mj42584/staircase_solidcraft_claude/CONCEPTION.md

# Conception — Escalier gab

Ce fichier décrit l'**état actuel** du projet et **le pourquoi des choix**. Les règles de travail avec l'agent sont dans [REGLES_SOLIDCRAFT_GITHUB_CLAUDE.md](REGLES_SOLIDCRAFT_GITHUB_CLAUDE.md).

## 1. Objectif

Escalier droit **à demi-tour**, deux volées séparées par un **palier intermédiaire sans différence de niveau**. Tout doit être **pilotable par des paramètres** : hauteur, giron, répartition des contremarches entre volées, profondeur du palier, largeur du jour.

## 2. Données d'entrée

Valeurs actuelles : voir les paramètres (§3). Ce tableau garde l'origine des données.

| Donnée | Origine |
|---|---|
| Hauteur totale (sol fini bas → sol fini haut) | **mesurée sur site** : dalle = sol fini bas, arrivée = dessus de la planche du cadre (`cadre_dessus` + `planche_ep`, §4) ; 3800 au départ → `hauteur_totale` |
| Angle de volée annoncé au départ | 32,4° — voir D1 |
| Répartition | choix de l'utilisateur dans l'app → `nb_volee1` — voir D2 ; volée 2 décalée d'un giron, voir D6 |
| Jour (vide entre volées) | 60 mm au départ, désormais calculé → `jour` — voir D9 |
| Marche | plaque (`marche_epaisseur`), deux équerres en cornière (`equerre_*`) symétriques |
| Limons | UPE 220, cotes **vérifiées au catalogue** EN 10365 (2026-10-26) → `limon_*` ; congés non modélisés (§4) — voir D8 |
| Palier | autoporté sur 4 pieds, sans appui sur le mur du site — voir D11 |
| Plancher du palier | même matériau et même épaisseur que les marches (`palier_ep` = `marche_epaisseur`) |
| Mains courantes | chêne carré (`mc_cote`, 45 × 45, choix de l'utilisateur, 2026-10-31), à `mc_h` au-dessus des nez, des deux côtés des deux volées, et autour du palier à `mc_palier_h`, continue avec les mains courantes ext des volées, sur potelets en fer plat fixés aux limons : choix de l'utilisateur (2026-10-30) ; profil et nombre des potelets **supposés** — voir D18 |
| Matériaux | marches, plancher et mains courantes en **chêne** (« Oak », 0,75 g/cm³) ; tout le reste en **acier S235** (nuance confirmée par l'utilisateur, 2026-11-08 ; « Steel », 7,85 g/cm³) — voir D13 |

## 3. Paramètres du modèle (`cad/escalier.solidcraft`)

**Pilotes**

| Paramètre | Valeur | Pilote |
|---|---|---|
| `hauteur_totale` | 3848 mm | hauteur de marche, arrivée |
| `nb_contremarches` | 22 | hauteur de marche, nb_volee2 |
| `nb_volee1` | 15 (16 jusqu'au 2026-10-31) | contremarches volée basse → hauteur du palier, nombre de marches V1 |
| `giron` | 274 mm | squelette, profondeur des marches, pas des réseaux |
| `emmarchement` | 1000 mm | largeur des volées et des marches, plans d'axe |
| `jeu_limons` | 200 mm | vide entre les deux limons intérieurs → `jour` (passé de 20 à 100, puis à 200 le 2026-11-07, par l'utilisateur) |
| `palier_profondeur` | 1000 mm | squelette (élévation et plan) |
| `marche_epaisseur` | 60 mm (passé de 30 à 60 par l'utilisateur) | marches, position des équerres, plancher du palier |
| `equerre_aile` | 50 mm | cornières (ailes égales) ; 30 avant D33 |
| `equerre_ep` | 5 mm | cornières ; 3 avant D33 |
| `equerre_longueur` | 200 mm | cornières, centrées sur le giron |
| `vis_d`, `vis_avant_d`, `vis_jeu` | 5, 3,5, 0,5 mm | vis à bois des cornières dans les marches (D35) : Ø nominal, avant-trou dans la marche (**supposé**), jeu du trou dans la cornière (Ø 5,5) |
| `vis_lef`, `vis_pas` | 50, 75 mm | vis à bois : longueur dans la marche (avant-trou) ; 3 vis par cornière à `giron / 2` et `± vis_pas`, au milieu de l'aile (**supposé**) |
| `debord` | 0 mm | débord du nez de marche vers l'avant |
| `limon_h` | 220 mm | hauteur UPE |
| `limon_b` | 85 mm | largeur des ailes UPE, pilote `jour` |
| `limon_tw` | 6,5 mm | épaisseur d'âme |
| `limon_tf` | 12 mm | épaisseur d'aile |
| `limon_r` | 0 mm | congé de laminage de l'UPE (catalogue : 13 mm, EN 10365), profilé des 4 limons (Frame Member) ; mis à 0 pour la vitesse de recalcul (D19) |
| `limon_dessus` | `-30 mm * giron / pas_volee` (−25,3 mm ; 0 jusqu'au 2026-10-29) | haut du limon au-dessus de la ligne de nez, perpendiculairement (0 = au ras des nez) ; négatif : limon descendu de 30 mm en vertical, pour centrer le bout du limon V1 sur la poutre avant (D17) |
| `palier_ep` | `marche_epaisseur` (60 mm) | plancher du palier |
| `platine_ep` | 15 mm | platines d'about : bas des limons V1 et V2 (côté palier) et haut des limons V2 (arrivée) ; les limons sont raccourcis d'autant |
| `boulon_d` | 12 mm | boulons des platines (M12) |
| `trou_jeu` | 2 mm | jeu des trous : largeur des oblongs = `boulon_d + trou_jeu` (14 mm) |
| `oblong_course` | 10 mm | course verticale des oblongs (entre centres d'arcs ; longueur totale 24 mm) |
| `boulons_entraxe` | 100 mm | entraxe vertical des 2 trous de chaque platine |
| `poteau_cote` | 100 mm | pieds : tube carré |
| `poteau_ep` | 5 mm | pieds : épaisseur du tube |
| `mc_h` | 900 mm | hauteur de l'axe des mains courantes au-dessus de la ligne des nez, en vertical |
| `mc_cote` | 45 mm | côté des mains courantes carrées pleines (chêne), choix de l'utilisateur (2026-10-31 ; avant : `mc_d`, rond Ø45) |
| `potelet_l` | 40 mm | potelets en tube carré : côté (choix de l'utilisateur, 2026-10-30 : 30 ; 40 depuis D34) |
| `potelet_ep` | 3 mm | potelets en tube carré : épaisseur de paroi (2 avant D34) |
| `nb_potelets_v1` | 5 | potelets par main courante V1 : 4 validés par l'utilisateur (2026-11-02), 5 depuis D32 ; pilote le nombre et le pas des trous |
| `nb_potelets_v2` | 3 | potelets par main courante V2 : 2 validés par l'utilisateur (2026-11-02), 3 depuis D32 ; pilote le nombre et le pas des trous |
| `mc_palier_h` | 1000 mm | hauteur de la main courante au-dessus du plancher du palier ; limite : `mc_palier_h - mc_h` < `hauteur_marche` (sinon le raccord V2 recule derrière le premier nez de V2) |
| `nb_potelets_fond` | 4 | potelets du fond du palier, angles compris, 3 validés par l'utilisateur (2026-11-02), 4 depuis D34 ; pilote le pas des trous du fond ; les potelets d'angle sont placés par `potelet_fond_marge` |
| `potelet_palier_retrait` | 215 mm | axe des potelets latéraux du palier (V1 et V2, face à face) depuis le bord avant du palier, et des potelets arrière depuis le bord arrière (D26) : `potelet_palier_v1_x` = `rive_x + potelet_palier_retrait` (choix de l'utilisateur, 2026-11-01 : 200 mm demandés, 215 pour que la platine haute du potelet V1 passe sous la partie horizontale, minimum ≈ 213 mm ; avant : milieu du palier) |
| `potelet_fond_marge` | 25 mm | potelets d'angle du fond : du trou extérieur de la platine haute au bout de la main courante du fond, **supposé** ; axe à `potelet_fond_y` = `jour / 2 + emmarchement + limon_b / 2 - mc_cote / 2 - platine_haut_entraxe / 2 - potelet_fond_marge` (1090 mm) du milieu du jour (D24) |
| `pied_limon_ep` | `platine_ep` (15 mm) | pied des limons V1 : épaisseur des platines verticale et au sol, **supposé** (D28) |
| `pied_limon_l` | 200 mm | pied des limons V1 : longueur de la platine au sol depuis le premier nez (largeur `limon_b`), **supposé** |
| `pied_limon_entraxe` | 80 mm | pied des limons V1 : entraxe des 2 trous Ø `boulon_d + trou_jeu` (chevilles M12 **supposées**) de la platine au sol, dans le U, centrés sur `pied_limon_l` |
| `platine_bas_l`, `platine_bas_b`, `platine_bas_ep` | 130, 50, 10 mm (8 avant D39) | platine basse des potelets, soudée (choix de l'utilisateur) |
| `platine_bas_trou` | 9 mm | trous de la platine basse (M8), percés aussi dans l'aile des limons, ou dans le plancher et l'aile du cadre au palier |
| `platine_bas_entraxe` | 100 mm | entraxe des 2 trous de la platine basse, de part et d'autre du potelet : ≈ 22 mm libres entre le potelet et le bord du trou (tête M8 + rondelle Ø16 + douille), 15 mm du trou au bout de la platine |
| `platine_haut_l`, `platine_haut_b`, `platine_haut_ep` | 100, 40, 5 mm | platine haute des potelets (largeur 30 avant D34, égale au tube) , soudée, vissée sous la main courante (choix de l'utilisateur) |
| `platine_haut_trou` | 5 mm | trous pour vis à bois Ø4,5 |
| `platine_haut_entraxe` | 80 mm | entraxe des 2 trous de la platine haute : ≈ 12 mm libres entre le potelet et le bord du trou (tête de vis à bois Ø9) |
| `poteau_r` | 10 mm | pieds : rayon extérieur du tube, **supposé** (défaut SolidCraft), à confirmer |
| `platine_pied_ep` | `platine_ep` (15 mm) | platines des pieds, en tête (boulonnée sous l'aile basse du cadre) et au sol (chevillée dans la dalle) (choix de l'utilisateur, 2026-10-31) |
| `platine_pied_marge` | 40 mm | platines des pieds : du tube au bord, **supposé** ; en tête, boulon au milieu de la marge sur l'axe de l'aile ; au sol, chevilles au milieu de la marge |
| `gousset_ep`, `gousset_l`, `gousset_h` | 10, 120, 120 mm | goussets des diagonales (D30), soudés sur la face du tube du pied tournée vers l'autre pied, dans le plan de la face, **supposé** ; trou Ø `boulon_d + trou_jeu` à mi-hauteur |
| `gousset_trou_l` | 70 mm | gousset : de la face du tube à l'axe du trou, **supposé** |
| `gousset_jeu_tete` | 50 mm | gousset haut : jeu sous la platine de tête (écrou M12 de la platine et clé), **supposé** ; le gousset bas est posé sur la platine au sol |
| `diag_cote`, `diag_ep`, `diag_r` | 40, 3, `2 * diag_ep` mm | diagonales : tube carré 40 × 40 × 3 (côté : choix de l'utilisateur, D36 ; 50 avant ; épaisseur **supposée**, D30) |
| `languette_ep`, `languette_trou_bout`, `diag_retrait`, `languette_insertion` | 10, 30, 120, 80 mm | diagonales : languette (fer plat `languette_ep` × `diag_cote`) soudée dans une fente du tube, boulonnée contre le gousset (1 M12) ; du trou au bout de la languette, du trou au bout du tube (dégage le gousset), longueur dans le tube, **supposé** |

**Calculés**

| Paramètre | Expression | Valeur |
|---|---|---|
| `hauteur_marche` | `hauteur_totale / nb_contremarches` | 174,91 mm |
| `nb_volee2` | `nb_contremarches - nb_volee1` | 7 |
| `angle_volee` | `atan(hauteur_marche / giron)` | 32,55° |
| `blondel` | `2 * hauteur_marche + giron` | 624 mm (confort 600–640) |
| `pas_volee` | `sqrt(giron ^ 2 + hauteur_marche ^ 2)` | 325,07 mm |
| `jour` | `2 * limon_b + jeu_limons` | 370 mm |
| `rive_x` | `(nb_volee1 - 1) * giron` | 3836 mm (X de la rive du palier) |
| `cadre_y` | `jour / 2 + emmarchement + limon_b` | 1220 mm (demi-largeur hors tout du cadre) |
| `limon_hv` | `limon_h * pas_volee / giron` | 261,0 mm (hauteur d'un limon en coupe verticale) |
| `pied_h` | `nb_volee1 * hauteur_marche - palier_ep - limon_h - platine_pied_ep` | 2328,6 mm (sol → dessous de la platine de tête ; le tube va de `platine_pied_ep` à `pied_h`) |
| `platine_pied_l` | `poteau_cote + 2 * platine_pied_marge` | 180 mm (côté des platines des pieds : en tête au ras de l'angle du cadre, au sol centrée sur le tube) |
| `diag_dy`, `diag_dz` | `2 * (cadre_y - poteau_cote - gousset_trou_l)`, `pied_h - platine_pied_ep - gousset_jeu_tete - gousset_h` | 2100, 2143,6 mm (entraxe des trous d'une diagonale, en travers et en hauteur) |
| `diag_longueur`, `diag_angle` | `sqrt(diag_dy ^ 2 + diag_dz ^ 2)`, `atan(diag_dz / diag_dy)` | 3000,9 mm, 45,6° |
| `diag_o_x`, `diag_o_y`, `diag_o_z`, `diag_o_d`, `diag_plan_n` | trou bas depuis l'angle du cadre (X, Y, profondeur), puis le long de la diagonale et distance de son plan à l'angle | 55, 170, 2268,6, 1501,6, 1709,0 mm |

**Cotes des esquisses** : préfixes `sqe_` / `sqp_` pour les squelettes d'élévation et de plan (convention de nommage : règles §7).

## 4. Architecture du modèle

**Repère** : origine au pied de la première contremarche, **au milieu du jour**. Volée 1 monte vers **+X** côté **Y négatif** ; volée 2 redescend en X (monte vers −X) côté **Y positif**. Z vers le haut.

**Timeline**

1. `Squelette élévation` (plan XZ, Z vers le haut, 0 DDL) — première contremarche, ligne des nez volée 1, palier horizontal à `nb_volee1 × h`, prolongé côté volée 2 d'un giron (ligne `l6`, au niveau du palier, vers −X), première contremarche volée 2 à `rive − giron`, ligne des nez volée 2 jusqu'à `hauteur_totale`.
2. `Squelette plan` (XY, 0 DDL) — emprise volée 1, palier pleine largeur (`2 × emmarchement + jour`), emprise volée 2.
3. `Axe volée 1` / `Axe volée 2` — plans de construction décalés de XZ de ∓(`jour/2 + emmarchement/2`).
4. `Foulée volée 1` / `Foulée volée 2` — ligne de nez projetée depuis le squelette d'élévation sur chaque plan d'axe.
5. `Profil marche V1` → `Marche V1` — rectangle accroché au premier nez projeté, extrudé symétrique sur `emmarchement`.
6. `Profil équerre V1` → `Équerre V1` (côté mur, « ext ») → `Symétrie équerre V1` (côté jour, « int ») par rapport à `Axe volée 1`.
7. `Réseau marches V1` — réseau sur chemin le long de `Foulée volée 1` : `nb_volee1 - 1` occurrences, pas `pas_volee`.
8. Idem volée 2 : `Profil marche V2`, `Marche V2`, `Équerre V2`, `Symétrie équerre V2`, `Réseau marches V2` (`nb_volee2` occurrences, marche orientée vers −X). `Profil marche V2` est accroché au nez du palier (`l2.end` du squelette) : la première marche V2 est **au niveau du palier**, entre `rive − giron` et la rive ; `Équerre V2` à `nb_volee1 * hauteur_marche - marche_epaisseur`. En plan, l'emprise V2 vaut `nb_volee2 * giron`.
9. `Rive ext V1` — plan décalé de `Axe volée 1` de `-emmarchement / 2` (bout des marches côté mur).
10. `Axe limon V1` (plan `Rive ext V1` : ligne des nez projetée en construction, ligne du bas du limon parallèle cotée `limon_h - limon_dessus`, prolongée de `limon_h` à chaque bout) → `Barre limon V1` (Frame Member, profilé `channel` piloté par `limon_h`, `limon_b`, `limon_tw`, `limon_tf`, `limon_r`, ancrage `bottom_right`, miroir : âme contre le bout des marches, ailes vers l'extérieur) → `Coupes limon V1` (U coté : coupe verticale à X = `pied_limon_ep`, horizontale à Z = `pied_limon_ep`, verticale à `rive_x - platine_ep`) → `Coupe limon V1` (enlèvement de `limon_b` ciblé sur le limon).
11. `Symétrie limon V1` — symétrie du **corps** `Limon ext V1` par `Axe volée 1` → `Limon int V1`.
12. Idem volée 2 : `Rive ext V2` (décalage `+emmarchement / 2` de `Axe volée 2`), `Axe limon V2`, `Barre limon V2` (ancrage `bottom_left`), `Coupes limon V2` (deux rectangles cotés : coupes verticales à l'arrivée et à `rive_x - platine_ep`), `Coupe limon V2`, `Symétrie limon V2` → `Limon ext V2`, `Limon int V2`.

13. `Dessus cadre palier` — plan XY décalé de `nb_volee1 * hauteur_marche - palier_ep` (dessus du cadre = dessous du plancher).
14. `Plancher palier` — rectangle coté X `rive_x` → `+ palier_profondeur`, Y ±`cadre_y`, extrudé de `palier_ep` vers le haut : il couvre tout le cadre, limons extérieurs compris.
15. **Pieds** : deux composants depuis D30, chacun de 4 pièces en sous-composants (D21) et **posé 2 fois**, tournés de 90° d'un angle à l'autre : `Ensemble pied gousset bas` (`:1` avant V1, `:4` arrière V2) et `Ensemble pied gousset haut` (copie indépendante, `component.paste_new` : `:1` arrière V1, `:2` avant V2 ; fonctions, cotes et corps suffixés `haut`). Les deux exemplaires d'un même type se déduisent l'un de l'autre par une rotation de 180° : même pièce. Repère local : origine à l'angle extérieur du **dessus de la platine de tête**, X et Y vers l'intérieur du cadre, Z vers le haut ; le pied pend vers le bas, si bien qu'un changement de `pied_h` allonge le tube vers le sol sans décoller la platine du cadre. Fonctions : plans `Dessous platine tête pied` (XY à −`platine_pied_ep`), `Sol pied` (XY à −(`pied_h` + `platine_pied_ep`)), `Axe pied` (XZ à `poteau_cote / 2`) ; esquisse `Platine tête pied` (carré `platine_pied_l` depuis l'origine, 2 trous Ø `boulon_d + trou_jeu` à (`limon_b / 2`, `poteau_cote + platine_pied_marge`) et symétrique) → extrusion `Platine tête` ; esquisse `Platine sol pied` (carré `platine_pied_l` centré sur le tube, 4 trous à `poteau_cote / 2 ± (poteau_cote / 2 + platine_pied_marge / 2)`) → extrusion `Platine sol` ; esquisse `Axe tube pied` (ligne verticale de `platine_pied_ep` à `pied_h` sous l'origine) → Frame Member `Tube pied` (`rect_tube`, corps `Pied`). Gousset (D30) : sous-composant `Gousset pied bas` (esquisse `Profil gousset pied bas` sur YZ à `poteau_cote / 2`, plaque de `poteau_cote` à `poteau_cote + gousset_l` posée sur la platine au sol) ou `Gousset pied haut` (XZ à `poteau_cote / 2`, plaque à `gousset_jeu_tete` sous la platine de tête), extrudés symétriques de `gousset_ep`. Cotes `pied_*` et `gousset_bas_*` / `gousset_haut_*`, 0 DDL. **Placement** : 4 liaisons rigides « en l'état » (`joint.as_built`) entre le cadre et chaque exemplaire, accrochées par leur nom au coin du dessous de l'âme de la poutre avant (`F48`) ou arrière (`F53`) : les pieds suivent `nb_volee1`, `palier_profondeur`, etc. (vérifié).
15 bis. **Diagonales** (D30) : `Ensemble diagonale` (racine, **posé 2 fois** : `:1` face avant, du gousset bas de `Ensemble pied gousset bas:1` au gousset haut de `Ensemble pied gousset haut:2` ; `:2` face arrière, tourné de 180°). Repère : celui du pied avant V1 (angle extérieur du dessous du cadre, axes du monde) ; liaisons rigides `Diagonale avant / cadre` et `Diagonale arrière / cadre` au coin de la poutre avant ou arrière, comme les pieds. Plans `Pente diagonale` (XY tourné de `diag_angle` autour de X) et `Plan diagonale` (décalé de −`diag_plan_n` : il contient l'axe de la diagonale, X normal à la languette) ; `Languette basse diagonale` / `Languette haute diagonale` (rectangles `languette_ep` × longueur sur `Plan diagonale`, extrudés symétriques de `diag_cote`, trou Ø `boulon_d + trou_jeu` coté depuis l'origine sur YZ à `diag_o_x`) ; `Tube diagonale` (axe à `languette_ep / 2` de la face du gousset, Frame Member `rect_tube`, corps `Diagonale`, de `diag_retrait` à `diag_longueur - diag_retrait`) et `Fentes tube diagonale` (2 fentes `languette_ep` × `languette_insertion` dans les parois). La languette s'appuie sur la face intérieure du gousset : l'axe du tube est décalé de (`gousset_ep` + `languette_ep`) / 2 = 10 mm du plan des pieds (excentricité non calculée).
16. Cadre en **onglet à 45°** : pour chaque poutre, une esquisse `Âme poutre …` (trapèze d'épaisseur `limon_tw`, extrudé de `limon_h` vers le bas, nouveau corps) et une esquisse `Ailes poutre …` (trapèze de largeur `limon_b`, extrudé deux fois de `limon_tf` : aile haute, et aile basse avec `start_offset`, jointes au corps). Les 4 UPE ont l'**âme à l'extérieur et les ailes vers l'intérieur**, pleine longueur jusqu'aux angles extérieurs, coupées à 45° : `Poutre avant palier`, `Poutre arrière palier`, `Poutre latérale V1`, `Poutre latérale V2`. Une esquisse et un corps par poutre, pour que les onglets jointifs ne fusionnent pas les corps.

17. **Mains courantes** (D18) : `Plan main courante V1` (décalé de `Axe volée 1` de −(`emmarchement / 2 + limon_b / 2`) : milieu du limon, demande de l'utilisateur) → `Axes main courante V1` (ligne des nez projetée et ligne du bas du limon en construction ; axe de la main courante parallèle à `mc_h` en vertical, du premier nez à `rive_x - platine_ep` ; premier potelet vertical à `giron / 2`, bas à `potelet_l / 2` en pente au-dessus de l'aile haute du limon, haut à `potelet_l / 2` en pente sous la main courante, pour qu'aucun coin ne pénètre) → `Barre main courante V1` (Frame Member `bar` carré `mc_cote`, `Main courante ext V1`) → `Symétrie main courante V1` (corps, par `Axe volée 1` → `Main courante int V1`). La ligne du premier potelet ne porte plus de pièce : elle place les platines de `Platines potelet V1`, d'où partent les perçages (étape 19). Idem V2 (`Plan main courante V2`, `Axes main courante V2`, main courante de l'arrivée `+ platine_ep` à `rive_x - giron` (premier nez de V2), premier potelet à `rive_x - 3 * giron / 2`). Les potelets eux-mêmes sont des sous-composants (étape 19).
18. **Main courante du palier** (D18), à `mc_palier_h` au-dessus du plancher : dans `Axes main courante V1`, prolongement de la main courante V1 dans son alignement jusqu'à `mc_palier_h`, puis horizontale jusqu'au fond ; dans `Axes main courante V2`, prolongement de V2 depuis le premier nez jusqu'à `mc_palier_h`, puis horizontale. En fin d'arbre (avant le dossier des trous) : `Plan section main courante palier V1` (plan perpendiculaire au début de la main courante V1, `l2` à t = 0) → `Section main courante palier V1` (carré `mc_cote` centré, 0 DDL) → `Main courante palier V1` (balayage le long de `l2`, `l5`, `l6`, **joint** à `Main courante ext V1` : une seule pièce de la volée au fond, coudes en onglet) ; idem V2. Le balayage repart du début de la barre (chevauchement), sinon l'union bout à bout laisse 2 coques (règles §8). Potelets du palier : sous-composants (étape 19). `Plan main courante fond` (YZ décalé au milieu de la poutre arrière, à `limon_b / 2` du bord du cadre) → `Axes main courante fond` → `Barre main courante fond` (entre les deux mains courantes latérales, bout à bout). Les mains courantes latérales du palier vont jusqu'à l'extérieur de celle du fond.
18 bis. **Mains courantes en pièces séparées** (D22, 2026-11-01) : les axes restent dans `Axes main courante V1/V2` (rampe `l2`, raccord `l5`, horizontale `l6`), mais chaque pièce est un **profil vu de côté extrudé symétriquement sur `mc_cote`**. Esquisse `Profil mains courantes V1` (racine, plan `Plan main courante V1`) : rampe et horizontale projetées en construction ; bande de `mc_cote` autour de la rampe (début d'équerre au début de la rampe) et autour de l'horizontale (fin verticale), séparées par la **ligne d'onglet** qui joint les intersections des bords (cotes `profil_mc_v1_*`, 0 DDL, 2 profils) → `Main courante rampe V1` (pièce `Main courante ext V1` : rampe + raccord, composant `Main courante ext V1`, ESC-701) et `Main courante palier V1` (horizontale, composant `Main courante palier V1`, ESC-706). Idem V2 (`Profil mains courantes V2`, ESC-703 et ESC-707). Mains courantes int : `Plan main courante int V1/V2` (décalé de l'axe de volée de ±(`emmarchement / 2 + limon_b / 2`)) et `Profil main courante int V1/V2` (bande autour de la rampe projetée, bouts d'équerre) → extrusion ; elles ne sont plus des symétries de la main courante ext. **Int V2 rallongée vers le bas** (demande de l'utilisateur, même jour) : la rampe est prolongée dans sa pente (ligne de construction colinéaire) jusqu'à `profil_mc_int_v2_fin_x` = `rive_x - platine_ep`, le même X que le haut de int V1 ; les deux bouts sont face à face de part et d'autre du jour, int V2 ≈ 19 mm plus haut (axe 3533 contre 3514 mm en 15/7). Les anciens Frame Member, balayages, plans et sections (`Barre main courante V1/V2`, `Symétrie main courante V1/V2`, `Main courante palier V1/V2` en balayage) sont supprimés.
19. **Potelets** (D18, D20) : 2 sous-composants, chacun un ensemble soudé de **3 pièces** (un sous-composant chacune, D21) : `Potelet volée`, `Platine basse potelet volée`, `Platine haute potelet volée` (idem `… palier` ; noms uniques dans tout le modèle, exigés par SolidCraft), avec ses esquisses dans son propre repère, origine au centre du dessous de la platine basse. `Ensemble potelet volée` **posé 16 fois** (`:1` à `:4` et `:13` ext V1, `:5` à `:8` et `:14` int V1, `:9`–`:10` et `:15` ext V2, `:11`–`:12` et `:16` int V2, tournés de 180° en V2 ; D32) : plan `Dessous platine basse potelet volée` (XY du composant : la platine basse est à plat dans son repère), `Axe potelet volée` (incliné de `angle_volee` dans le composant, vertical une fois posé, D27, `potelet_volee_h` = `mc_h - (mc_cote / 2 + limon_dessus) * pas_volee / giron`) → `Tube potelet volée` (Frame Member `rect_tube`) → `Coupe bas` / `Coupe haut potelet volée` (axe prolongé de `potelet_l` aux deux bouts, puis tube coupé en biais **au ras** du dessus de la platine basse et du dessous de la platine haute, plans `Bout bas` / `Bout haut potelet volée`) → `Platine basse potelet volée` (sur `Dessous platine basse potelet volée`) et `Platine haute potelet volée` (sur `Dessous platine haute potelet volée`), trous dans leurs esquisses, en corps séparés. `Ensemble potelet palier` **posé 8 fois** (`:1` palier V1, `:2` palier V2, `:3` à `:5` et `:8` fond, tournés de 90°, `:6` / `:7` arrière V1 / V2, D26; D34) : même construction à plat, hauteur `potelet_palier_h` = `mc_palier_h - mc_cote / 2`, tube au ras des platines. Chaque exemplaire est **lié par une liaison rigide au trou de son limon** (trou bas de la platine, `Potelet ext V1 n°1 / limon`, etc.) **ou du cadre** (`Potelet palier V1 / cadre`, `Potelet fond n°1 / cadre`, etc.) : il suit le perçage quand les paramètres changent. Les perçages restent à la racine et paramétriques : `Platines potelet V1` / `V2` (esquisses des platines sur `Axes main courante V1` / `V2`, sans fonction) → `Plan perçage limons V1` / `V2`, `Perçage limons V1` / `V2` (trous projetés, répétition d'esquisse `nb_potelets_v1` / `v2` ; les trous int de `Perçage limons V2` ne servent plus) et `Perçage limon int V2` (D25) → `Trous limon ext/int V1/V2` (commande Trou, profondeur `limon_tf + 1 mm`, dans les ensembles limon) ; `Plan perçage palier`, `Perçage palier` (10 trous + répétition du fond, pas `2 * potelet_fond_y / (nb_potelets_fond - 1)`) → `Trous palier` (plancher) et `Trous palier cadre`. Le **nombre d'exemplaires est fixe** (choix de l'utilisateur, 2026-11-01) : changer `nb_potelets_*` change les perçages, pas les potelets.

**Limons** : en Frame Member (étapes 10 et 12) : section réelle de l'UPE avec congés (33,9 cm², 26,6 kg/m) ; le profilé va d'un bout à l'autre de sa ligne, coupé d'équerre, d'où les esquisses de coupe. Platines : rectangles cotés (coin en X et en Z depuis l'origine, `platine_ep` × `limon_hv`). Cotes en distances positives, y compris sur les rives V2 (axe vertical vers −Z). Pied de V1 (D28) : limon coupé à `pied_limon_ep` du sol et du premier nez ; platine verticale contre la coupe verticale et platine au sol (2 trous dans le U), soudées au limon. En haut de V2 (arrivée), même détail que V1 côté palier : limon coupé verticalement à `(nb_volee1 - nb_volee2 - 1) * giron + platine_ep`, platine `Profil platine V2` → `Platine limon V2` en corps séparé (`Platine ext V2`), contre le plan vertical du dernier nez. `Symétrie limon V2` symétrise `Limon ext V2` et `Platine ext V2` → `Limon int V2` et `Platine int V2`. La structure d'arrivée est modélisée à part (`cad/environnement.solidcraft`, voir plus bas) ; l'assemblage platine / arrivée ne l'est pas. Côté palier : les **limons V1** sont coupés verticalement à `rive − platine_ep`, et une **platine d'about** (`Profil platine V1` → `Platine limon V1`, `platine_ep` × `limon_b` × hauteur du bout de limon) est un **corps séparé** (`Platine ext V1`), distinct du limon, à la demande de l'utilisateur. Cette fonction est insérée **avant** `Symétrie limon V1`, qui symétrise les deux corps (`Limon ext V1` et `Platine ext V1`) → `Limon int V1` et `Platine int V1`. La platine arrive contre l'âme de la poutre avant ; l'assemblage platine / poutre n'est pas modélisé. Les **limons V2**, côté palier, ont le même détail que V1 : coupés verticalement à `rive − platine_ep`, avec une platine d'about en corps séparé (`Profil platine palier V2` → `Platine palier limon V2` → `Platine palier ext V2`, sketch sur `Rive ext V2`, extrusion `limon_b`), insérée avant `Symétrie limon V2`, qui produit `Platine palier int V2`. Comme la volée 2 est décalée d'un giron (D6), la ligne de nez passe au niveau du palier à la rive ; la platine (V2 côté palier) s'arrête ≈ 20 mm sous le dessus du plancher (avec `limon_dessus` actuel). Bouts de limons sur la poutre avant (16/6, 60 mm) : V1 centré (2498 → 2759, poutre 2518,5 → 2738,5), V2 19 mm plus haut (2517 → 2778), écart dû aux platines sur des pentes opposées (2 × `platine_ep * hauteur_marche / giron`). Formules des hauts de platines (cotes `platine_*_haut_z`) : rive = `nb_volee1 * hauteur_marche + platine_ep * hauteur_marche / giron` ± décalages, haut = `hauteur_totale - platine_ep * hauteur_marche / giron` ± décalages. **Perçage des 6 platines** (strictement identiques, `ESC-250`, 15 × `limon_b` × `limon_h * pas_volee / giron` ; oblongs à la même distance du haut de platine ; côté V2, les 4 trous de la poutre avant sont donc 19,15 mm plus haut que côté V1) : 2 trous oblongs verticaux à ± `boulons_entraxe / 2` d'un centre : milieu de la platine à l'arrivée, **milieu de la poutre avant** côté palier (`nb_volee1 * hauteur_marche - palier_ep - limon_h / 2`). `Perçage platine V1` (plan YZ) → `Trous platine V1` (découpe de `Platine ext V1`, insérée avant `Symétrie limon V1`) ; `Perçage platines V2` (plan YZ, 4 oblongs) → `Trous platines V2` (découpe ciblée sur `Platine ext V2` et `Platine palier ext V2`, de `(nb_volee1 - nb_volee2 - 1) * giron` sur `nb_volee2 * giron`, insérée avant `Symétrie limon V2`). Les oblongs sont des rainures cotées en expressions (centres par rapport à l'origine, rayon, course, entraxe) (piège des oblongs, règles §8). Côté palier, V1 et V2 ont les mêmes trous, symétriques sur la poutre (16/6, 60 mm : 2578,5 / 2678,5). **Perçage de la poutre avant** : `Perçage poutre avant` (plan YZ, 8 cercles cotés en expressions) → `Trous poutre avant` (découpe de `Poutre avant palier` sur `limon_tw` depuis la rive) : trous **ronds** Ø `boulon_d + trou_jeu` (14 mm) dans l'âme, en face du **milieu** des oblongs des 4 platines côté palier ; le réglage se fait par les oblongs. Marges avec 100 / M12 (16/6, 60 mm) : côté V2, bas de l'oblong bas à ≈ 35 mm de la face intérieure de l'aile basse du limon ; trous ronds de la poutre à ≈ 36 mm de ses ailes (congés non modélisés). Les congés de laminage de l'UPE (r = 13 mm) sont modélisés sur les limons (Frame Member) mais ignorés sur le cadre du palier (section 33,1 cm² au lieu de 33,9, masse sous-estimée de 2,2 %).

**Un composant par pièce** (D20, D21) : chaque pièce réelle est un composant qui porte **ses esquisses et ses fonctions** ; les pièces soudées sont regroupées dans 8 ensembles de type « normal » (pas « inseparable », qui cacherait ses pièces dans la nomenclature) :
- `Ensemble cadre palier` → `Poutre avant palier` (avec `Perçage poutre avant` / `Trous poutre avant`), `Poutre arrière palier`, `Poutre latérale V1`, `Poutre latérale V2` ; chaque poutre a ses `Trous platines pieds poutre …` et `Trous palier poutre …` (esquisses `Perçage platines pieds` et `Perçage palier` partagées, plan `Dessous platines pieds` dans l'ensemble).
- `Ensemble limon ext V1/V2` → `Limon ext V1/V2` (Frame Member, coupes, `Trous limon ext V1/V2`), `Platine verticale pied ext V1` et `Platine sol pied ext V1` (D28 ; leurs symétries `… int V1` dans `Ensemble limon int V1`), `Platine ext V1`, `Platine ext V2`, `Platine palier ext V2` (chacune avec ses trous ; esquisse `Perçage platines V2` dans l'ensemble) ; `Ensemble limon int V1/V2` → `Limon int …` (`Symétrie limon V1/V2`, trous) et une symétrie par platine (`Symétrie platine V1`, `Symétrie platine V2`, `Symétrie platine palier V2`).
- `Ensemble pied gousset bas` (posé 2 fois) → `Platine tête pied`, `Platine sol pied`, `Tube pied`, `Gousset pied bas` ; `Ensemble pied gousset haut` (2 fois) → mêmes pièces suffixées `haut` ; `Ensemble diagonale` (2 fois) → `Tube diagonale`, `Languette basse diagonale`, `Languette haute diagonale` ; `Ensemble potelet volée` (12 fois) et `Ensemble potelet palier` (7 fois) → `Tube potelet …`, `Platine basse potelet …`, `Platine haute potelet …`. Les plans de construction restent dans l'ensemble.
- À la racine, un composant par pièce : `Plancher palier` (et `Trous palier`), `Main courante ext/int V1/V2`, `Main courante palier V1/V2`, `Main courante fond`, et un composant par réseau : `Marches V1/V2`, `Équerres ext V1/V2`, `Équerres int V1/V2` (trois réseaux par volée, D21). Squelette, plans d'axe, esquisses partagées et paramètres restent à la racine.
Composants imbriqués des ensembles posés une fois et composants de la racine **fixés** (grounded) ; ceux des ensembles posés plusieurs fois **libres** (fixés, ils ne suivent plus leur exemplaire). Esquisses et éléments de construction masqués. **Références** (`part_number`, choix de l'utilisateur 2026-11-01) : `ESC-` + 3 chiffres, une centaine par famille, l'ensemble en 0 ; pièces identiques sous la même référence (volumes et cotes vérifiés) : cadre `ESC-100` (poutres 101 avant, 102 arrière, 103 latérale V1 et V2, fusionnées le 2026-11-08 : même pièce) ; ensembles limon ext V1 200, int V1 210, ext V2 220, int V2 230 (limons 201, 211, 221, 231 ; les 6 platines d'about `ESC-250`, strictement identiques (ext et int V1, ext et int V2 à l'arrivée et au palier ; oblongs placés par rapport au haut de la platine, en référence à V1) ; platines de pied V1, ext et int : `ESC-260` sol, `ESC-261` verticale) ; pied à gousset bas 300 et à gousset haut 310 (tube 301, platine tête 302, platine sol 303, gousset 304, communs) ; potelet de volée 400 (tube 401), potelet de palier 410 (tube 411), platines basses 402 et hautes 403 communes aux deux ; marches 500, équerres 510, plancher 600, mains courantes 701 à 707 (ext V1, int V1, ext V2, int V2, fond, palier V1, palier V2) ; diagonale 800 (tube 801, languettes 802). Nomenclature (Inspecter › Vérifier › Nomenclature ; `assembly.bom {levels: top, group_children: true}`) : 16 lignes, les pièces sous chaque ensemble ; `levels: flat` : une ligne par référence. Marches et équerres comptent par composant (réseau), pas par corps.

**Trous des vis à bois** (D35) : par volée, `Perçage vis marche V1/V2` (6 cercles Ø `vis_avant_d`, 0 DDL, sur le dessous des marches) → `Avant-trous vis marche V1/V2` (coupe de `vis_lef` dans `Marche V1/V2`, avant le réseau) et `Perçage vis équerre V1/V2` (Ø `vis_d + vis_jeu`) → `Trous vis équerre ext/int V1/V2` (coupe de `equerre_ep` dans chaque cornière, avant les réseaux d'équerres) ; les copies de réseau portent les trous. **Les vis ne sont pas modélisées** (choix de l'utilisateur, 2026-11-03).

**Point d'intégration de la marche** : nez de marche, face supérieure, milieu de la largeur — c'est le point par lequel passent les lignes de nez du squelette.

Nombre de marches : chaque volée a une marche de moins que de contremarches (la dernière contremarche arrive sur le palier ou l'arrivée). Exception : la volée 2 a une marche de plus, au niveau du palier (D6). Avec 15/7 : 14 + 7 = 21 marches (palier à 2623,6 mm, rive à X = 3836, première contremarche V2 à X = 3562, arrivée à X = 1918).

**Environnement et assemblage**

**Site** (photos du 2026-10-27, mesures au téléphone à quelques cm près) : grange, dalle béton = sol fini. **Arrivée** sur un cadre en acier brut (plateforme ≈ 2,57 × 5,51 m, planche dessus), tout en **IPE 200** pour l'instant, sur poteaux avec platines au sol. **V2 arrive perpendiculairement à la poutre de 2,57 m**, en venant de l'extérieur du cadre. Autres mesures : 2,95 m sur le mur depuis une poutre grise, 1,45 m entre deux poteaux au sol, 1,1 m entre une attache de solive et l'angle du cadre. Environnement modélisé à part : **cadre rouillé, sol, mur en pierre** ; la charpente grise est ignorée (choix de l'utilisateur). Vue de dessus (croquis de l'utilisateur) : mur le long du grand côté, 6 poteaux (3 par petit côté ; 4 dans le modèle, voir ci-dessous), 2 solives parallèles au mur ; **V2 côté mur**, palier hors du cadre, **V1 côté extérieur, qui passe sous le cadre** entre le poteau du milieu et le poteau avant côté arrivée (1,45 m libres, mesure faite avec les 6 poteaux).

**`cad/environnement.solidcraft`** (2026-10-27, SolidCraft 0.24.1) : repère **X = 0 sur la face côté escalier de la poutre d'arrivée** (cadre vers −X), **Y = 0 sur la face côté mur du cadre** (cadre vers −Y, mur vers +Y), Z = 0 dessus de dalle. Paramètres : `cadre_longueur` 3788 (croquis, à confirmer, §7), `cadre_largeur` 2670, `cadre_dessus` 3788, `planche_ep` 60, `ipe_h/b/tw/tf` 200/100/5,6/8,5, `poteau_milieu` 1400 (axe depuis la face côté mur), `poutre_mur_longueur` 5510 (poutre le long du mur prolongée **au-delà** du cadre côté escalier, sens à confirmer, §7), `mur_ecart` 50, `mur_ep` 500, `mur_h` 3800, `dalle_ep` 200 ; 4 poteaux (poteaux avant supprimés par l'utilisateur). Poutres et poteaux en **Frame Member** (onglet Mécano-soudure, profilé `i_beam` piloté par `ipe_*`). **Esquisses cotées** (demande de l'utilisateur : des cotes pilotées par paramètres, pas des points en expressions) : lignes horizontales / verticales, cotes depuis l'origine en expressions (`d16`… `d53`), 0 DDL partout. Corps : `Poutre mur`, `Poutre avant`, `Poutre arrivée`, `Poutre fond`, `Solive 1`, `Solive 2` (à 1/3 et 2/3), 4 poteaux `Poteau mur/milieu arrivée/fond` (âme suivant Y), `Planche`, `Dalle`, `Mur` (plaques). Contrôles à la création : encombrements OK, 1450 libres entre poteaux, dessus planche à 3848 ; test `cadre_largeur` 2570 → 2700 → 2570 OK. Ni porte, ni matériaux. Ajouté par l'utilisateur (2026-11-07, 0.30.1) : plan `Limite pour acces` (face du mur en X 5610, décalée de `acces_limite` −3000, soit X 2610) et une ouverture dans le mur (`Esquisse ouverture acces` → `Ouverture acces`, découpe traversante) : `acces_l` 1000 de large, `acces_h` 1700 de haut, à `acces_retrait` 200 au-delà du plan (X 2810 → 3810), bas à Z ≈ 458 **non coté** (esquisse à 1 DDL) ; `acces_coupe` −200 (profondeur de la découpe, qui traverse pourtant les 500 du mur).

Hauteur libre au-dessus de V1 sous la poutre d'arrivée : `cadre_dessus − ipe_h − (nb_volee1 − nb_volee2) × hauteur_marche` = **2,19 m** en 15/7 (calculé, cotes du cadre mesurées au téléphone), au-dessus des 2 m conseillés (point fermé le 2026-11-02).

**`cad/projet_escalier.solidcraft`** (2026-10-27) : assemblage, **composants liés** `Environnement` (à l'origine, fixé / grounded) et `Escalier`, décalé de **[−1918, −1446,6, 0]** : X = −(`nb_volee1` − `nb_volee2` − 1) × `giron` (15/7 ; −2466 en 16/6, −3014 en 17/5), platine du haut de V2 plaquée contre `Poutre arrivée` ; Y choisi par l'utilisateur (jeu V2 / face du cadre, §7) ; Z = 0, pieds sur la dalle. L'escalier est **fixé (grounded)** lui aussi, contre les déplacements accidentels : le libérer avant de le repositionner, puis le refixer.

## 5. Journal des décisions

- **D1 — Angle calculé, non piloté.** 32,4° est incohérent avec giron 274 et hauteur 172,73 (arctan → 32,23°). On pilote hauteur totale + nombre de contremarches + giron ; l'angle en découle.
- **D2 — Répartition pilotable.** Départ 17/5 (palier à 2936 mm). L'utilisateur est ensuite passé à **16/6** dans l'app, puis à **14/8** un temps, puis de nouveau à **16/6**, revenu à **17/5** (2026-10-26), à **16/6** (2026-10-27) et enfin à **15/7** (2026-10-31) ; 15/7 est la valeur actuelle. Le modèle suit ces changements sans erreur.
- **D3 — Ensemble marche intégré au squelette, pas en fichier lié.** SolidCraft permet un composant lié (`component.insert_design`), mais les paramètres ne traversent pas les fichiers et le réseau sur chemin n'accepte pas les composants. Intégré, la marche est pilotée directement par `giron` et `emmarchement`.
- **D4 — Réseau sur chemin plutôt que rectangulaire.** Le chemin est une courbe du squelette : la direction suit l'angle de volée. Le nombre d'occurrences accepte une expression (vérifié).
- **D5 — Débord sans cote nulle.** SolidCraft refuse une cote de 0. L'arrière de la marche est coté depuis le nez (`giron`) et la longueur totale vaut `giron + debord`.
- **D6 — Volée 2 décalée d'un giron.** Au départ, volée 2 à l'aplomb du nez du palier (disposition classique). Changé à la demande de l'utilisateur (2026-10-26) : la première marche de V2 est au niveau du palier et la première contremarche V2 recule d'un giron (`rive − giron`). Cela règle la jonction limon V2 / palier (D12). L'escalier s'allonge d'un giron.
- **D7 — Pas d'exports versionnés** (2026-10-31, choix de l'utilisateur ; avant : STL et aperçu régénérés à chaque modification de géométrie). Seuls les `.solidcraft` sont dans le dépôt ; un export (STL, STEP, image) se fait à la demande et n'est pas commité (`.gitignore`). Pas de Git LFS : les fichiers sont petits. Exception (2026-11-08, choix de l'utilisateur) : les DXF de découpe laser, versionnés dans `plans/dxf/` ; à régénérer si une tôle change.
- **D8 — Limons UPE 220, ailes vers l'extérieur.** Comparé : fer plat 300×10 (≈ L/300), UPE 160 (≈ L/120 sur 4,1 m, trop souple, et l'équerre L 200 ne rentre pas entre les ailes), UPE 200 (≈ L/255), UPE 220 (≈ L/345). Avec `limon_dessus = 0`, la zone boulonnable de l'âme (≈ 170 mm) couvre l'équerre (≈ 45 → 177 mm sous la ligne de nez). Ordres de grandeur seulement, pas un calcul de structure.
- **D9 — Jour calculé depuis les limons.** Les ailes des deux limons intérieurs se font face dans le jour : `jour = 2 * limon_b + jeu_limons`. Le jeu est libre (`jeu_limons`).
- **D10 — Symétrie de corps, pas de fonctions.** Une symétrie des fonctions « âme + ailes » joignait les ailes copiées au limon d'origine (l'extrusion des ailes est une jonction ciblée) : on symétrise le corps entier.
- **D11 — Palier : cadre UPE + plancher dessus + 4 pieds.** Pas de mur autour. Cadre de 4 UPE (même profil que les limons, piloté par `limon_*`), âmes à l'extérieur, ailes vers l'intérieur, angles coupés à 45° et soudés (demande de l'utilisateur : poutres latérales retournées de 180° par rapport à la première version), plancher posé dessus (détail : §4, étapes 13 à 16). La poutre avant reçoit les 4 limons ; le bout du limon V1 est centré sur sa hauteur, celui de V2 19 mm plus haut (§4, D17). Pieds aux 4 coins (`poteau_*`). Liaison pied / cadre (2026-10-31, choix de l'utilisateur) : platine de tête (corps séparé dans le modèle, comme les platines des limons, soudée au pied en réalité), boulonnée par 2 M12 sous l'aile basse des deux UPE de l'angle, démontable (plutôt que pied soudé sous le cadre). Au sol, même principe : platine en corps séparé, centrée sous le pied, 4 chevilles.

- **D12 — Jonction limon V2 / palier par décalage de la volée.** But de l'utilisateur : supprimer la face verticale du limon V2 qui dépassait au-dessus du palier. Une première version (limon prolongé et posé sur le plancher) a été écartée : on a plutôt ajouté une contremarche à la volée 1 (15/7 → 16/6) et mis la première marche V2 au niveau du palier (D6). Toutes les contremarches restent égales. Le limon V2 arrive à la rive au ras du palier et couvre toute la hauteur de la poutre avant.

- **D13 — Matériaux.** Chêne pour les 21 marches (17/5) et le plancher du palier, acier pour limons, platines, équerres, cadre et pieds. Masse totale **1 146,0 kg** (acier 750,2, chêne 395,8) en 15/7 avec des marches de 60 mm, mains courantes et 19 potelets (`measure`, 154 corps, 2026-11-02 ; ≈ 893 kg en 17/5 avec des marches de 30 mm). Pour la masse, `measure` donne chaque corps de chaque exemplaire avec son matériau ; `assembly.mass_properties` ne détaille que le premier exemplaire d'un ensemble posé plusieurs fois. L'affectation se fait par nom de corps (`material.assign`) ; elle tient au recalcul et quand un corps de réseau disparaît puis revient (test 17 → 16 → 17) ; piège des corps nouveaux : règles §7.

- **D14 — Prédimensionnement par script Python** (`calc/predim.py`, bibliothèque standard seule). Il reprend à la main les paramètres du §3 et vérifie, en ordres de grandeur : marches (flexion et flèche, D30), limons V1 / V2, poutre avant (4 réactions de limons + demi-palier), flambement des pieds (libres en tête, L_cr = 2 H), cisaillement des boulons M12. Hypothèses : q = 2,5 kN/m², Q = 2 kN (AN française, cat. A), chêne D30, acier **S235 supposé**, boulons 8.8 supposés, flèche L/300. Résultats (en 3800 / 17/5 / 30 mm, voir §7) : **marches de 30 mm insuffisantes** (contrainte 100 %, flèche 6,3 mm pour 3,3 admis, **38 mm minimum**) ; limons, poutre avant, pieds et boulons à ≤ 12 %. Le limon V1 donne une flèche de 2,0 mm sur 5,18 m (≈ L/2580), bien moins que les ≈ L/345 de D8 : les hypothèses de charge de D8 ne sont pas connues, on garde le script comme référence. Pas un calcul de structure.

- **D15 — Modèle en barres PyNite** (`calc/portique.py`, PyNiteFEA 3.2, paramètres et hypothèses importés de `predim.py`). Barres : 4 pieds, cadre du palier (poutre avant coupée aux 4 limons), 4 limons, liaisons rigides courtes pour l'excentricité des platines sur l'âme de la poutre avant (≈ 29 mm, centre de cisaillement de l'UPE à 32 mm de l'âme). Appuis (choix de l'utilisateur) : **pieds et pieds de limons V1 encastrés** (platines chevillées dans une dalle béton, à terme), haut des limons V2 articulé (boulonné à la structure supérieure), limons articulés sur la poutre avant. **Pas de garde-corps** pour l'instant : seules forces horizontales = défauts de verticalité EN 1993-1-1 (φ ≈ 1/253). Les marches ne relient pas les limons (côté sécurité). UPE 220 : A et I fort du catalogue, Iz (244 cm⁴) et J (11,6 cm⁴) calculés sans congés. Résultats ELU (en 3800 / 17/5 / 30 mm) : déplacement horizontal du palier 0,12 mm, poutre avant 7 % en flexion et 9 % en torsion (Saint-Venant), pieds 1 %, limons V1 11 %. Efforts aux appuis : poteau N 7,3 kN, M 0,15 kN·m ; **pied de limon V1 N 10,4 kN, V 5,6 kN, M 6,2 kN·m** ; **arrivée V2 N 5,3 kN, V 5,7 kN**. Équilibre vérifié (43,5 kN de charges = réactions). Le palier est tenu horizontalement par les limons (effet de bracon entre la dalle et l'arrivée), pas par les pieds.

- **D16 — Visualisation PyVista directe** (`calc/visu.py`). Le module `Pynite.Rendering` impose IPython et trame (pile Jupyter) : écarté, on dessine directement avec PyVista à partir des résultats de `portique.py`. Deux vues en projection parallèle, côté V1 : moment fléchissant |M| ELU_X en couleur, déformée ELS_X × 300 sur la géométrie initiale ; appuis en points noirs. Sans écran : `xvfb-run -a python3 calc/visu.py --png DOSSIER`. Les liaisons rigides (excentricité des platines) ne sont pas dessinées.

- **D19 — Limons sans congés de laminage** (2026-10-30, choix de l'utilisateur). `limon_r` 13 → 0 : les congés de l'UPE faisaient reprendre les booléens des perçages (§6.3) ; recalcul complet 50 → 33 s. Modèle −2,1 % d'acier par limon (127,0 → 124,3 kg pour le limon ext V1) ; l'UPE acheté garde ses congés et le calcul prend les valeurs du catalogue. 0 erreur, 0 interférence.

- **D18 — Mains courantes sur potelets** (2026-10-30, choix de l'utilisateur : deux côtés, chêne Ø45, puis carré 45 × 45 le 2026-10-31, 900 mm, potelets sur limons). Potelets en tube carré 30 × 30 × 2 (d'abord fer plat 40 × 10, remplacé à la demande de l'utilisateur ; rayon d'angle par défaut de SolidCraft), la main courante à leur aplomb, **au milieu des limons et des poutres du cadre** (demande de l'utilisateur, 2026-10-30 ; d'abord contre l'âme) : les potelets des volées sont posés et fixés sur l'aile haute du limon, plus contre l'âme. Symétrie des corps avant les réseaux, et un réseau par corps : les noms des potelets restent justes quand leur nombre change (le piège des réseaux à plusieurs corps, règles §8, est évité). Fixation (choix de l'utilisateur, 2026-10-30) : platine basse soudée au potelet, boulonnée M8 sur l'aile haute du limon (ou à travers le plancher dans l'aile du cadre au palier) ; platine haute soudée, vissée sous la main courante (vis à bois) ; platines parallèles à la pente sur les volées, potelets coupés en biais (plus de jour). Simplifications : visserie non modélisée, potelets du palier posés sur le plancher (platine et boulonnage dans l'aile haute du cadre non modélisés). Palier (même jour, choix de l'utilisateur) : main courante à 1000 mm, continue avec les mains courantes ext des volées (sur ≈ 157 mm au bord du palier, elle passe de 900 à 1000 mm) ; mains courantes ext d'une seule pièce de la volée au fond du palier, coudes en onglet (balayage d'un carré joint à la barre de la volée ; d'abord Pipe rond en pièce séparée) ; les mains courantes V2 s'arrêtent au premier nez de V2. Remplissage du garde-corps à venir. Revue du 2026-11-02 : hauteurs conformes à la NF P01-012 (dessus de la main courante à 922,5 mm au-dessus des nez, 1 022,5 mm au-dessus du palier) ; main courante int V1 à 16,6 mm du `Poteau milieu arrivée` dans le projet, acceptée par l'utilisateur. Masse des mains courantes et potelets : ≈ 69 kg en rond Ø45, ≈ 75 kg en carré (mains courantes 26,6 kg de chêne).

- **D20 — Pièces soudées en sous-composants, avec leurs fonctions** (2026-11-01, demande de l'utilisateur). Une première version (2026-10-31) ne déplaçait que les corps (`component.move_bodies`, fonctions `BodyTransfer`) ; refaite pour que chaque ensemble porte son historique (`component.move_features`). SolidCraft refuse de déplacer une fonction qui touche des corps de plusieurs composants : d'où les perçages scindés (§4). Une fonction d'un ensemble peut s'appuyer sur une esquisse de la racine, et une symétrie sur un corps d'un autre ensemble (vérifié). Les 4 pieds sont **un seul composant posé 4 fois** (idée de l'utilisateur), placé par des liaisons rigides au cadre plutôt que par un décalage chiffré, qui ne suivrait pas les paramètres (règles §8). Contrôles : 112 corps aux volumes, matériaux et centres de gravité identiques à avant (seuls les noms des pièces des pieds changent) ; 0 erreur, 0 interférence ; allers-retours `nb_volee1`, `palier_profondeur`, `jeu_limons`, `poteau_cote`, `platine_pied_ep`. Limites : le projet d'assemblage ne voit qu'un bloc `Escalier` à plat ; la nomenclature ne liste que les composants, pas les corps restés à la racine. Platines d'about des limons soudées au limon, puis boulonnées au reste (confirmé par l'utilisateur, 2026-11-02). Potelets (2026-11-01, demande de l'utilisateur : « la même logique pour les potelets ») : 2 composants posés 12 et 5 fois, liés aux trous des limons et du cadre ; les 17 nouveaux potelets recouvraient exactement les anciens (interférence = volume entier, 255 328 et 271 881 mm³) avant suppression de l'ancien arbre (Frame Member, coupes, platines, symétries, réseaux) ; 0 erreur, 0 interférence ; allers-retours `nb_volee1`, `giron`, `palier_profondeur`, `mc_h`, `potelet_l` sans erreur ni interférence, potelets recalés sur les trous. Puis (même jour, demande de l'utilisateur) chaque potelet en 3 corps dans le même composant, comme le pied : le tube ne pénètre plus les platines (sinon interférence), il est coupé au ras ; cela comble un jour qui existait côté haut de la pente sous la platine haute (le tube s'arrêtait à l'axe), volume +192 mm³ par potelet de volée ; 0 erreur, 0 interférence (146 corps). Limite : nombre d'exemplaires fixe (12 + 7 potelets, 4 pieds), accepté par l'utilisateur le 2026-11-02 ; au palier, la liaison tient au trou de l'aile du cadre, pas au dessus du plancher (un changement de `palier_ep` laisserait les potelets du palier à l'ancienne hauteur).

- **D21 — Un composant par pièce** (2026-11-01, demande de l'utilisateur : « un composant pour chaque corps avec les fonctions qui lui sont liées dedans »), pour une nomenclature qui liste les pièces. Exception choisie par l'utilisateur : marches et équerres restent en réseaux (le nombre suit `nb_volee1`), un composant par réseau ; chaque réseau de marches est scindé en trois (marche, équerre ext, équerre int), ce qui règle le piège des noms (§6.3). Fonctions qui touchaient plusieurs pièces scindées (perçages du cadre, `Trous platines V2`, symétries des limons). Les liaisons accrochées au cadre et aux limons ont été reprises sur les composants imbriqués ; pieds et potelets ont été dépliés (copies supprimées, fonctions rangées dans le premier exemplaire, copies reposées aux mêmes matrices et reliées). Contrôles : 146 corps aux volumes, encombrements et matériaux identiques ; 0 erreur ; 0 interférence ; essai `nb_volee1` 16 + `giron` 280 + `palier_profondeur` 1200 identique pièce par pièce au même essai sur `main` (CLI), sauf les noms des marches et équerres, désormais justes. Les ensembles passent de « inseparable » à « normal ». Nomenclature : marches et équerres comptées par réseau (2 et 4 lignes, pas 21 marches et 42 équerres), gardé pour que leur nombre suive `nb_volee1` (choix de l'utilisateur, 2026-11-02).

- **D22 — Mains courantes ext : rampe et palier en deux pièces** (2026-11-01, demande de l'utilisateur : rampe + raccord d'une pièce, horizontale du palier d'une autre ; « retracer chaque pièce proprement »). Chaque pièce est construite directement à sa longueur par un profil vu de côté extrudé sur `mc_cote`, l'onglet au raccord étant une arête commune des deux profils (pas de découpe puis retrait). Int V2 rallongée jusqu'au X du haut de int V1 (+259 mm en plan, 3 913 540 → 4 535 766 mm³). Contrôles : volumes ext + palier = ancienne main courante (V1 11 259 301 mm³, V2 6 497 179 mm³) ; int V1 identique, int V2 identique avant rallonge ; 148 corps, volume total inchangé ; 0 erreur ; 0 interférence ; essai `nb_volee1` 16, `giron` 280, `mc_h` 1000, `mc_palier_h` 1100, `mc_cote` 50 identique à `main` pièce par pièce (ext + palier = ancienne main courante, même encombrement).

- **D23 — Potelets latéraux du palier près du bord avant** (2026-11-01, demande de l'utilisateur, capture à l'appui) : les deux potelets du palier (`Potelet palier V1/V2`) passent du milieu du palier à `potelet_palier_retrait` du bord avant, pour soutenir le début des mains courantes du palier (D22). À 200 mm, la platine haute du potelet V1 chevauchait le bout en pente de la rampe ext V1 avant l'onglet (1 356 mm³) ; l'utilisateur a choisi 215 mm pour les deux. Perçages du plancher et du cadre et potelets suivent (liaisons aux trous) ; 0 interférence ; essai `nb_volee1` 16, `palier_profondeur` 1200, `giron` 280 : potelets toujours au retrait du bord, 0 erreur. Distance fixe gardée (choix de l'utilisateur, 2026-11-02) : avec `mc_h` 850 (ou `mc_palier_h - mc_h` plus grand), l'onglet de la rampe ext V1 recule et touche le potelet V1 (tube 2 554 mm³, platine haute 10 797 mm³) ; à 1000, rien ; contrôler les interférences si ces paramètres changent.

- **D24 — Potelets d'angle du fond rentrés sous la main courante du fond** (2026-11-02, choix de l'utilisateur). Le potelet d'angle était centré sur le bout de la main courante du fond (65 mm du bord du cadre) : le trou extérieur de sa platine haute tombait sous la main courante latérale du palier, à 5 mm de sa face extérieure (2,5 mm de chêne autour d'une vis Ø4,5). Il est rentré de 65 mm (`potelet_fond_marge`, 25 mm **supposé**) : ses deux vis sont dans la main courante du fond, la platine basse reste sur l'aile de la poutre arrière (le trou extérieur passe de la poutre latérale à la poutre arrière, liaison `Potelet fond n°1 / cadre` reprise sur la poutre arrière). Le pas de la répétition du fond suit désormais `potelet_fond_y` (il était resté à l'ancienne expression). 0 erreur, 0 interférence ; essai `emmarchement` 1100, `jeu_limons` 150, `mc_cote` 50, `palier_profondeur` 1200 : vis toujours à 25 mm du bout, 0 interférence.

- **D25 — Premier potelet de int V2 en face du dernier de int V1** (2026-11-02, choix de l'utilisateur). Avec int V2 rallongée (D22), le bout dépassait de 408 mm après le premier potelet de int V2 (`Ensemble potelet volée:11`, X = `rive_x - 3 * giron / 2`). Ses trous sont maintenant dans une esquisse à part, `Perçage limon int V2` (plan `Plan perçage limons V2`, points de `Platines potelet V2` projetés) : paire basse décalée le long de la pente de `(giron - platine_ep) * pas_volee / giron`, soit X = `rive_x - platine_ep - giron / 2` comme le dernier potelet de int V1 (`:8`), répétition propre jusqu'au potelet du haut, qui ne bouge pas (`:12`, en face de `:10`). Porte-à-faux ramené à 149 mm, comme int V1. `Trous limon int V2` pointe sur la nouvelle esquisse ; les liaisons ont suivi (noms des trous inchangés). Les potelets int V2 ne sont plus en face des ext V2 en bas. La répétition de `Perçage limons V2` ne pouvant pas perdre ses trous int (SolidCraft refuse de changer les entités d'une répétition, et supprimer une entité la défait), ces trous y restent, inutilisés. 0 erreur, 0 interférence ; essai `nb_volee1` 16, `giron` 280, `nb_potelets_v2` 3 : 0 erreur, 0 interférence.

- **D26 — Un potelet de plus à l'arrière de chaque main courante latérale du palier** (2026-11-02, demande de l'utilisateur). Depuis D24, le potelet d'angle du fond est sous la main courante du fond : chaque main courante latérale du palier ne tenait plus que sur son potelet avant. Deux exemplaires de plus de `Ensemble potelet palier` (`:6` côté V1, `:7` côté V2), symétriques des potelets avant : axe à `rive_x + palier_profondeur - potelet_palier_retrait` (X 4621), sur l'axe des poutres latérales ; 4 trous ajoutés à `Perçage palier` (cotes `percage_palier_arriere_*`), percés dans le plancher et les poutres latérales par les découpes existantes (tous les profils) ; liaisons rigides `Potelet palier arrière V1/V2 / cadre` au trou côté avant de la platine. Écartement 570 mm avec le potelet avant, ≈ 195 mm de main courante au-delà vers le fond ; platine basse à 82 mm de celle du potelet d'angle. 0 erreur, 0 interférence ; essai `nb_volee1` 16, `palier_profondeur` 1200 : potelets toujours à 215 mm du bord arrière, 0 interférence.

- **D27 — Potelets de volée verticaux quel que soit le giron** (2026-11-02, demande de l'utilisateur). Les liaisons des 12 potelets de volée accrochaient le potelet par un repère figé dans son composant, incliné de l'angle de volée du moment de la pose (32,55°), alors que la platine basse s'inclinait de `angle_volee` dans le composant : quand `giron` changeait, tout le potelet tournait de l'écart (≈ 1° à `giron` 280). Le composant est retourné : platine basse à plat dans son repère (plan `Dessous platine basse potelet volée`, ex-`Pente potelet volée`, à 0°), tube incliné de `angle_volee` (esquisse `Axe potelet volée` : angle `potelet_volee_axe_angle` avec l'axe Z projeté, distance `potelet_volee_axe_haut` de l'origine au haut de l'axe) ; plans, coupes et platine haute inchangés (même position relative au tube). Les 12 liaisons `Potelet … / limon` ont leur repère côté potelet au centre du trou de la platine basse, normale à la platine, indépendant de l'angle. Contrôles : 154 corps identiques à avant (volume et encombrement) ; 0 erreur, 0 interférence ; `giron` 280 et 260 : les 12 tubes font 30 mm de large en plan (verticaux), 0 interférence.

- **D28 — Pied des limons V1 : platine verticale et platine au sol** (2026-11-02, choix de l'utilisateur). Chaque limon V1 est raccourci de `pied_limon_ep` au sol et au premier nez (`Coupes limon V1`, cotes `coupes_limon_v1_pied_x/z`). Deux platines soudées au limon, dans `Ensemble limon ext V1` (composants `Platine verticale pied ext V1`, `Platine sol pied ext V1`, esquisses sur `Rive ext V1` retourné, extrusion `limon_b`) et par symétrie dans `Ensemble limon int V1` : verticale de X 0 à `pied_limon_ep`, de `pied_limon_ep` jusqu'au dessus du limon (`hauteur_marche + limon_dessus * pas_volee / giron + pied_limon_ep * hauteur_marche / giron`) ; au sol, `pied_limon_l` × `limon_b` × `pied_limon_ep`, 2 trous Ø `boulon_d + trou_jeu` à `pied_limon_l / 2 ± pied_limon_entraxe / 2`, au milieu du U (entre l'âme et le bord des ailes), accessibles par le côté ouvert du U (≈ 130 mm sous l'aile haute). Le bout de l'aile basse du limon s'arrête vers X ≈ 205 mm (calculé, non mesuré), juste au-delà des 200 mm de la platine. Contrôles : platines 177 843 et 250 383 mm³ (trous compris), limons V1 −75 034 mm³ chacun, rien d'autre ne bouge (158 corps) ; 0 erreur, 0 interférence ; essai `giron` 280, `nb_volee1` 16, `emmarchement` 1100, `pied_limon_ep` 20, `pied_limon_l` 220 : platines et coupes suivent, 0 interférence, retour identique. Dalle non percée (projet en suspens).

- **D29 — Stabilité du palier recalculée** (2026-11-02, demande de l'utilisateur : contreventement du palier). `predim.py` et `portique.py` en 3848 / 15/7 / 60 mm ; dans `portique.py`, pieds des limons V1 **articulés** (D28), poussée sur les mains courantes `q_gc` = 0,6 kN/m **supposée** (cat. A, AN française, à confirmer), sur toutes les lignes à la fois, dans le sens des défauts de verticalité et à l'axe des barres, et tête des pieds calculée **rigide puis articulée** (platine à 2 M12, entre les deux). En long (X) : 0,04 mm, les limons font bracon. **En travers (Y)**, seuls les 4 pieds en console tiennent le palier : tête rigide 3,2 mm (40 % de H/300), pied de poteau M = 2,9 kN·m (≈ 10 kN par cheville M12) ; tête articulée **11,5 mm (141 %)**, M = 5,2 kN·m (≈ 18 kN par cheville, ordre de grandeur, bras de levier 140 mm). Limons vérifiés en flexion forte + faible (poussée) : V1 31 % ; pieds 42 % ; le reste ≤ 11 % ; marches de 60 mm à 25 %. Corrigés au passage : signe de l'effort normal des pieds (PyNite compte la compression positive, il était soustrait), barres « rigide » ramenées de 1e12 à 1e10 (au-delà, PyNite rejette le système, mal conditionné par ce palier souple en Y). Rapport complet : `calc/rapport_calcul.pdf` (source `calc/rapport/rapport_calcul.html`, figures `calc/rapport/figures.py`, PDF par LibreOffice), qui remplace le rapport du 2026-10-27. Ordres de grandeur, pas un calcul de structure.

- **D30 — Contreventement du palier en travers : une diagonale en tube par face d'about** (2026-11-03, choix de l'utilisateur, plutôt qu'une croix de tirants : un tube travaille dans les deux sens). Dans `portique.py`, une diagonale en face avant (sol en −Y → tête en +Y) et une en face arrière, en sens inverse, articulées en tête d'un pied et au pied de l'autre ; tube 50 × 50 × 3 **supposé** ; poussée et défauts calculés dans les deux sens, et avec G favorable (1,0) pour le soulèvement. Résultats (tête des pieds rigide / articulée) : palier en travers **0,28 / 0,29 mm** (11,5 mm sans diagonales) ; diagonales 8,7 kN, **31 %** au flambement (L = 3,46 m, à l'axe du cadre), 7 % en traction ; pieds 6 / 4 % (L_cr = H). Pied de poteau : N 13,1 kN, V 6,2 kN, M 0,3 kN·m, **soulèvement 4,3 kN** ; le reste inchangé (limons V1 31 %). Le jeu des trous des goussets (2 mm) n'est pas compté. Ordres de grandeur, pas un calcul de structure. **3D** (même jour, option « goussets sur les pieds » choisie par l'utilisateur, plutôt que des platines propres sous le cadre et au sol) : 2 types de pieds (gousset bas / haut, §4 étape 15) et un `Ensemble diagonale` posé 2 fois (étape 15 bis), 1 M12 par bout (articulation, comme le calcul). Une première version liée au trou du gousset ne suivait pas les paramètres (liaison sur un sous-composant libre d'un ensemble posé plusieurs fois : piège ajouté aux règles §8) ; refaite avec l'origine à l'angle du cadre et liée à la poutre. Les nœuds réels ne sont pas ceux du calcul : trous à 170 mm des angles du cadre en travers, à 75 mm du sol et 125 mm sous le cadre (diagonale 3,00 m à 45,6°, contre 3,46 m d'axe en axe dans `portique.py`). Contrôles : volumes des pièces conformes au calcul (gousset 142 461 mm³, languette 113 461, tube 1 477 537 ; diagonale 13,4 kg) ; 168 corps ; 0 interférence ; essai `nb_volee1` 16, `palier_profondeur` 1200, `jeu_limons` 150, `emmarchement` 1100, `poteau_cote` 120 ensemble : 0 erreur, 0 interférence, trous des languettes dans l'axe de ceux des goussets (encombrements au dixième de mm), retour identique. **Calcul recalé** sur ces nœuds (même jour, demande de l'utilisateur) : goussets en barres rigides soudées aux pieds, de l'axe du pied (angle du cadre dans le modèle) au trou, soit 170 mm au lieu de 120 (côté sécurité pour la flexion des pieds) ; tête rigide / articulée : diagonales 8,4 / 8,9 kN, **25 %** au flambement (L = 3,00 m), 7 % en traction ; pieds 9 / 14 % ; palier en travers 0,27 / 0,32 mm ; soulèvement 4,4 kN ; chevilles des poteaux **2,5 kN** de traction par cheville (1,8 avant) ; le reste à ±1 %.

- **D31 — Revue externe du calcul, garde-corps non conforme** (2026-11-03, revue DeepSeek transmise par l'utilisateur ; suite donnée au §8 du rapport). `predim.py` : poids des mains courantes et potelets (65,6 kg, `assembly.mass_properties`) en G, potelets en console sous `q_gc` à hauteur de main courante (pas relevé dans le modèle : 1 403 mm en pente sur V1, 1 090 au fond) et vis M8 de leur platine basse (2 vis dans l'axe du limon, bras de levier `platine_bas_b / 2`). `portique.py` : efforts par cheville, assertion d'équilibre de chaque combinaison, torsion de Saint-Venant des limons seuls sous le couple de la poussée (hors modèle, borne haute). Résultats : **potelets 30 × 2 à 255 % (volées) et 213 % (fond), vis M8 à 111 %, torsion des limons V1 seuls à 331 %** (marches non comptées) ; chevilles ≤ 1,8 kN de traction et 3,6 kN de cisaillement (résistance non fournie) ; le reste inchangé à ±2 %. Non retenus : longueur de main courante (2 limons V1 + 2 V2 = 15,9 m de barres, confirmé par l'équilibre), L_cr à l'axe du cadre (côté sécurité), plancher 2/3 de α_h (norme). Ordres de grandeur, pas un calcul de structure.
- **D32 — Un potelet de plus par main courante de volée** (2026-11-03, demande de l'utilisateur, après la revue du calcul : potelets 30 × 2 à 255 %, vis M8 à 111 %, D31). V1 passe de 4 à 5 potelets, V2 de 2 à 3, **premier et dernier en place**, les autres répartis : pas de V1 1182 → 887 mm en plan (1402,7 → 1052 le long de la pente), pas de V2 ext 1355 → 677,5 mm et int 1914,8 → 957,4 mm le long de la pente. Les répétitions d'esquisse `Perçage limons V1` et `Perçage limons V2` (`pat1`) prennent maintenant `nb_potelets_v1` / `nb_potelets_v2` en nombre et en pas (`((nb_volee1 - 1) * giron - giron - platine_ep) / (nb_potelets_v1 - 1) / cos(angle_volee)` pour V1, `((nb_volee2 - 2) * giron - platine_ep) / (nb_potelets_v2 - 1) / cos(angle_volee)` pour V2 ext) ; `Perçage limon int V2` le faisait déjà. Les 4 fonctions `Trous limon ext/int V1/V2` listent les points des trous ajoutés (`p17`–`p20` pour V1, `p11`–`p14` ext V2, `p7`/`p8` int V2) : **un point oublié = pas de trou**, la fonction garde sa liste. Les liaisons des potelets existants suivent leur trou ; 4 exemplaires de plus (`:13` à `:16`), posés par `occurrence.copy` + translation d'un pas puis liés au trou du dernier groupe (`joint.as_built`, `circle`), 0 DDL. 180 corps (+12 : 4 potelets × 3 pièces ; 168 → 180), limons −1,5 cm³ chacun (2 trous), 0 erreur, 0 interférence (180 corps contrôlés) ; essais `nb_volee1` 16 + `giron` 280, `palier_profondeur` 1200 + `emmarchement` 1100 : 0 erreur. `predim.py` : `nb_potelets_v1` = 5 (V2 non contrôlé, §7). Calcul **non relancé** avec ces pas (potelets V1, vis M8).
- **D33 — Cornières des marches en 50 × 50 × 5** (2026-11-03, demande de l'utilisateur, d'après l'essai des marches comme traverses : l'aile de 30 mm donnait un bras de levier de ≈ 15 mm aux vis à bois, ≈ 25 mm avec 50). Seuls `equerre_aile` et `equerre_ep` changent (30 × 3 → 50 × 5, longueur `equerre_longueur` inchangée). Volume d'une cornière 34 200 → 95 000 mm³ (section 475 mm², arêtes vives), 42 cornières, ≈ +20 kg d'acier ; 180 corps, 0 erreur, 0 interférence ; essai `nb_volee1` 16, `giron` 280, `marche_epaisseur` 40 : 0 erreur. **Non vérifié** : soudure de l'aile sur l'âme, trous de fixation des marches (pas modélisés), tenue de l'aile en flexion sous les vis (≈ 300 MPa estimés, voir l'essai), poids des cornières dans `predim.py` (`equerres_g`, déjà à 50 × 50 × 5 en essai).
- **D34 — Potelets en tube 40 × 40 × 3, un potelet de plus au fond** (2026-11-03, demande de l'utilisateur ; d'abord calculé dans `predim.py` : potelets V1 191 % → 73 %, fond 213 % → 55 %, vis M8 84 %). `potelet_l` 30 → 40, `potelet_ep` 2 → 3 (**épaisseur supposée** : la demande s'arrêtait à « 40 par 40 par », 3 mm confirmé par l'utilisateur), `platine_haut_b` 30 → 40 (la platine haute ne doit pas être plus étroite que le tube) ; le reste suit les paramètres. `nb_potelets_fond` 3 → 4 : le pas des trous du fond `2 * potelet_fond_y / (nb_potelets_fond - 1)` passe de 1090 à 726,7 mm (le motif `Perçage palier` prend `nb_potelets_fond` et ce pas ; les découpes du plancher et de la poutre arrière prennent tous les profils, rien à ajouter) ; 8ᵉ exemplaire de `Ensemble potelet palier` (`:8`) à y = 1090, lié au trou de la poutre arrière (`Potelet fond n°4 / cadre`, 0 DDL) ; les n°2 et n°3 ont suivi leurs trous (y = −363,3 et 363,3). 183 corps (+3), 0 erreur, 0 interférence ; essai `nb_volee1` 16, `palier_profondeur` 1200, `emmarchement` 1100, `mc_cote` 50 : 0 erreur. **Non vérifié** : vis des platines hautes à 40 mm de large (trous Ø5 entraxe 80 mm, marge latérale 17,5 mm), vis M8 à 84 % (inchangée). Ensuite (même jour) : `predim.py` actualisé, poids des potelets 40 × 40 × 3 (16 × 3,489 + 8 × 3,742 kg, `g_gc` +≈ 20 %, effet ≤ 2 % sur les autres taux) et potelets de V2 contrôlés (ext pas 804 mm : 56 %, vis M8 64 % ; int pas 957 mm : 67 %, vis M8 76 %) ; `portique.py` relancé, résultats inchangés à ±1 %.
- **D35 — 3 vis à bois par cornière, trous seulement dans le modèle** (2026-11-03, demande de l'utilisateur). Calcul : `K_VIS` = 7e7 N·mm/rad (plafond), limons V1 en torsion 11 %, vis la plus tendue 66 % de l'arrachement (ρk 530, D40) (`predim.py`, `portique.py`). Modèle : avant-trous Ø `vis_avant_d` dans les marches et trous Ø `vis_d + vis_jeu` dans les cornières, aux positions du calcul (§4) ; les 126 vis ne sont pas modélisées (poids du recalcul : 126 corps, 12 réseaux). Essai `nb_volee1` 16, `giron` 280, `vis_pas` 60 : 0 erreur.
- **D36 — Diagonales en tube 40 × 40 × 3** (2026-11-03, demande de l'utilisateur, après essai de 50 × 50 × 5 en cornière : 98 % au flambement en idéal, excentricité en plus, écartée). `portique.py` : flambement 43 % (tête rigide) / 46 % (articulée) pour L = 3001 mm et 8,0 / 8,6 kN (50 × 50 × 3 : 23 / 25 %), traction 8 %, palier en travers 0,31 / 0,37 mm, chevilles ≤ 2,3 kN en traction et 1,5 kN au pied des poteaux. Modèle : `diag_cote` 50 → 40, tout suit (languettes, fentes `diag_cote + 2 mm`, tube) ; 0 erreur, 0 interférence. Rapport mis à jour (valeurs). Ordres de grandeur, pas un calcul de structure.
- **D37 — Chevilles des pieds vérifiées avec des hypothèses** (2026-11-03, demande de l'utilisateur ; béton C25/30 non fissuré, choix de l'utilisateur sur ma proposition). `predim.py` : cheville M12 8.8 **supposée** (`hef` 70 mm, formules EN 1992-4 de mémoire : cône, acier, levier, bord), groupe loin des bords, `gM` béton 1,8 ; `portique.py` : contrôles par appui. Résultats : pieds de poteau T 1,95 kN (cône 16 %), V 1,47 kN (6 %) ; pieds de limons V1 V 3,61 kN (levier 15 %) ; interaction ≤ 8 %. **Non fournis** : référence de la cheville (ETA), épaisseur de la dalle, distances au bord (le cisaillement vers un bord n'est pas conclu : `c_min` de l'ETA, ordre de 100 mm). À remplacer par l'ETA ; ordres de grandeur, pas un calcul de structure.
- **D38 — Vérifications locales et une seule volée chargée** (2026-11-03, demande de l'utilisateur). `calc/assemblages.py` (nouveau, lancé après `predim.py`) : soudure gousset / pied (a 3,5 supposé) 14 %, boulon M12 des diagonales 27 %, languette (pression diamétrale 15 %, section nette 13 %, soudure dans les fentes 6 %), diagonale avec l'excentricité (5 mm au plan de contact, flexion amplifiée) 52 % ; **platine basse des potelets 8 mm : 106 %** (tronçon en T, mode 2 avec effet de levier ; 10 mm → 84 %, la vis M8 gouverne) ; aile du limon sous les M8 84 % ; déversement de la poutre avant (ailes libres, L 2440) 17 %, limons tenus par les marches ; poutre avant flexion + gauchissement (couples R × 30 mm des 4 limons, fourches) 19 % ; **couple de la poussée sur la poutre arrière : 98 %** en torsion de Saint-Venant (borne haute ; latérales 40 %) ; fréquences propres ≥ 19 Hz (limon V1 19, V2 77, poutre avant 25 ; repère 5 Hz supposé). `portique.py` : combinaisons `_V1seul` / `_V2seul` (une volée déchargée) : aucun résultat ne change. Plancher du palier : couvert par la vérification des marches (même chêne 60 mm, portée ≤ 1000 mm). Ordres de grandeur, pas un calcul de structure.
- **D39 — Platine basse des potelets en 10 mm** (2026-11-03, choix de l'utilisateur après D38 : 8 mm à 106 % avec l'effet de levier). `platine_bas_ep` 8 → 10 : 84 % (la vis M8 gouverne) ; dans le modèle, platines +25 % de volume, tubes raccourcis de 2 mm par le bas, haut inchangé ; 0 erreur, 0 interférence. Poids des platines dans `predim.py` (`g_gc`) non repris (+0,1 kg par potelet, négligeable).
- **D40 — Suite de la seconde revue externe** (2026-11-03, revue DeepSeek transmise par l'utilisateur). Rapport recalé sur le code : cornières 50 × 50 × 5 (14,8 N par marche, marche 138,1 N), mains courantes et potelets 112,4 kg (0,061 N/mm), w_G V1 0,640 N/mm ; les tableaux venaient déjà du code. `portique.py` : équilibre vérifié aussi en moments (moments nodaux des marches compris ; une erreur de 10 % est détectée), `construire()` articulé par défaut, auto-contrôle sur un modèle neuf, commentaire sur 1e10. `predim.py` : `limons_et_poutre_avant()` (réactions, moment de la poutre avant), utilisé par `assemblages.py` (plus de lecture de `lignes`, réactions V2 réelles : fréquence de la poutre avant 25 → 29 Hz) ; **`rho_k` 700 → 530 kg/m³** (D30, EN 338 de mémoire) : arrachement des vis à bois 53 → 66 %. Non retenu : exposants de l'éq. (8.39) de l'EC5 (bien négatifs), échelle de couleurs de `visu.py`.

- **D17 — Limons descendus de 30 mm** (2026-10-29, demande de l'utilisateur). Avec le plancher de 60 mm posé sur le cadre, la poutre avant était 30 mm trop bas par rapport aux bouts de limons : trous excentrés, écrous difficiles d'accès près des ailes. Plutôt que de toucher au palier, `limon_dessus` = −30 mm vertical : V1 centré sur la poutre, V2 à 19 mm, entraxe 100 retrouvé. Effets : les marches dépassent de 30 mm au-dessus des limons (moitié de leur épaisseur), la platine V2 côté palier ne dépasse plus du plancher, les équerres sortent du congé bas de l'UPE (≈ 20 mm de marge). Ne règle pas l'accès aux écrous des limons intérieurs, côté jour (`jeu_limons`, §7).

## 6. Outils et pièges du projet

Les règles de travail et les pièges de SolidCraft sont dans [REGLES_SOLIDCRAFT_GITHUB_CLAUDE.md](REGLES_SOLIDCRAFT_GITHUB_CLAUDE.md) ; ce chapitre ne garde que ce qui est propre à ce projet.

### 6.1 Versions des logiciels (poste local de l'utilisateur)

| Logiciel | Rôle | Référence | Vérifier avec |
|---|---|---|---|
| SolidCraft (Flatpak utilisateur `io.tangencylabs.solidcraft`, installé depuis les releases GitHub de `tangency-labs/solidcraft`, pas Flathub) | modèle 3D | **0.30.1** (les 3 modèles au format 48, sans cache, le 2026-11-07 ; le projet garde les instantanés STEP des modèles liés, 1,3 Mo). Lancer l'app avec `flatpak run --user --share=network io.tangencylabs.solidcraft --control 27878` : sans `--share=network`, le connecteur (lancé avec cette option) ne la joint pas | `flatpak info --user io.tangencylabs.solidcraft` |
| Connecteur MCP SolidCraft | pilotage du 3D par l'agent | celui de l'app, port 27878 | `~/.claude.json` |
| `solidcraft-cli` | tests de paramètres hors de l'app (§6.2) | celle de l'app (même Flatpak) | `flatpak run --user --command=solidcraft-cli io.tangencylabs.solidcraft --help` |
| Python 3 | calculs | 3.13.5 | `python3 --version` |
| PyNiteFEA | modèle en barres (`portique.py`) | **3.2**, non installé : environnement temporaire `uv run --no-project --with PyNiteFEA==3.2 python3 portique.py` (2026-11-02, Python 3.14 de uv) | `pip show PyNiteFEA` |
| PyVista, NumPy | visualisation (`visu.py`) | **0.49.2**, environnement Python `~/.venvs/escalier` (avec PyNiteFEA 3.2, matplotlib) ; hors écran : `PYVISTA_OFF_SCREEN=true` | `~/.venvs/escalier/bin/pip show pyvista numpy` |
| Claude Code | agent | à relever | `claude --version` |

SolidCraft change de format de fichier à chaque version : les modèles sont au format 46 (0.29.0) et ne s'ouvrent plus en 0.28 ni avant ; la version 0.27.1 de `main` avant la PR de mise à jour reste au format 44. Depuis 0.27, l'identifiant Flatpak a changé (`ai.storyteller.solidcraft` → `io.tangencylabs.solidcraft`) et l'extension par défaut des nouveaux modèles est `.sc` ; nos `.solidcraft` s'ouvrent et s'enregistrent sous leur nom.

### 6.2 Fichiers et dossiers

- **Connecteur MCP** : lancé avec `--allow-path "<projet>/cad"` (`~/.claude.json`), il enregistre directement dans `cad/` (règles §4).
- **Fichiers liés** : `cad/escalier.solidcraft`, `cad/environnement.solidcraft`, `cad/projet_escalier.solidcraft`.
- **Non versionné** : les photos du site, le verrou `cad/.~escalier.solidcraft.lock` (l'app ouvre directement `cad/escalier.solidcraft`).
- **Tests de paramètres hors de l'app** (2026-10-31) : méthode dans les règles (§5). Mesuré sur `escalier` (`mc_cote`, `mc_h`, `nb_volee1` aller-retour) : app (trous suspendus) 92 s ; CLI à la suite 114 s, dont ≈ 30 s d'ouverture ; 3 CLI en parallèle 92 s ; ≈ 25–30 s par recalcul, retour instantané.

### 6.3 Pièges connus

- **Potelets** (piège des unions face contre face, règles §8) : jusqu'au 2026-11-01 les tubes étaient enfoncés dans les platines pour faire un seul corps ; depuis, tube et platines sont des corps séparés, au contact (plus d'union, donc plus de piège) ; les anciennes cotes `coupe_potelet_v*_penetration*` sont supprimées avec l'ancien arbre.
- **Vitesse après les ensembles (D20, mesure du 2026-11-01)** : `solidcraft-cli`, `inspect.parameter_sweep` et durée d'ouverture (somme des fonctions), 2 passages identiques, fichier d'avant les PR #17 / #18 (commit `8cf3c5d`) contre `main` après la PR #18 : recalcul complet 27,0 → **7,7 s** ; `nb_volee1` 15 → 16 : 27,7 → **8,3 s** ; `mc_h` 900 → 1000 : 23,0 → **6,9 s** ; `potelet_l` 30 → 40 : 15,6 → **1,2 s** ; script complet 93 → 25 s ; 173 → 131 fonctions. Gain : potelets 10,9 → 1,2 s (une pièce calculée une fois et posée 17 fois, plus d'union tube-platines ni de reprises du booléen), `Trous limons V1` 6,4 s → `Trous limon ext V1` + `int V1` ≈ 4,2 s (perçage scindé par limon). Restent les plus lents : trous des limons V1 (≈ 2 s chacun), coupes en biais du potelet de volée (1,2 s). **Après un composant par pièce (D21, mesure du 2026-11-01, 0.29)**, même méthode, 2 passages, fichier d'avant la PR #23 (commit `81bb3a7`) contre `main` après la PR #23 : recalcul complet 7,5 → 7,5–7,7 s ; `nb_volee1` 15 → 16 : 8,2–8,4 → 8,1–8,3 s ; `mc_h` 900 → 1000 : 6,7–6,8 → 6,9 s ; `potelet_l` 30 → 40 : 1,2–1,3 → 1,4 s ; `giron` 274 → 280 : 7,4 → 7,4–7,5 s ; script complet 32 s dans les deux cas ; 131 → 144 fonctions. **Pas d'écart mesurable** : les fonctions scindées sont des découpes rapides ; les plus lentes restent `Trous limon ext/int V1` (≈ 2 s chacune).
- **Perçage des limons V1 lent** (0.27.1) : `Trous limons V1` prend 25 à 40 s à chaque recalcul (reprises du booléen « Boolean retry » sur le profilé UPE), alors que `Trous limons V2` prend 3 s ; une extrusion-enlèvement est aussi lente. Chaque renommage de paramètre relance le recalcul : l'app a planté pendant un lot de 30 renommages (2026-10-30, sauvegarde automatique récupérée). Contournement : suspendre `Trous limons V1` et `V2` (`timeline.suppress`) pendant les gros lots de modifications, puis les réactiver ; renommer par petits lots. Diagnostic du 2026-10-30 (aucun essai gardé) : recalcul complet 50 s, dont 20,5 s pour `Trous limons V1` (32 reprises : tolérance affinée puis décalage de l'outil de 0,0099 mm, pour chaque trou) ; les fonctions à reprises (trous des limons, platines des potelets et leurs trous) font ≈ 45 s sur 50. Ni une profondeur plus grande, ni l'extrusion-enlèvement des platines étendue aux limons (mêmes reprises, même décalage) n'y changent rien : c'est le booléen sur les corps `Limon ext/int V1` (21 faces, rien d'anormal) qui coince dans le noyau, pas la façon de percer. Pas de correctif côté modèle trouvé ; signalé : tangency-labs/solidcraft#9724 (cache de géométrie non enregistré : probablement #4443). Test `limon_r` 13 → 0 (annulé) : recalcul complet 50 → 33 s, `Trous limons V1` 20,5 → 7,1 s (reprises 32 → 10), `Trous limons V2` 3,2 → 1,0 s ; limon ext V1 127,0 → 124,3 kg (−2,1 %) ; les arrondis du profilé sont la cause principale. Platines des potelets (avertissement « Boolean retry ») : `coupe_potelet_v1_penetration` et `coupe_potelet_v2_penetration` passés de `potelet_l + 1 mm` à `potelet_l + 3 mm` (le potelet entre de 3 mm dans la platine basse au lieu de 1) : plus de reprise, `Platine basse potelet V1` 4,2 → 1,1 s, `V2` 2,4 → 0,6 s, recalcul complet 33 → 30 s, 0 erreur, 0 interférence. Même essai sur les platines hautes (`…_penetration_haut` à +3) : aucun effet, laissé à +1 ; leurs reprises ont une autre cause. Dossier de timeline `Trous limons et palier (suspendre pour travailler)` (`Trous limons V1`, `Trous limons V2`, `Trous palier`, ≈ 24 s) : le suspendre d'un clic pendant les modifications. Les platines des potelets et leurs trous ne peuvent pas y entrer (un dossier = fonctions contiguës, et elles doivent rester avant les réseaux de potelets) : un changement de `mc_h` prend encore ≈ 23 s dossier suspendu. Revenir à des valeurs déjà calculées est instantané (résultats réutilisés).
- **Noms des corps des réseaux de marches** : réglé (D21, 2026-11-01) par trois réseaux par volée, un par corps (`Réseau marches`, `Réseau équerres ext`, `Réseau équerres int`) : en 16/6, `Marche V1 (k)` et `Équerre ext/int V1 (k)` suivent la position (k = 1 à 15, pas d'un giron). Matériau des corps ajoutés quand `nb_volee1` augmente : non vérifié (avant : « Default », règles §7).

### 6.4 État des lieux des logiciels

*SolidCraft 0.27.1 → 0.29.0* (2026-11-01, Flatpak des releases GitHub, somme SHA256 vérifiée) : les 3 modèles mesurés par `solidcraft-cli eval` en 0.27.1 puis en 0.29.0 : escalier 146 corps, environnement 13, projet 159, volumes, matériaux, encombrements et masses identiques, 0 erreur (avertissements connus de `Trous limon ext/int V1`) ; escalier 0 interférence dans l'app ; aller-retour `nb_volee1` 15 → 16 → 15 et `mc_h` 900 → 1000 → 900 sans erreur (CLI : 11,0 s et 6,8 s, contre 8,3 et 6,9 s en 0.27.1, §6.3) ; réenregistrés sans cache au format 46 (un premier enregistrement, fait avant le redémarrage de l'app, était resté au format 44). Nouveautés **testées** :
- `check_parameters {set, report}` (outil MCP) : essaie une ou plusieurs valeurs ensemble, rend erreurs, avertissements et mesures, puis remet le modèle (`restored: true`, vérifié) ; `nb_volee1` 16, puis `mc_h` 1000 + `giron` 280 : 0 erreur, ≈ 24 s pour les deux. `report: ["errors"]` : la mesure liste les 146 corps (très long).
- `expect {volume_mm3, bodies, bbox}` sur `execute` / `batch` : volume (146 corps, 622 152 986 mm³) et encombrement justes → `ok` ; valeurs fausses → erreur qui nomme chaque écart, modèle gardé tel quel.
- Oblong (modèle jetable) : `sketch.slot.center_to_center` refuse toujours les expressions, mais l'oblong dessiné en chiffres puis coté (rayon `(boulon + jeu) / 2`, entraxe des centres, côté vertical) est à 0 DDL et suit les paramètres (vérifié : 12 → 16, 10 → 20, volume juste). Les rainures cotées actuelles restent valables ; pas de changement du modèle.
- `assembly.mass_properties` (escalier, 15/7) : masse par exemplaire, total **1141,28 kg** = `solidcraft-cli eval` (1141,3) ; acier 745,9, chêne 395,3. Racine (marches, plancher, mains courantes) 406,6 kg, cadre 173,0, limons ext/int V1 118,4 chacun, V2 63,3 chacun, pied 40,9 (× 4), potelet de volée 2,01 (× 12), potelet de palier 2,13 (× 5). Il donne aussi les groupes rigides (liaisons `joint.as_built`) : cadre + 4 pieds + 5 potelets du palier 347,1 kg, chaque limon avec ses potelets. Réponse longue (≈ 90 Ko).
- Nomenclature (`assembly.bom`, `top` ou `flat`, `group_children`) : une ligne par ensemble « inseparable » avec son nombre (pieds 4, potelets 12 et 5 : 8 lignes, 26 exemplaires), mais **pas les pièces dessous** : `children` ne liste que des sous-composants (achetés, avec référence), pas les corps d'un ensemble. Les corps de la racine (marches, plancher, mains courantes) n'y sont pas. Pour lister les pièces : un sous-composant par pièce, ou `mass_properties` (corps par exemplaire).
- Frame Member renommé : `check_parameters {nb_volee1: 16}` → 0 erreur, 146 corps, `Limon ext/int V1/V2` et leurs platines gardent leur nom et leur place (bout V1 à X = 4095, rive 4110) ; avertissements connus de `Trous limon ext/int V1` ; modèle remis (`restored: true`).
- Interférences du projet (`projet_escalier`, 159 corps, 23 s) : seule la collision connue `Poteau milieu arrivée` / `Limon int V1` (3,4 mm, 9 721 mm³, §7). Le projet nomme désormais les corps des exemplaires (`Platine tête (Ensemble pied:3)`).
- Sous-composants imbriqués (modèle jetable, non enregistré, 2026-11-01) : un ensemble à 2 pièces, chacune son sous-composant (`component.create {parent}`), posé 2 fois. Paramètre changé et pièce ajoutée dans l'ensemble : suivis dans les 2 exemplaires. Nomenclature (`group_children`) : un ensemble **« inseparable » ne montre dessous que ses pièces « purchased »** ; en « normal », toutes ses pièces (`each` 1, `count` 2). Dans un ensemble posé plusieurs fois, `move_features` vers un sous-composant est refusé ; `move_bodies` (avec `component_path`) passe, mais la fonction reste dans l'ensemble (`BodyTransfer`, écarté en D20) → construire les pièces dans leur sous-composant. `mass_properties` ne détaille les pièces imbriquées qu'au premier exemplaire (avertissement).
Pistes **non testées** : Insert Part dans plusieurs trous (visserie). Aucune correction annoncée pour nos pièges (union face contre face, reprises du booléen sur l'UPE #9724, cote nulle D5, noms des réseaux à plusieurs corps). Le `.bak` est un lien dur : il garde bien l'ancienne version (constaté).

*SolidCraft 0.24.1 → 0.27.1* (2026-10-30, constaté dans l'app ; notes de version intermédiaires **non relues**) : les 3 modèles s'ouvrent sans erreur ; escalier 82 corps, encombrement identique, volume identique à l'export de la 0.24.1 (écart 0,015 %, maillage STL) ; environnement 13 corps conformes ; projet 95 corps, liens à jour, seule la collision connue (§7). Changé : piège des noms des corps de réseaux (§6.3). Inchangé : matériaux perdus par les liens (règles §8). Les pistes ci-dessous (0.24.1) restent à tester.

*SolidCraft 0.22.1 → 0.24.1* (2026-10-27, d'après les notes de version, **rien testé dans l'app**) :
- D5 : une cote de longueur zéro garde l'esquisse contrainte (0.23.0) ; `debord = 0` pourrait être accepté directement. À tester.
- Oblongs (§4) : corrections des rainures en esquisse (0.24.0), mais rien n'indique qu'elles acceptent des expressions. Garder les rainures actuelles tant que ce n'est pas testé.
- `Perçage poutre avant` : les répétitions d'esquisse prennent nombre et espacement dans les paramètres (0.23.1) ; les 8 cercles pourraient devenir une répétition.
- D10 : symétries et répétitions désignent leurs sources par identifiant (0.24.1), plus robustes aux renommages. Rien à changer.
- Garde-corps : onglet Mécano-soudure (structures, 0.24.0) et Pipe avec opération joindre / découper (0.23.1). Vérifier si la bibliothèque de profilés a des tubes et des UPE.
- Plans et nomenclature : rien de nouveau.

### 6.5 Gestion des versions

Dépôt GitHub `mj42584/staircase_solidcraft_claude` (méthode : règles §3 et §4).

## 7. Points ouverts

- **Calculs à relancer** : `jeu_limons` (100 → 200, 2026-11-07). Avant : Relancés le 2026-11-03 : `portique.py` avec `limon_dessus` dans l'axe des limons (`dz` + `limon_descente`, écart ≤ 2 % : limons V1 en flexion 32 → 31 %, torsion seuls 331 → 327 %, diagonales 24 → 23 %), `visu.py` (PyVista, moments.png et deformee.png sortis, non versionnés). **Rapport `calc/rapport_calcul.pdf` non repris** pour ces écarts (≤ 2 %) ; il reste à jour sur le reste (D35).
- **Garde-corps (D31, D32, D34)** : avec 5 potelets sur V1, 4 au fond, tube 40 × 40 × 3 et cornières 50 × 50 × 5, `predim.py` donne potelets V1 73 %, fond 55 %, vis M8 84 % ; torsion des limons V1 37 % avec les marches comme traverses (`k` = 7e7 avec 3 vis à bois Ø5 par cornière, plafond sans la souplesse de l'aile ni du limon : limons V1 11 %, vis la plus tendue 66 % de l'arrachement (ρk 530, D40) ; positions des vis supposées, `K_VIS` dans `predim.py`) ; V2 ext 56 % / int 67 %, vis M8 de V2 ≤ 76 % , `q_gc` validé (2026-11-03). Ancien constat : sous `q_gc` (0,6 kN/m, validé par l'utilisateur le 2026-11-03), potelets 30 × 2 à 255 % / 213 %, vis M8 des platines basses à 111 %, torsion des limons V1 seuls à 331 % (à recalculer avec les marches comme traverses). Pistes : potelets plus forts (50 × 50 × 4 ≈ 112 MPa, ordre de grandeur) ou plus rapprochés, vis de part et d'autre du potelet en travers ou fixation sur le côté du limon. Choix de l'utilisateur à faire , `q_gc` validé (2026-11-03). **En attente** (2026-11-03, choix de l'utilisateur : rien pour le moment).
- **Mains courantes** : `nb_potelets_*` ≥ 2 (pas des répétitions divisé par `nb - 1`) ; `nb_potelets_*` ne pilote plus que les perçages : les potelets sont posés à la main (16 + 8 exemplaires, D20, D26, D32, D34) ; remplissage du garde-corps à faire (plus tard, choix de l'utilisateur).
- **Montage : accès à toutes les vis et écrous** (demande de l'utilisateur, 2026-11-02, à faire plus tard) : vérifier pour chaque assemblage boulonné ou vissé qu'on peut engager la vis et serrer (clé, douille, ordre de montage). Déjà repérés :
  - écrous M8 des potelets sous l'aile haute des limons, dans le U (≈ 36 mm de l'âme, 196 mm entre ailes) ; le plus serré est `Ensemble potelet volée:8` (int V1, près du palier), en face du bas du U de int V2 à `jeu_limons` (100 mm), depuis D25 ;
  - écrous des platines d'about des limons intérieurs côté palier : le U s'ouvre côté jour, avec seulement `jeu_limons` entre les deux limons. Pistes : augmenter `jeu_limons` (≈ 150) ou remplacer les platines par des cornières d'attache (D17) ;
  - limon ext V2 : U ouvert vers le mur, ≈ 277 mm (calculé depuis le décalage du projet, non mesuré).
- **En suspens : projet d'assemblage et environnement** (choix de l'utilisateur, 2026-11-02 : priorité à l'escalier seul) :
  - **Collision dans le projet** (`inspect.interference`, 15/7 comme 16/6) : `Poteau milieu arrivée` / `Limon int V1` (3,4 mm). Celle de `Poutre mur` avec le haut de V2 (limon, platine, équerre) a disparu avec le jeu en Y (il faut au moins ≈ 100 mm).
  - **Jeu V2 / face du cadre** (≈ 227 mm, choisi par l'utilisateur) : à revoir.
  - **Placement de l'escalier dans le projet** : tester les liaisons (joints) pour qu'il suive la répartition (piège du décalage chiffré, règles §8).
  - **Environnement à confirmer** : `cadre_longueur` 3788 vient du croquis, alors que la plateforme mesurée fait ≈ 5,51 m et que 3788 est aussi la hauteur du cadre ; sens de prolongement de `poutre_mur_longueur`.
- **Vérifications locales (D38)** : platine basse des potelets passée à 10 mm (D39, 84 %) ; reste la poutre arrière du palier à 98 % en torsion (borne haute : à affiner avec le gauchissement et le plancher, ou à renforcer). Hypothèses à confirmer : cordons (5 mm goussets, 3 mm potelets et languettes), repère vibratoire 5 Hz.
- **Poutre avant** : elle reçoit les 4 limons, dont les deux intérieurs près du milieu de sa portée (taux en D14 et D15) ; le gauchissement n'est pas calculé.
- **Contreventement du palier en travers (Y)** : 2 diagonales en tube, faces avant et arrière, calculées et modélisées (D30). `portique.py` recalé sur les trous des goussets (D30). Restent : confirmer l'épaisseur du tube (40 × 40 × 3, D36), vérifier le boulon M12 et les soudures des goussets et des languettes, l'excentricité de 10 mm de la languette. Chevilles : ≤ 2,5 kN de traction et 1,6 kN de cisaillement par cheville au pied des poteaux (D31) ; **référence des chevilles (ETA), épaisseur de la dalle et distances au bord à fournir** : vérifiées avec des hypothèses (D37, 16 % au plus).
- **Pieds de limons V1** : modélisés (D28) avec 2 chevilles M12 alignées dans l'axe du limon, au milieu du U : une liaison plutôt articulée (le moment d'encastrement de D15 serait lourd pour ces chevilles). `portique.py` les prend articulés (D29) ; chevilles et béton à vérifier ; références (`part_number`) des 4 platines à poser.

## 8. Prochaines étapes

Liste fixée par l'utilisateur (2026-10-26) :

1. **Fixation de l'arrivée** : platines du haut de V2 boulonnées à la structure supérieure.
2. **Garde-corps** : mains courantes des volées et du palier faites (D18) ; reste le remplissage.
3. **Plans** (mise en plan) : les 9 tôles en découpe laser sont faites (`plans/`) ; restent les profilés et les ensembles soudés.
4. **Nomenclature.**
5. **Vérification par le calcul** (poutre avant en priorité, stabilité / contreventement) : prédimensionnement et modèle en barres faits (D14, D15) ; restent les assemblages et chevilles, le garde-corps dans le modèle et la validation par un bureau d'études.

**En attente** (pas pour l'instant, choix de l'utilisateur) : visserie (platines, poutre avant, arrivée), cornière d'appui, assemblage platines / poutre avant et platines / arrivée.

## 9. Historique

| Date | Demande | Réalisé | Fichiers |
|---|---|---|---|
| 2026-10-25 | Dessiner le FreeCAD dans SolidCraft | Export STEP via FreeCADCmd puis import (13 corps) | `archive/escalier-gab-import.solidcraft` |
| 2026-10-25 | Retracer l'ensemble marche proprement | Marche + 2 équerres paramétriques, autonome | `archive/ensemble-marche.solidcraft` |
| 2026-10-25 | Esquisse squelette pilotée | Paramètres, squelettes élévation et plan, 0 DDL | `cad/escalier.solidcraft` |
| 2026-10-25 | Placer l'ensemble marche automatiquement | Plans d'axe, lignes de foulée, marches de référence, réseaux sur chemin (15 + 5) | `cad/escalier.solidcraft` |
| 2026-10-25 | Mise en place du dépôt GitHub | Arborescence, README, CONCEPTION, AGENTS | dépôt |
| 2026-10-25 | Limons | 4 limons UPE 220 paramétriques, jour calculé, test `jeu_limons` 20 → 40 → 20 OK | `cad/escalier.solidcraft` |
| 2026-10-25 | Palier | Plancher 30 mm, cadre 4 UPE, 4 pieds tube 100×100×5 ; test `palier_profondeur` 1000 → 1200 → 1000 OK ; liaison limon V2 en attente (non enregistré) | `cad/escalier.solidcraft` (dans l'app) |
| 2026-10-25 | Cadre en onglet | Poutres latérales retournées (âme dehors), 4 UPE coupés à 45° aux angles ; volumes vérifiés, test profondeur OK | `cad/escalier.solidcraft` |
| 2026-10-25 | Pied du limon V2 | Coupe verticale à la rive (esquisses `Profil limon V2` et `Profil ailes limon V2` redessinées) ; répartition constatée à 14/8 | `cad/escalier.solidcraft` |
| 2026-10-25 | Platines d'about | Platine de 15 mm soudée en bout des 4 limons, puis **retirée de la volée 2** à la demande de l'utilisateur (limons V2 revenus à la coupe à la rive) ; volumes vérifiés, test `platine_ep` 25 → 15 OK ; répartition revenue à 16/6 | `cad/escalier.solidcraft` (dans l'app) |
| 2026-10-25 | Platines V1 séparées | Platine V1 passée d'une jonction au limon à un corps à part (`Platine ext V1` / `Platine int V1`), incluse dans la symétrie ; volumes vérifiés (limon + platine = ancien corps) | `cad/escalier.solidcraft` |
| 2026-10-26 | Platines en haut de V2 | Même platine que V1, en haut des limons V2 (arrivée), corps séparés, incluses dans la symétrie ; volumes vérifiés, test `platine_ep` 25 → 15 OK (non enregistré) | `cad/escalier.solidcraft` (dans l'app) |
| 2026-10-26 | Supprimer la coupe verticale du limon V2 au-dessus du palier | `Profil limon V2` et `Profil ailes limon V2` : arête haute prolongée jusqu'au plancher, assise horizontale sur un giron ; volumes OK, test `nb_volee1` 15 → 16 → 15 OK (non enregistré) | `cad/escalier.solidcraft` (dans l'app) |
| 2026-10-26 | Palier au niveau de la 1re marche V2, une contremarche de plus en V1 | Version précédente (limon prolongé sur le plancher) annulée. Squelette : ligne de giron au niveau du palier, contremarche V2 à `rive − giron` ; marche V2 accrochée au nez du palier, réseau `nb_volee2` ; équerre, emprise en plan, limons et platines V2 redessinés en expressions ; `nb_volee1` 15 → 16 ; contrôles des positions OK, test 16 → 15 → 16 OK, aucune erreur (non enregistré) | `cad/escalier.solidcraft` (dans l'app) |
| 2026-10-26 | Platine de 15 mm palier / V2 comme V1 | Limons V2 raccourcis de `platine_ep` côté palier, platine en corps séparé (`Platine palier ext/int V2`) incluse dans la symétrie ; volume identique aux platines V1 ; tests `jeu_limons` 100 → 140 → 100, `platine_ep` 15 → 25 → 15, `nb_volee1` 16 → 15 → 16 OK (non enregistré) | `cad/escalier.solidcraft` (dans l'app) |
| 2026-10-26 | Perçage identique des 6 platines | Paramètres `boulon_d`, `trou_jeu`, `oblong_course`, `boulons_entraxe` ; 2 oblongs verticaux M12 (14 × 24) centrés par platine, découpés avant les symétries ; 6 volumes identiques ; tests `boulons_entraxe` 140, `boulon_d` 16, `nb_volee1` 15, `jeu_limons` 140 puis retour OK (non enregistré) | `cad/escalier.solidcraft` (dans l'app) |
| 2026-10-26 | Perçage du palier | 8 trous ronds Ø14 dans l'âme de la poutre avant, en face du milieu des oblongs des platines V1 et V2 côté palier ; volume retiré conforme (8 × Ø14 × 6,5) ; tests entraxe 140, M16, 15/7, jeu 140 puis retour OK (non enregistré) | `cad/escalier.solidcraft` (dans l'app) |
| 2026-10-26 | Matériaux | Répartition constatée à 17/5 ; chêne sur 22 corps (marches, plancher), acier sur 60 corps ; aucun « Default » restant ; masse ≈ 893 kg ; test `nb_volee1` 17 → 16 → 17 OK (non enregistré) | `cad/escalier.solidcraft` (dans l'app) |
| 2026-10-26 | Liste des prochaines étapes | §8 réécrit d'après l'utilisateur (arrivée boulonnée à la structure supérieure, garde-corps, plans, nomenclature, calcul) ; point ouvert obsolète sur les platines V1 retiré | `CONCEPTION.md` |
| 2026-10-26 | Vérifier les cotes UPE 220 | h 220, b 85, tw 6,5, tf 12 conformes aux catalogues (Stad, ArcelorMittal, beamdimensions) ; seul écart : congés r 13 non modélisés (−2,2 % de masse) ; point ouvert retiré | `CONCEPTION.md` |
| 2026-10-27 | Prédimensionnement | Script `calc/predim.py` (marches, limons, poutre avant, pieds, boulons) ; marches de 30 mm insuffisantes (38 mm mini), le reste ≤ 12 % ; D14, points ouverts, §8 et README mis à jour | `calc/predim.py`, `CONCEPTION.md`, `README.md` |
| 2026-10-27 | Modèle en barres PyNite | `calc/portique.py` : pieds et limons V1 encastrés, arrivée V2 articulée, défauts de verticalité, sans garde-corps ; tout ≤ 11 %, palier stable grâce à l'arrivée V2 (5,7 kN horizontaux par limon), 6,2 kN·m en pied de limon V1 ; `afficher()` sorti dans `predim.py` ; D15, points ouverts, §8 et README mis à jour | `calc/portique.py`, `calc/predim.py`, `CONCEPTION.md`, `README.md` |
| 2026-10-27 | Visualisation PyVista | `calc/visu.py` : fenêtre interactive ou PNG (moments ELU_X, déformée ELS_X × 300) ; moment maxi au pied des limons V1 (6,2 kN·m) ; D16 et README mis à jour | `calc/visu.py`, `CONCEPTION.md`, `README.md` |
| 2026-10-27 | Rapport de calcul | Rapport de synthèse (description, hypothèses, méthode, vérifications, efforts aux appuis, figures, limites) dans un doc Claude (https://claude.ai/artifact/S7D154tdD82mPPB65nKBjT), copie Markdown + figures dans `calc/rapport/` | `calc/rapport/`, `CONCEPTION.md`, `README.md` |
| 2026-10-27 | Dépôt déplacé, SolidCraft à jour | Clone de `staircase_solidcraft_claude` à la place de l'ancien dossier ; SolidCraft 0.22.1 → 0.24.1 (Flatpak GitHub) ; règle d'état des lieux à chaque mise à jour (§6) et premier état des lieux (§7) | `CONCEPTION.md` |
| 2026-10-27 | Environnement du site | Photos et croquis : arrivée sur un cadre IPE 200, hauteur mesurée 3848 ; fichier séparé `cad/environnement.solidcraft` (cadre, 6 poteaux, 2 solives, poutre le long du mur, planche, dalle, mur) en Frame Member ; insertion à décalage chiffré seulement (vérifié) ; escalier pas touché | `cad/environnement.solidcraft`, `CONCEPTION.md` |
| 2026-10-27 | Coter les esquisses de l'environnement | Modifications de l'utilisateur relevées (largeur 2670, poteaux milieu 1400, mur 3800, poteaux avant supprimés) ; 6 esquisses redessinées avec de vraies cotes en paramètres, 0 DDL ; positions inchangées ; test `cadre_largeur` 2900, `cadre_longueur` 4000, `poteau_milieu` 1200 puis retour OK | `cad/environnement.solidcraft`, `CONCEPTION.md` |
| 2026-10-27 | Retouches de l'utilisateur relevées | Dalle et mur raccourcis : 100 mm au-delà du cadre (X −3888) et de la poutre le long du mur (X 5610), au lieu de 3000 ; dalle prolongée sous le mur (bord à `mur_ecart + mur_ep`) ; rien d'autre de changé, aucune erreur ; enregistré | `cad/environnement.solidcraft`, `CONCEPTION.md` |
| 2026-10-27 | Hauteur mesurée dans l'escalier | `hauteur_totale` 3800 → 3848 (h = 174,91, Blondel 624) ; répartition 17/5 et `marche_epaisseur` 60 constatés ; palier à 2973,45, haut des platines V2 à 3838,4 (conforme au calcul) ; 82 corps, aucune erreur (avertissement booléen de `Trous poutre avant` déjà présent) ; calculs `calc/` **pas relancés** (leurs paramètres sont à 3800 / 30) | `cad/escalier.solidcraft`, `CONCEPTION.md` |
| 2026-10-27 | Projet escalier | Assemblage `cad/projet_escalier.solidcraft` : environnement fixé à l'origine, escalier lié décalé de [−3014, −1220, 0] (17/5, jeu V2 / cadre 0 provisoire) ; liens relatifs ; 6 collisions (poutre le long du mur / haut de V2, poteau du milieu / V1) ; hauteur libre 1,49 m au-dessus de V1 | `cad/projet_escalier.solidcraft`, `CONCEPTION.md` |
| 2026-10-27 | Escalier plaqué dans le projet | L'utilisateur avait déplacé l'escalier (+181 X, −227 Y, +320 Z) ; recalé en X (platine V2 contre la poutre d'arrivée, X = 0) et Z (pieds sur la dalle), Y gardé ; décalage [−3014, −1446,6, 0] ; reste 1 collision : `Poteau milieu arrivée` / `Limon int V1` (3,4 mm) | `cad/projet_escalier.solidcraft`, `CONCEPTION.md` |
| 2026-10-27 | Fixer l'escalier dans le projet | Occurrence `Escalier` fixée (grounded), position inchangée (platine V2 à X = 0) | `cad/projet_escalier.solidcraft`, `CONCEPTION.md` |
| 2026-10-27 | Recaler après modification de l'escalier | L'utilisateur est passé en **16/6** (palier à 16 h = 2798,5) et a mis à jour le lien : arrivée à X = −548 dans le cadre ; escalier libéré, décalé de +548 en X (deux girons), refixé ; décalage [−2466, −1446,6, 0], pieds à Z = 0 ; reste 1 collision `Poteau milieu arrivée` / `Limon int V1` (3,4 mm) ; hauteur libre au-dessus de V1 sous la poutre d'arrivée : 3588 − 10 h = **1,84 m** ; `cad/escalier.solidcraft` mis à jour depuis `recovery` | `cad/escalier.solidcraft`, `cad/projet_escalier.solidcraft`, `CONCEPTION.md` |
| 2026-10-27 | Export STL du projet et README | `cad/projet_escalier.stl` (binaire, 379 Ko, environnement + escalier) ; nouvel aperçu `cad/apercu.png` (vue côté V1) ; README : lien 3D vers le projet, valeurs 3848 / 16 + 6 / marches 60 mm, mention du calcul non relancé, nouveaux fichiers ; `cad/escalier.stl` réexporté depuis le projet (escalier seul, 16/6, 82 corps, coordonnées du site) | `cad/projet_escalier.stl`, `cad/apercu.png`, `README.md`, `CONCEPTION.md` |
| 2026-10-28 | Audit de CONCEPTION.md, §6 réécrit | FreeCAD retiré (plus utilisé) ; §6 en 5 sous-parties (autorisations, déroulé, tenue du fichier, outils et versions, pièges) ; valeurs périmées corrigées (16/6, 60 mm, palier 2798,5) ; contradictions levées ; §7 : calculs à relancer, effets probables de `palier_ep` 60 à vérifier, hauteur libre 1,84 m | `CONCEPTION.md` |
| 2026-10-28 | Règle des branches | 6.2 : une branche par tâche avant toute modification, fusion dans `main` par l'utilisateur, une seule branche à la fois sur un `.solidcraft` | `CONCEPTION.md` |
| 2026-10-28 | Règles génériques à part | Règles de travail sorties dans `REGLES_AGENT_3D.md` (réutilisable sur d'autres projets 3D) ; §6 réduit aux outils, fichiers et pièges du projet ; pièges dédoublonnés (§4, D13, §7 renvoient au §6.3) ; AGENTS.md et README mis à jour | `REGLES_AGENT_3D.md`, `CONCEPTION.md`, `AGENTS.md`, `README.md` |
| 2026-10-28 | Chasse aux doublons | §2 réduit à l'origine des données ; environnement et projet déplacés à la fin du §4, état des lieux des outils en §6.4 ; §7 ne garde que des points ouverts (renvois à D14 / D15 au lieu des chiffres) ; « en attente » regroupé au §8 ; petits doublons (D9, D11, `poteau_*`, verrou) retirés | `CONCEPTION.md`, `REGLES_AGENT_3D.md` |
| 2026-10-28 | README allégé | Chapitres escalier, calcul, modification et contenu retirés (doublons de CONCEPTION.md) ; ajout de « Comment le projet est fait » (SolidCraft, Claude Code, connecteur MCP, travail à deux) | `README.md`, `CONCEPTION.md` |
| 2026-10-28 | Règle de modélisation | `REGLES_AGENT_3D.md` §6 : toujours préférer une méthode modifiable par un humain (cotes dans les esquisses, paramètres nommés, noms explicites) | `REGLES_AGENT_3D.md`, `CONCEPTION.md` |
| 2026-10-28 | Règle de nommage | `REGLES_AGENT_3D.md` §6 : renommer tout élément créé avec un nom explicite, jamais le nom par défaut | `REGLES_AGENT_3D.md`, `CONCEPTION.md` |
| 2026-10-28 | Règles de modélisation | `REGLES_AGENT_3D.md` §6 : squelette, esquisses à 0 DDL, un corps par pièce, réseaux, symétries, matériau à la création, simplifications déclarées | `REGLES_AGENT_3D.md`, `CONCEPTION.md` |
| 2026-10-28 | Exports à jour | `REGLES_AGENT_3D.md` §2 étape 6 : régénérer les exports avant de proposer la fusion ; « fusion (merge) » ; contrôle GitHub Actions `.github/workflows/exports.yml` qui met en échec une PR modifiant un `.solidcraft` sans ses exports ; D7 renvoie au contrôle | `REGLES_AGENT_3D.md`, `CONCEPTION.md`, `.github/workflows/exports.yml` |
| 2026-10-28 | Exports : géométrie seulement | Étape 6 limitée aux changements de géométrie 3D ; étiquette `geometrie-inchangee` sur la PR pour passer le contrôle | `REGLES_AGENT_3D.md`, `.github/workflows/exports.yml`, `CONCEPTION.md` |
| 2026-10-28 | Contrôle GitHub abandonné | `.github/workflows/exports.yml` supprimé (choix de l'utilisateur) ; la règle des exports reste ; D7 liste les exports et ce qui les touche | `REGLES_AGENT_3D.md`, `CONCEPTION.md` |
| 2026-10-28 | Arborescence du dépôt | `REGLES_AGENT_3D.md` §7 : arborescence type et création de celle d'un nouveau projet (ce qui manque seulement, squelette de CONCEPTION.md) | `REGLES_AGENT_3D.md`, `CONCEPTION.md` |
| 2026-10-28 | Arborescence : création retirée | Partie « Créer l'arborescence d'un nouveau projet » supprimée de `REGLES_AGENT_3D.md` §7 (choix de l'utilisateur) | `REGLES_AGENT_3D.md`, `CONCEPTION.md` |
| 2026-10-28 | Plan du fichier de conception | `REGLES_AGENT_3D.md` §3 : tableau des 9 chapitres de CONCEPTION.md et de leur contenu | `REGLES_AGENT_3D.md`, `CONCEPTION.md` |
| 2026-10-28 | Corrections de l'audit des règles | `REGLES_AGENT_3D.md` : §1 renommé « Principes », ajout « aucune donnée inventée » et « statut des calculs » ; §2 : rien n'est écrit avant la branche, ordre réaliser → exports → documenter → enregistrer, demande de fusion définie | `REGLES_AGENT_3D.md`, `CONCEPTION.md` |
| 2026-10-28 | Règles indépendantes de Git | `REGLES_AGENT_3D.md` : quatre notions (version de travail, enregistrer, version de référence, valider) avec leur équivalent Git / PLM / gestionnaire de fichiers ; vocabulaire Git retiré des règles ; « Arborescence du projet » ; CONCEPTION §6.5 : gestion des versions du projet (Git) | `REGLES_AGENT_3D.md`, `CONCEPTION.md` |
| 2026-10-28 | « Versions des logiciels » | Renommage pour ne plus confondre avec la version de référence du projet : `REGLES_AGENT_3D.md` §1, §2, §3, §4 (« Logiciels et leurs versions »), CONCEPTION §6.1 | `REGLES_AGENT_3D.md`, `CONCEPTION.md` |
| 2026-10-28 | Relecture des règles | `REGLES_AGENT_3D.md` : « logiciels » partout au lieu de « outils » pour les versions, « enregistrement du modèle », « enregistrer une version » à l'étape 6, README « si ce qu'il décrit change », noms des chapitres de conception communs aux projets ; CONCEPTION §6.1 et §6.4 alignés | `REGLES_AGENT_3D.md`, `CONCEPTION.md` |
| 2026-10-29 | Impacts de la mise à jour documentaire sur le 3D | Écarts constatés (16/6, 82 corps, 0 erreur, 0 interférence, SolidCraft 0.24.1) : avec le palier à 60 mm, trous hauts V2 de la poutre avant dans le pied de l'aile haute (≈ 8 mm, avertissement booléen), platines côté palier plus courtes que la poutre (V1 9,5 mm, V2 28,6 mm). Corrigé (choix de l'utilisateur) : `boulons_entraxe` 100 → 80 ; trous côté palier (platines V1, V2 et poutre avant) centrés sur le milieu de la poutre ; `Profil platine V1` et `Profil platine palier V2` redessinés (mêmes ids), bas au bas de la poutre ; trous d'arrivée restés centrés sur leur platine ; avertissement disparu, 0 erreur, 0 interférence dans l'escalier ; tests `nb_volee1` 16 → 15 → 16 et `marche_epaisseur` 60 → 40 → 60 OK ; projet : liens mis à jour, seule collision `Poteau milieu arrivée` / `Limon int V1` (déjà connue) ; STL régénérés, `cad/apercu.png` gardé (changement invisible à cette échelle) | `cad/escalier.solidcraft`, `cad/projet_escalier.solidcraft`, `cad/escalier.stl`, `cad/projet_escalier.stl`, `CONCEPTION.md` |
| 2026-10-29 | Recentrer les limons sur la poutre avant (montage des boulons difficile) | `limon_dessus` 0 → `-30 mm * giron / pas_volee` (D17) ; platines côté palier revenues à la section du limon (6 platines identiques), trous côté palier toujours centrés sur la poutre ; `boulons_entraxe` 80 → 100 ; V1 centré (2498 → 2759), V2 à +19 mm ; platine V2 côté palier 20 mm sous le plancher ; 0 erreur, 0 avertissement, 0 interférence ; tests `nb_volee1` 16 → 15 → 16, `marche_epaisseur` 60 → 40 → 60 OK ; projet : liens mis à jour, seule collision `Poteau milieu arrivée` / `Limon int V1` (déjà connue) ; STL régénérés, `cad/apercu.png` gardé | `cad/escalier.solidcraft`, `cad/projet_escalier.solidcraft`, `cad/escalier.stl`, `cad/projet_escalier.stl`, `CONCEPTION.md` |
| 2026-10-29 | Refonte des esquisses (règles de `REGLES_AGENT_3D.md` §6) — constat | 16 esquisses en points définis par expression, sans cote (108 points) : limons (4), platines (4), plancher, pieds, cadre (8) ; elles ne s'appuient pas sur le squelette ; 77 paramètres sur 108 au nom par défaut (`dN`) ; 0 DDL partout, noms d'esquisses / fonctions / corps explicites | `CONCEPTION.md` |
| 2026-10-29 | Refonte des esquisses — réalisé | Paramètres ajoutés `rive_x`, `cadre_y`, `limon_hv` ; 16 esquisses redessinées en lignes cotées (mêmes identifiants de courbes) : plancher, pieds (4 tubes), cadre (8 trapèzes, onglets cotés 45°), 4 platines (rectangles), 4 limons (ligne des nez du squelette projetée en construction, bords parallèles cotés) ; 194 cotes renommées `<pièce>_<rôle>` (les 50 paramètres de fonctions `dN` ont été oubliés, corrigé le 2026-10-29 sur la branche `limons-frame-member`) ; 82 corps identiques à la référence (volumes et encombrements), 0 erreur ; balayages sans échec de `nb_volee1` 14–18, `giron`, `hauteur_totale`, `marche_epaisseur`, `limon_h`, `limon_dessus` (−50 / 0 / 20), `emmarchement`, `platine_ep`, `boulons_entraxe`, `limon_tf`, `palier_profondeur`, `jeu_limons`, `poteau_cote`, `limon_b` ; contrôle à `giron` 300 / `limon_dessus` 20 : platines et limons jointifs, 0 interférence ; projet : lien mis à jour, seule collision connue ; géométrie inchangée → exports non régénérés | `cad/escalier.solidcraft`, `cad/projet_escalier.solidcraft`, `CONCEPTION.md` |
| 2026-10-29 | Prototype : limon V1 en Frame Member | Paramètre `limon_r` ; `Axe limon V1`, `Barre limon V1` (profilé channel), `Coupes limon V1`, `Coupe limon V1` insérés avant la platine V1 ; anciennes esquisses `Profil limon V1` / `Profil ailes limon V1` supprimées ; corps renommé `Limon ext V1`, `Symétrie limon V1` mise à jour, acier ; encombrement identique, volume +2,2 % (congés) ; 0 erreur, 0 interférence ; balayages `nb_volee1`, `giron`, `limon_dessus`, `limon_h`, `limon_r`, `hauteur_totale` sans échec ; 59 paramètres `dN` restants renommés (50 de fonctions oubliés par la refonte, 9 nouveaux) ; fichier rouvert identique ; projet et exports pas encore mis à jour (prototype) | `cad/escalier.solidcraft`, `CONCEPTION.md` |
| 2026-10-29 | Limons V2 et pieds en Frame Member | Limons V2 comme V1 (`Axe limon V2`, `Barre limon V2`, `Coupes limon V2`, `Coupe limon V2`), anciennes esquisses supprimées, symétrie mise à jour, acier ; pieds : `Plan pieds V1/V2`, `Axes pieds V1/V2`, `Pieds V1/V2` (tubes 100×100×5, rayon `poteau_r` supposé), ancienne esquisse supprimée ; paramètres `poteau_r`, `pied_h` ; 35 nouveaux `dN` renommés ; encombrements identiques, volumes : limons +2,2 % (congés), pieds −3,5 % (angles arrondis), acier +2,6 kg ; 0 erreur, 0 interférence ; 9 balayages sans échec ; projet : lien mis à jour, seule collision connue ; STL régénérés, `cad/apercu.png` gardé (changement invisible à cette échelle) | `cad/escalier.solidcraft`, `cad/projet_escalier.solidcraft`, `cad/escalier.stl`, `cad/projet_escalier.stl`, `CONCEPTION.md` |
| 2026-10-29 | Double enregistrement .solidcraft + .json | Les 3 modèles enregistrés aussi en `.json` (`cad/escalier.json`, `cad/environnement.json`, `cad/projet_escalier.json`) ; règle notée au §6.2 et dans `REGLES_AGENT_3D.md` (étape 6) ; pièges du relien et des matériaux dans le projet ; géométrie inchangée | `cad/*.json`, `CONCEPTION.md`, `REGLES_AGENT_3D.md` |
| 2026-10-30 | Mise à jour SolidCraft 0.24.1 → 0.27.1 | Nouvel identifiant Flatpak et port du connecteur ; 3 modèles contrôlés (corps, erreurs, volumes, interférences : rien de changé) ; corps des réseaux renommés selon leur position et matériaux réaffectés (22 chêne, 60 acier ; 5 corps étaient faux), valable en 16/6 seulement (piège §6.3) ; test `nb_volee1` 16 → 15 → 16 ; 3 modèles réenregistrés en format 44 (.solidcraft + .json) ; géométrie inchangée → exports non régénérés | `cad/*.solidcraft`, `cad/*.json`, `CONCEPTION.md` |
| 2026-10-30 | Mains courantes | Branche `mains-courantes` depuis `main` (16/6, 82 corps, 0 erreur) ; paramètres `mc_h`, `mc_d`, `potelet_l`, `potelet_ep`, `nb_potelets_v1`, `nb_potelets_v2` ; 4 mains courantes en chêne Ø45 et 12 potelets en fer plat (Frame Member), symétries de corps puis un réseau par corps ; esquisses cotées à 0 DDL, 16 cotes et 16 paramètres de fonctions renommés ; 98 corps (26 chêne, 72 acier), +49 kg, 0 erreur, 0 interférence ; balayages sans échec de `nb_volee1` 14–18, `mc_h`, `giron`, `limon_dessus`, `nb_potelets_v1/v2`, `hauteur_totale`, `emmarchement` ; tests réels `nb_volee1` 16 → 15 → 16 et `mc_h` 900 → 1000 → 900 OK (noms des potelets justes) ; projet : lien mis à jour, seule la collision connue ; STL et `cad/apercu.png` régénérés | `cad/escalier.*`, `cad/projet_escalier.*`, `cad/*.stl`, `cad/apercu.png`, `CONCEPTION.md` |
| 2026-10-30 | Main courante du palier | Paramètres `mc_palier_h` (1000), `nb_potelets_fond` (3) ; main courante continue V1 → palier → V2 (prolongements dans l'alignement des volées puis horizontales, Pipe pour les coudes), fond bout à bout, 5 potelets (1 par côté, 3 au fond) posés sur le plancher ; mains courantes V2 raccourcies au premier nez de V2, premier potelet V2 déplacé ; 106 corps (29 chêne, 77 acier), 0 erreur, 0 interférence ; balayages sans échec (`nb_volee1` 14–18, `palier_profondeur`, `mc_h`, `mc_palier_h`, `nb_potelets_fond`, `giron`, `hauteur_totale`, `emmarchement`, `jeu_limons`) ; projet : seule la collision connue, main courante du palier à 178 mm de la poutre le long du mur ; STL et aperçu régénérés | `cad/escalier.*`, `cad/projet_escalier.*`, `cad/*.stl`, `cad/apercu.png`, `CONCEPTION.md` |
| 2026-10-30 | Mains courantes au milieu des limons | Plans des mains courantes décalés au milieu des limons (`limon_b / 2` de la rive) et de la poutre arrière ; potelets déplacés avec (posés sur l'aile haute, plus contre l'âme) ; 106 corps, 0 erreur, 0 interférence, appuis au contact ; balayages sans échec (`nb_volee1`, `limon_b`, `palier_profondeur`, `emmarchement`, `limon_dessus`) ; projet : seule la collision connue, main courante int V1 à 17 mm du poteau du milieu ; STL et aperçu régénérés | `cad/escalier.*`, `cad/projet_escalier.*`, `cad/*.stl`, `cad/apercu.png`, `CONCEPTION.md` |
| 2026-10-30 | Platines des potelets | Paramètres `platine_bas_*` (100 × 50 × 8, trous Ø9 M8), `platine_haut_*` (80 × 30 × 5, trous Ø5 vis à bois), entraxes 70 / 60 supposés ; potelets soudés (un corps), coupés en biais sur les volées, platines parallèles à la pente ; trous dans les platines, l'aile haute des limons (8 en V1, 4 en V2), le plancher et l'aile du cadre au palier ; potelets d'angle du fond rentrés de 7,5 mm (platine dans le cadre) ; plantage de l'app pendant les renommages, sauvegarde automatique récupérée, piège noté (§6.3) ; 106 corps, 0 erreur, 0 interférence ; balayages sans échec (`nb_volee1`, `giron`, `nb_potelets_*`, `platine_bas_l`, `limon_dessus`, `mc_h`, trous des limons suspendus) ; profondeur des trous des limons mesurée (12 mm) ; projet : seule la collision connue ; STL et aperçu régénérés | `cad/escalier.*`, `cad/projet_escalier.*`, `cad/*.stl`, `cad/apercu.png`, `CONCEPTION.md` |
| 2026-10-30 | Trous des platines trop près du potelet (remarque de l'utilisateur) | Platine basse 100 → 130 mm, entraxe 70 → 100 ; platine haute 80 → 100 mm, entraxe 60 → 80 (place pour la tête de vis et l'outil) ; volume +15 000 mm³ par potelet comme prévu, 0 erreur, 0 interférence ; potelets d'angle du fond recalés par le paramètre ; projet : seule la collision connue ; STL régénérés, `cad/apercu.png` gardé (invisible à cette échelle) | `cad/escalier.*`, `cad/projet_escalier.*`, `cad/*.stl`, `CONCEPTION.md` |
| 2026-10-30 | Potelets en tube 30 × 30 × 2 (non terminé, enregistré à la demande de l'utilisateur) | `potelet_l` 40 → 30, `potelet_ep` 10 → 2 (paroi) ; les 4 Frame Member des potelets en `rect_tube` ; bandes de coupe élargies (`2 * potelet_l`) et décalées pour que le tube entre de 1 mm dans les platines (sinon union en échec ou platine haute séparée) ; volumes cohérents (≈ 255 cm³ par potelet de volée, 272 cm³ au palier, vide intérieur fermé par les platines), 0 erreur ; **trous des limons suspendus**, interférences et balayages non refaits ; projet : lien mis à jour ; STL et aperçu régénérés (sans les trous des limons) | `cad/escalier.*`, `cad/projet_escalier.*`, `cad/*.stl`, `cad/apercu.png`, `CONCEPTION.md` |
| 2026-10-30 | Vitesse de recalcul | Branche `vitesse-recalcul` depuis `main` ; diagnostic (§6.3) : recalcul complet 50 s, reprises du booléen sur les perçages des limons (congés de l'UPE) et sur les platines basses des potelets ; `limon_r` 13 → 0 (D19) ; `coupe_potelet_v1/v2_penetration` +1 → +3 mm ; dossier de timeline des trous des limons et du palier ; recalcul complet ≈ 30 s ; 106 corps, 0 erreur, 0 interférence ; signalé à SolidCraft (tangency-labs/solidcraft#9724) ; projet : lien mis à jour, seule la collision connue ; STL régénérés, `cad/apercu.png` gardé (changement invisible à cette échelle) | `cad/escalier.*`, `cad/projet_escalier.*`, `cad/*.stl`, `CONCEPTION.md` |
| 2026-10-31 | Enregistrement direct dans `cad/` | Connecteur MCP lancé avec `--allow-path "<projet>/cad"` (`~/.claude.json`) ; `escalier` ouvert depuis `cad/`, enregistré en `.json` puis `.solidcraft` sans copie ni réouverture, fichiers identiques, 106 corps, 0 erreur ; §6.2 mis à jour ; `*.bak` et `.~*.lock` ignorés par Git ; l'ancien `cad/escalier.solidcraft.bak` (27/10, non suivi) a été écrasé par le `save` ; géométrie inchangée | `CONCEPTION.md`, `.gitignore` |
| 2026-10-31 | Mains courantes carrées, montante d'une seule pièce | Branche `mc-carree` ; `mc_d` → `mc_cote` (45, choix de l'utilisateur) ; 3 Frame Member `round_bar` → `bar` carré ; les 2 Pipe du palier (corps séparés) remplacés par des balayages carrés joints à `Main courante ext V1/V2` (plans et esquisses de section, coudes en onglet) : chaque main courante ext est un seul corps (1 coque, 8 faces) ; paramètres de fonctions renommés ; 104 corps (27 chêne, 77 acier), 0 erreur, 0 interférence ; tests `mc_cote` 45 → 50 → 45, `mc_h` 900 → 950 → 900, `nb_volee1` 16 → 15 → 16 OK (trous suspendus pendant les tests, réactivés) ; projet : lien mis à jour, seule la collision connue ; STL et aperçu régénérés | `cad/escalier.*`, `cad/projet_escalier.*`, `cad/*.stl`, `cad/apercu.png`, `CONCEPTION.md` |
| 2026-10-31 | Tests hors de l'app | Essai de `solidcraft-cli run` sur une copie de `cad/escalier.json` (tests `mc_cote`, `mc_h`, `nb_volee1` aller-retour, 0 erreur) ; méthode et temps notés au §6.2, outil ajouté au §6.1 ; modèle inchangé | `CONCEPTION.md` |
| 2026-10-31 | Règles spécialisées | `REGLES_AGENT_3D.md` remplacé par `REGLES_SOLIDCRAFT_GITHUB_CLAUDE.md` (dépôt `cad-agent-rules`, lien vers les règles génériques) ; `AGENTS.md`, `README.md` et renvois de `CONCEPTION.md` mis à jour | `REGLES_*.md`, `AGENTS.md`, `README.md`, `CONCEPTION.md` |
| 2026-10-31 | Enregistrement allégé | Plus de `.json` ni d'exports (STL, aperçu) dans le dépôt : 3 `.json`, 2 STL et `cad/apercu.png` retirés et ignorés (`.gitignore`) ; README sans image ni vue 3D ; D7, §6.2 et §6.5 mis à jour ; tests en ligne de commande depuis le `.solidcraft` (vérifié) ; règles §3 et §4 mises à jour | `cad/`, `.gitignore`, `README.md`, `CONCEPTION.md`, `REGLES_SOLIDCRAFT_GITHUB_CLAUDE.md` |
| 2026-10-31 | Règles sorties de la conception | Pièges propres à SolidCraft, convention de nommage des cotes, enregistrement par le connecteur, une branche à la fois par modèle : déplacés de `CONCEPTION.md` (§3, §6.2, §6.3, §6.5) vers les règles (§3, §4, §6, §7, §8) ; `CONCEPTION.md` garde les pièges du modèle | `CONCEPTION.md`, `REGLES_SOLIDCRAFT_GITHUB_CLAUDE.md` |
| 2026-10-31 | Platines des pieds du palier : en tête (15 mm, 2 M12) et au sol (15 mm, 4 chevilles M12 supposées) | [PR #13](https://github.com/mj42584/staircase_solidcraft_claude/pull/13) | `cad/escalier.solidcraft`, `cad/projet_escalier.solidcraft`, `CONCEPTION.md` |
| 2026-10-31 | Plus de mise à jour du projet à chaque tâche | Règles §3 : le projet d'assemblage n'est plus ouvert ni réenregistré après chaque modification (il relit le modèle lié à l'ouverture) ; interférences avec l'environnement à la demande | `REGLES_SOLIDCRAFT_GITHUB_CLAUDE.md`, `CONCEPTION.md` |
| 2026-10-31 | Répartition 15/7 : noms et matériaux des corps des réseaux, projet recalé | [PR #15](https://github.com/mj42584/staircase_solidcraft_claude/pull/15) | `cad/escalier.solidcraft`, `CONCEPTION.md` |
| 2026-10-31 | Pièces soudées en sous-composants : cadre, 4 pieds, 4 limons (corps séparés) | [PR #16](https://github.com/mj42584/staircase_solidcraft_claude/pull/16) | `cad/escalier.solidcraft`, `CONCEPTION.md` |
| 2026-11-01 | Ensembles soudés avec leurs fonctions : perçages scindés, un Frame Member par pied | [PR #17](https://github.com/mj42584/staircase_solidcraft_claude/pull/17) | `cad/escalier.solidcraft`, `CONCEPTION.md` |
| 2026-11-01 | Potelets : 2 ensembles soudés de 3 corps, posés 12 et 5 fois, liés aux trous | [PR #18](https://github.com/mj42584/staircase_solidcraft_claude/pull/18) | `cad/escalier.solidcraft`, `CONCEPTION.md` |
| 2026-11-01 | Mesures de vitesse après les ensembles (recalcul complet 27 → 7,7 s) | [PR #19](https://github.com/mj42584/staircase_solidcraft_claude/pull/19) | `CONCEPTION.md` |
| 2026-11-01 | Règles de l'agent : conception par ensembles (composants soudés, pièces posées N fois et liées), pièges SolidCraft | [PR #20](https://github.com/mj42584/staircase_solidcraft_claude/pull/20) | `REGLES_SOLIDCRAFT_GITHUB_CLAUDE.md`, `CONCEPTION.md` |
| 2026-11-01 | Mise à jour SolidCraft 0.27.1 → 0.29.0 : 3 modèles contrôlés et réenregistrés au format 46 ; `check_parameters`, `expect` et oblongs cotés testés | [PR #21](https://github.com/mj42584/staircase_solidcraft_claude/pull/21) | `cad/*.solidcraft`, `CONCEPTION.md`, `REGLES_SOLIDCRAFT_GITHUB_CLAUDE.md` |
| 2026-11-01 | Essai de sous-composants imbriqués (nomenclature des pièces des ensembles) | [PR #22](https://github.com/mj42584/staircase_solidcraft_claude/pull/22) | `CONCEPTION.md` |
| 2026-11-01 | Un composant par pièce, avec ses fonctions ; marches et équerres en réseaux, un par composant | [PR #23](https://github.com/mj42584/staircase_solidcraft_claude/pull/23) | `cad/escalier.solidcraft`, `CONCEPTION.md`, `REGLES_SOLIDCRAFT_GITHUB_CLAUDE.md` |
| 2026-11-01 | Règles : réorganiser sans changer la géométrie, références, masquage, copie d'exemplaire, perçage par pièce | [PR #24](https://github.com/mj42584/staircase_solidcraft_claude/pull/24) | `REGLES_SOLIDCRAFT_GITHUB_CLAUDE.md`, `CONCEPTION.md` |
| 2026-11-01 | Mesure de vitesse après un composant par pièce (aucun écart) | [PR #25](https://github.com/mj42584/staircase_solidcraft_claude/pull/25) | `CONCEPTION.md` |
| 2026-11-01 | Mains courantes ext : rampe et horizontale du palier en pièces séparées, profils extrudés ; int V2 rallongée jusqu'au haut de int V1 | [PR #26](https://github.com/mj42584/staircase_solidcraft_claude/pull/26) | `cad/escalier.solidcraft`, `CONCEPTION.md` |
| 2026-11-01 | Potelets latéraux du palier à 215 mm du bord avant | [PR #27](https://github.com/mj42584/staircase_solidcraft_claude/pull/27) | `cad/escalier.solidcraft`, `CONCEPTION.md` |
| 2026-11-02 | Potelets du palier à 2 coques : vérifié, réglé (148 corps fermés à 1 coque depuis les potelets en 3 corps, D20) ; point retiré | [PR #28](https://github.com/mj42584/staircase_solidcraft_claude/pull/28) | `CONCEPTION.md` |
| 2026-11-02 | Potelets d'angle du fond : vis de la platine haute rentrées sous la main courante du fond (`potelet_fond_marge`, D24) | [PR #29](https://github.com/mj42584/staircase_solidcraft_claude/pull/29) | `cad/escalier.solidcraft`, `CONCEPTION.md` |
| 2026-11-02 | Premier potelet de int V2 en face du dernier de int V1 (porte-à-faux 408 → 149 mm, D25) ; retrait fixe des potelets du palier accepté (D23) | [PR #30](https://github.com/mj42584/staircase_solidcraft_claude/pull/30) | `cad/escalier.solidcraft`, `CONCEPTION.md` |
| 2026-11-02 | Un potelet de plus à l'arrière de chaque main courante latérale du palier (D26) | [PR #31](https://github.com/mj42584/staircase_solidcraft_claude/pull/31) | `cad/escalier.solidcraft`, `CONCEPTION.md` |
| 2026-11-02 | Revue des points ouverts des mains courantes : nombre de potelets validé, distance au poteau recalculée, point « accès à toutes les vis pour le montage » créé | [PR #32](https://github.com/mj42584/staircase_solidcraft_claude/pull/32) | `CONCEPTION.md` |
| 2026-11-02 | Potelets de volée verticaux quel que soit le giron (D27) ; revue du §7 : points fermés (hauteurs NF P01-012, 17 mm au poteau, hauteur libre, tube 30 × 30, platines d'about soudées, nomenclature par réseau), projet d'assemblage en suspens | [PR #33](https://github.com/mj42584/staircase_solidcraft_claude/pull/33) | `cad/escalier.solidcraft`, `CONCEPTION.md` |
| 2026-11-02 | Points fermés : masse totale reconstituée par `measure` (1 146,0 kg, D13), nombre fixe de potelets et de pieds accepté (D20), noms `Limon ext/int V1/V2` gardés (HG / HD / BD / BG abandonnés) | [PR #34](https://github.com/mj42584/staircase_solidcraft_claude/pull/34) | `CONCEPTION.md` |
| 2026-11-02 | Pied des limons V1 : platine verticale et platine au sol à 2 chevilles, soudées au limon (D28) | [PR #35](https://github.com/mj42584/staircase_solidcraft_claude/pull/35) | `cad/escalier.solidcraft`, `CONCEPTION.md` |
| 2026-11-02 | Stabilité du palier recalculée (3848 / 15/7 / 60, pieds de limons V1 articulés, poussée des mains courantes) : palier non contreventé en travers (D29) | [PR #36](https://github.com/mj42584/staircase_solidcraft_claude/pull/36) | `calc/predim.py`, `calc/portique.py`, `CONCEPTION.md` |
| 2026-11-02 | Rapport de calcul en PDF (données d'entrée, prédimensionnement, modèle en barres, conclusion) ; limons vérifiés en flexion forte + faible, signe de N des pieds et sens de la poussée corrigés ; ancien rapport du 2026-10-27 retiré | [PR #36](https://github.com/mj42584/staircase_solidcraft_claude/pull/36) | `calc/rapport_calcul.pdf`, `calc/rapport/`, `calc/portique.py`, `CONCEPTION.md` |
| 2026-11-03 | Contreventement du palier : une diagonale en tube par face d'about, calculée (0,29 mm en travers, diagonales à 31 %, D30) | [PR #37](https://github.com/mj42584/staircase_solidcraft_claude/pull/37) | `calc/portique.py`, `CONCEPTION.md` |
| 2026-11-03 | Suite de la revue externe du calcul : chevilles, équilibre, poids des mains courantes, potelets et torsion des limons ; **garde-corps non conforme** (D31) ; rapport mis à jour avec les diagonales | [PR #37](https://github.com/mj42584/staircase_solidcraft_claude/pull/37) | `calc/predim.py`, `calc/portique.py`, `calc/rapport/`, `calc/rapport_calcul.pdf`, `CONCEPTION.md` |
| 2026-11-03 | Raideur des liaisons marche-cornière calculée pour 3 vis à bois Ø5 par cornière (k = 7e7, plafond) ; limons V1 en torsion 11 %, vis la plus tendue 53 % ; rapport mis à jour | [PR #39](https://github.com/mj42584/staircase_solidcraft_claude/pull/39) | `calc/predim.py`, `calc/portique.py`, `calc/rapport/`, `calc/rapport_calcul.pdf`, `CONCEPTION.md` |
| 2026-11-03 | Trous des vis à bois des cornières dans les marches et les cornières (3 par cornière, D35) ; vis non modélisées | PR vis-bois-cornieres | `cad/escalier.solidcraft`, `CONCEPTION.md` |
| 2026-11-03 | Diagonales en tube 40 × 40 × 3 (D36) | [PR #42](https://github.com/mj42584/staircase_solidcraft_claude/pull/42) | `cad/escalier.solidcraft`, `calc/portique.py`, `calc/rapport/`, `calc/rapport_calcul.pdf`, `CONCEPTION.md` |
| 2026-11-03 | Chevilles des pieds vérifiées avec hypothèses (D37) | [PR #43](https://github.com/mj42584/staircase_solidcraft_claude/pull/43) | `calc/predim.py`, `calc/portique.py`, `calc/rapport/`, `calc/rapport_calcul.pdf`, `CONCEPTION.md` |
| 2026-11-03 | `q_gc` = 0,6 kN/m validé par l'utilisateur (n'est plus une hypothèse) | [PR #44](https://github.com/mj42584/staircase_solidcraft_claude/pull/44) | `calc/predim.py`, `calc/rapport/`, `calc/rapport_calcul.pdf`, `CONCEPTION.md` |
| 2026-11-03 | Vérifications locales (`assemblages.py`) et une seule volée chargée (D38) | [PR #45](https://github.com/mj42584/staircase_solidcraft_claude/pull/45) | `calc/assemblages.py`, `calc/portique.py`, `calc/predim.py`, `calc/rapport/`, `calc/rapport_calcul.pdf`, `CONCEPTION.md` |
| 2026-11-03 | Platine basse des potelets en 10 mm (D39) | [PR #46](https://github.com/mj42584/staircase_solidcraft_claude/pull/46) | `cad/escalier.solidcraft`, `calc/predim.py`, `calc/assemblages.py`, `calc/rapport/`, `calc/rapport_calcul.pdf`, `CONCEPTION.md` |
| 2026-11-03 | Suite de la seconde revue externe du calcul (D40) | [PR #47](https://github.com/mj42584/staircase_solidcraft_claude/pull/47) | `calc/predim.py`, `calc/portique.py`, `calc/assemblages.py`, `calc/rapport/`, `calc/rapport_calcul.pdf`, `CONCEPTION.md` |
| 2026-11-03 | Diagonales du palier dans le 3D : goussets soudés sur les pieds (2 types de pieds), `Ensemble diagonale` posé 2 fois, liée au cadre (D30) | [PR #37](https://github.com/mj42584/staircase_solidcraft_claude/pull/37) | `cad/escalier.solidcraft`, `CONCEPTION.md`, `REGLES_SOLIDCRAFT_GITHUB_CLAUDE.md` |
| 2026-11-03 | `portique.py` recalé sur les trous des goussets : diagonales 3,00 m à 25 %, chevilles des poteaux 2,5 kN (D30) | [PR #37](https://github.com/mj42584/staircase_solidcraft_claude/pull/37) | `calc/portique.py`, `CONCEPTION.md` |
| 2026-11-03 | Potelets de volée : 5 par main courante sur V1, 3 sur V2 (D32) ; essai des marches comme traverses dans `portique.py` | branche `marches-traverses` | `cad/escalier.solidcraft`, `calc/portique.py`, `calc/predim.py`, `CONCEPTION.md` |
| 2026-11-03 | Cornières des marches en 50 × 50 × 5 (D33) | branche `marches-traverses` | `cad/escalier.solidcraft`, `CONCEPTION.md` |
| 2026-11-03 | Potelets en tube 40 × 40 × 3 et un potelet de plus au fond (D34) | branche `marches-traverses` | `cad/escalier.solidcraft`, `calc/predim.py`, `CONCEPTION.md` |
| 2026-11-07 | Jeu entre limons 200 mm (`jeu_limons`, modifié par l'utilisateur) et limite d'accès dans l'environnement ; SolidCraft 0.30.1, format 48 | [PR #49](https://github.com/mj42584/staircase_solidcraft_claude/pull/49) | `cad/escalier.solidcraft`, `cad/environnement.solidcraft`, `CONCEPTION.md` |
| 2026-11-07 | Mise au propre 0.30.1 : les 3 modèles réenregistrés sans cache ; ouverture d'accès de l'environnement et ses paramètres renommés (`acces_*`) ; commande de lancement de l'app avec `--share=network` | [PR #50](https://github.com/mj42584/staircase_solidcraft_claude/pull/50) | `cad/escalier.solidcraft`, `cad/environnement.solidcraft`, `CONCEPTION.md` |
| 2026-11-08 | Références des platines de pied V1 : `ESC-260` (sol) et `ESC-261` (verticale), posées sur les 4 composants ; plus aucune pièce sans référence | [PR #51](https://github.com/mj42584/staircase_solidcraft_claude/pull/51) | `cad/escalier.solidcraft`, `CONCEPTION.md` |
| 2026-11-08 | Référence `ESC-251` pour les 2 platines palier V2 (oblongs décalés), `ESC-250` ramenée à 4 pièces | [PR #52](https://github.com/mj42584/staircase_solidcraft_claude/pull/52) | `cad/escalier.solidcraft`, `CONCEPTION.md` |
| 2026-11-08 | Nomenclature de l'escalier versionnée (tableur, 42 références ; 40 après les fusions ESC-103/104 et ESC-250/251) | [PR #53](https://github.com/mj42584/staircase_solidcraft_claude/pull/53) | `nomenclature_escalier.ods`, `CONCEPTION.md` |
| 2026-11-08 | Fusion de `ESC-104` dans `ESC-103` : poutres latérales V1 et V2 strictement identiques (contrôle de tous les corps, recalage à 0,05 mm) ; nomenclature : 41 références | [PR #54](https://github.com/mj42584/staircase_solidcraft_claude/pull/54) | `cad/escalier.solidcraft`, `nomenclature_escalier.ods`, `CONCEPTION.md` |
| 2026-11-08 | Oblongs identiques sur les 6 platines d'about : `ESC-251` fusionnée dans `ESC-250` (6 pièces). `percage_palier_v2_z_haut` et `percage_arrivee_v2_z_haut` calés sur V1 (écart de haut de platine) ; les 4 trous V2 de la poutre avant (ESC-101) montent de 19,15 mm (`trou_poutre_v2_*_z`) ; arrivée V2 : 0,08 mm. 0 erreur, 0 interférence ; essai `limon_dessus` + 7, `boulons_entraxe` 120, `platine_ep` 12 : 6 platines toujours identiques. Plan ESC-250 régénéré, plan ESC-251 supprimé | [PR #55](https://github.com/mj42584/staircase_solidcraft_claude/pull/55) | `cad/escalier.solidcraft`, `nomenclature_escalier.ods`, `plans/`, `CONCEPTION.md` |
| 2026-11-08 | Plans des 9 tôles en découpe laser (ESC-250, 260, 261, 302, 303, 304, 402, 403, 802) ; acier S235 confirmé par l'utilisateur | [PR #56](https://github.com/mj42584/staircase_solidcraft_claude/pull/56) | `plans/`, `plans/dxf/`, `CONCEPTION.md` |
