mj42584/staircase_solidcraft_claude/nomenclature_escalier.ods

Sheet: Nomenclature
Nomenclature — Escalier à demi-tour
Type | Repère | Référence | Désignation | Qté par ensemble | Qté totale | Matière | Profil / épaisseur | Longueur / dimensions (mm)
Ensemble soudé | 1 | ESC-100 | Ensemble cadre palier |  | 1
Pièce | 1.1 | ESC-101 | Poutre avant palier | 1 | 1 | Acier | UPE 220 | L 2540, onglets 45°
Pièce | 1.2 | ESC-102 | Poutre arrière palier | 1 | 1 | Acier | UPE 220 | L 2540, onglets 45°
Pièce | 1.3 | ESC-103 | Poutre latérale V1 | 1 | 1 | Acier | UPE 220 | L 1000, onglets 45°
Pièce | 1.4 | ESC-103 | Poutre latérale V2 | 1 | 1 | Acier | UPE 220 | L 1000, onglets 45°
Ensemble soudé | 2 | ESC-200 | Ensemble limon ext V1 |  | 1
Pièce | 2.1 | ESC-201 | Limon ext V1 | 1 | 1 | Acier | UPE 220 | L 4515 hors tout
Pièce | 2.2 | ESC-250 | Platine ext V1 | 1 | 1 | Acier | Tôle ép. 15 | 261 × 85
Pièce | 2.3 | ESC-260 | Platine sol pied ext V1 | 1 | 1 | Acier | Tôle ép. 15 | 200 × 85
Pièce | 2.4 | ESC-261 | Platine verticale pied ext V1 | 1 | 1 | Acier | Tôle ép. 15 | 139,5 × 85
Pièce | 2.5 | ESC-510 | Équerres ext V1 | 14 | 14 | Acier | Cornière 50 × 50 × 5 | L 200
Ensemble soudé | 3 | ESC-210 | Ensemble limon int V1 |  | 1
Pièce | 3.1 | ESC-211 | Limon int V1 | 1 | 1 | Acier | UPE 220 | L 4515 hors tout
Pièce | 3.2 | ESC-250 | Platine int V1 | 1 | 1 | Acier | Tôle ép. 15 | 261 × 85
Pièce | 3.3 | ESC-260 | Platine sol pied int V1 | 1 | 1 | Acier | Tôle ép. 15 | 200 × 85
Pièce | 3.4 | ESC-261 | Platine verticale pied int V1 | 1 | 1 | Acier | Tôle ép. 15 | 139,5 × 85
Pièce | 3.5 | ESC-510 | Équerres int V1 | 14 | 14 | Acier | Cornière 50 × 50 × 5 | L 200
Ensemble soudé | 4 | ESC-220 | Ensemble limon ext V2 |  | 1
Pièce | 4.1 | ESC-221 | Limon ext V2 | 1 | 1 | Acier | UPE 220 | L 2240 hors tout
Pièce | 4.2 | ESC-250 | Platine ext V2 | 1 | 1 | Acier | Tôle ép. 15 | 261 × 85
Pièce | 4.3 | ESC-510 | Équerres ext V2 | 7 | 7 | Acier | Cornière 50 × 50 × 5 | L 200
Pièce | 4.4 | ESC-250 | Platine palier ext V2 | 1 | 1 | Acier | Tôle ép. 15 | 261 × 85
Ensemble soudé | 5 | ESC-230 | Ensemble limon int V2 |  | 1
Pièce | 5.1 | ESC-231 | Limon int V2 | 1 | 1 | Acier | UPE 220 | L 2240 hors tout
Pièce | 5.2 | ESC-250 | Platine int V2 | 1 | 1 | Acier | Tôle ép. 15 | 261 × 85
Pièce | 5.3 | ESC-510 | Équerres int V2 | 7 | 7 | Acier | Cornière 50 × 50 × 5 | L 200
Pièce | 5.4 | ESC-250 | Platine palier int V2 | 1 | 1 | Acier | Tôle ép. 15 | 261 × 85
Ensemble soudé | 6 | ESC-300 | Ensemble pied gousset bas |  | 2
Pièce | 6.1 | ESC-301 | Tube pied | 1 | 2 | Acier | Tube carré 100 × 100 × 5 | L 2313,6
Pièce | 6.2 | ESC-302 | Platine tête pied | 1 | 2 | Acier | Tôle ép. 15 | 180 × 180
Pièce | 6.3 | ESC-303 | Platine sol pied | 1 | 2 | Acier | Tôle ép. 15 | 180 × 180
Pièce | 6.4 | ESC-304 | Gousset pied bas | 1 | 2 | Acier | Tôle ép. 10 | 120 × 120
Ensemble soudé | 7 | ESC-310 | Ensemble pied gousset haut |  | 2
Pièce | 7.1 | ESC-301 | Tube pied haut | 1 | 2 | Acier | Tube carré 100 × 100 × 5 | L 2313,6
Pièce | 7.2 | ESC-302 | Platine tête pied haut | 1 | 2 | Acier | Tôle ép. 15 | 180 × 180
Pièce | 7.3 | ESC-303 | Platine sol pied haut | 1 | 2 | Acier | Tôle ép. 15 | 180 × 180
Pièce | 7.4 | ESC-304 | Gousset pied haut | 1 | 2 | Acier | Tôle ép. 10 | 120 × 120
Ensemble soudé | 8 | ESC-400 | Ensemble potelet volée |  | 16
Pièce | 8.1 | ESC-401 | Tube potelet volée | 1 | 16 | Acier | Tube carré 40 × 40 × 3 | L 911 hors tout, coupes biaises
Pièce | 8.2 | ESC-402 | Platine basse potelet volée | 1 | 16 | Acier | Tôle ép. 10 | 130 × 50
Pièce | 8.3 | ESC-403 | Platine haute potelet volée | 1 | 16 | Acier | Tôle ép. 5 | 100 × 40
Ensemble soudé | 9 | ESC-410 | Ensemble potelet palier |  | 8
Pièce | 9.1 | ESC-402 | Platine basse potelet palier | 1 | 8 | Acier | Tôle ép. 10 | 130 × 50
Pièce | 9.2 | ESC-403 | Platine haute potelet palier | 1 | 8 | Acier | Tôle ép. 5 | 100 × 40
Pièce | 9.3 | ESC-411 | Tube potelet palier | 1 | 8 | Acier | Tube carré 40 × 40 × 3 | L 962,5
Pièce | 10 | ESC-500 | Marches |  | 21 | Chêne | Plateau ép. 60 | 274 × 1000
Pièce | 11 | ESC-600 | Plancher palier |  | 1 | Chêne | Plateau ép. 60 | 1000 × 2540
Pièce | 12 | ESC-701 | Main courante ext V1 |  | 1 | Chêne | Carré 45 × 45 | L ≈ 4737 (rampe + raccord)
Pièce | 13 | ESC-702 | Main courante int V1 |  | 1 | Chêne | Carré 45 × 45 | L 4533
Pièce | 14 | ESC-703 | Main courante ext V2 |  | 1 | Chêne | Carré 45 × 45 | L ≈ 2072 (rampe + raccord)
Pièce | 15 | ESC-704 | Main courante int V2 |  | 1 | Chêne | Carré 45 × 45 | L 2240
Pièce | 16 | ESC-705 | Main courante fond |  | 1 | Chêne | Carré 45 × 45 | L 2410
Pièce | 17 | ESC-706 | Main courante palier V1 |  | 1 | Chêne | Carré 45 × 45 | L ≈ 823, un bout en onglet
Pièce | 18 | ESC-707 | Main courante palier V2 |  | 1 | Chêne | Carré 45 × 45 | L ≈ 1137, un bout en onglet
Ensemble soudé | 19 | ESC-800 | Ensemble diagonale |  | 2
Pièce | 19.1 | ESC-801 | Tube diagonale | 1 | 2 | Acier | Tube carré 40 × 40 × 3 | L 2832
Pièce | 19.2 | ESC-802 | Languette basse diagonale + Languette haute diagonale | 2 | 4 | Acier | Tôle ép. 10 | 230 × 40

Sheet: Récapitulatif pièce
Récapitulatif par référence, trié par matière et profil
 | Référence | Désignation | Qté totale | Matière | Profil / épaisseur | Longueur / dimensions (mm)
 | ESC-510 | Équerres de marches | 42 | Acier | Cornière 50 × 50 × 5 | L 200
 | ESC-802 | Languette basse diagonale + Languette haute diagonale | 4 | Acier | Tôle ép. 10 | 230 × 40
 | ESC-301 | Tube pied + Tube pied haut | 4 | Acier | Tube carré 100 × 100 × 5 | L 2313,6
 | ESC-401 | Tube potelet volée | 16 | Acier | Tube carré 40 × 40 × 3 | L 911 hors tout, coupes biaises
 | ESC-411 | Tube potelet palier | 8 | Acier | Tube carré 40 × 40 × 3 | L 962,5
 | ESC-801 | Tube diagonale | 2 | Acier | Tube carré 40 × 40 × 3 | L 2832
 | ESC-250 | Platine ext V1 + Platine int V1 + Platine ext V2 + Platine int V2 + Platine palier ext V2 + Platine palier int V2 | 6 | Acier | Tôle ép. 15 | 261 × 85
 | ESC-302 | Platine tête pied + Platine tête pied haut | 4 | Acier | Tôle ép. 15 | 180 × 180
 | ESC-303 | Platine sol pied + Platine sol pied haut | 4 | Acier | Tôle ép. 15 | 180 × 180
 | ESC-260 | Platine sol pied V1 | 2 | Acier | Tôle ép. 15 | 200 × 85
 | ESC-261 | Platine verticale pied V1 | 2 | Acier | Tôle ép. 15 | 139,5 × 85
 | ESC-304 | Gousset pied bas + Gousset pied haut | 4 | Acier | Tôle ép. 10 | 120 × 120
 | ESC-402 | Platine basse potelet volée + Platine basse potelet palier | 24 | Acier | Tôle ép. 10 | 130 × 50
 | ESC-403 | Platine haute potelet volée + Platine haute potelet palier | 24 | Acier | Tôle ép. 5 | 100 × 40
 | ESC-101 | Poutre avant palier | 1 | Acier | UPE 220 | L 2540, onglets 45°
 | ESC-102 | Poutre arrière palier | 1 | Acier | UPE 220 | L 2540, onglets 45°
 | ESC-103 | Poutre latérale | 2 | Acier | UPE 220 | L 1000, onglets 45°
 | ESC-201 | Limon ext V1 | 1 | Acier | UPE 220 | L 4515 hors tout
 | ESC-211 | Limon int V1 | 1 | Acier | UPE 220 | L 4515 hors tout
 | ESC-221 | Limon ext V2 | 1 | Acier | UPE 220 | L 2240 hors tout
 | ESC-231 | Limon int V2 | 1 | Acier | UPE 220 | L 2240 hors tout
 | ESC-701 | Main courante ext V1 | 1 | Chêne | Carré 45 × 45 | L ≈ 4737 (rampe + raccord)
 | ESC-702 | Main courante int V1 | 1 | Chêne | Carré 45 × 45 | L 4533
 | ESC-703 | Main courante ext V2 | 1 | Chêne | Carré 45 × 45 | L ≈ 2072 (rampe + raccord)
 | ESC-704 | Main courante int V2 | 1 | Chêne | Carré 45 × 45 | L 2240
 | ESC-705 | Main courante fond | 1 | Chêne | Carré 45 × 45 | L 2410
 | ESC-706 | Main courante palier V1 | 1 | Chêne | Carré 45 × 45 | L ≈ 823, un bout en onglet
 | ESC-707 | Main courante palier V2 | 1 | Chêne | Carré 45 × 45 | L ≈ 1137, un bout en onglet
 | ESC-500 | Marches V1 + V2 | 21 | Chêne | Plateau ép. 60 | 274 × 1000
 | ESC-600 | Plancher palier | 1 | Chêne | Plateau ép. 60 | 1000 × 2540

Sheet: Notes
Notes et limites
Source : cad/escalier.solidcraft (SolidCraft 0.30.1), relu le 2026-11-08 : hauteur 3848, 22 contremarches, volées 15/7, 0 erreur.
Quantités : celles du modèle. Exception : la nomenclature SolidCraft compte Marches (ESC-500) et Équerres (ESC-510) par réseau (2 et 4) ; ici elles sont comptées par pièce réelle (21 marches, 42 équerres).
Équerres : réparties ici dans les ensembles soudés limon, par côté et par volée ; dans le modèle, elles restent des composants à part (réseaux à la racine).
Contrôle : 183 pièces dans cette nomenclature = 183 corps dans le modèle.
Matière : celle affectée aux corps du modèle (Steel = acier, Oak = chêne). La nuance d'acier et la qualité du chêne ne sont pas définies dans le modèle.
UPE 220 : cotes EN 10365 ; congés de laminage non modélisés (limon_r = 0).
Longueurs : limons = plus grande longueur calculée (projection horizontale / cos de la pente) ; mains courantes « ≈ » = volume / section, longueur moyenne d'une pièce à coupe biaise ; à contrôler avant débit, sans surcote de coupe.
Platines de pied de limon V1 : ESC-260 (sol) et ESC-261 (verticale), mêmes pièces en ext et en int.
Hors nomenclature, car non modélisé : boulons M12, vis et boulons M8, vis à bois, chevilles de scellement, soudures, finitions.

Sheet: Commande
Commande matière par profil
Profilés — barres à commander, découpe et perçage par mes soins
Profil / épaisseur | Matière | Qté à commander | Unité | Format commercial | Besoin | Unité besoin | Calepinage (longueurs en mm)
Cornière 50 × 50 × 5 | Acier | 2 | barre | 6000 mm (supposé) | 8,4 | m | 1 × [ 29 × 200 ] ; 1 × [ 13 × 200 ]
Tube carré 100 × 100 × 5 | Acier | 2 | barre | 6000 mm (supposé) | 9,25 | m | 2 × [ 2 × 2313,6 ]
Tube carré 40 × 40 × 3 | Acier | 5 | barre | 6000 mm (supposé) | 27,94 | m | 1 × [ 2 × 2832 ] ; 1 × [ 6 × 962,5 ] ; 1 × [ 2 × 962,5 + 4 × 911 ] ; 2 × [ 6 × 911 ]
UPE 220 | Acier | 4 | barre | 6000 mm (supposé) | 20,59 | m | 2 × [ 1 × 4515 + 1 × 1000 ] ; 1 × [ 2 × 2540 ] ; 1 × [ 2 × 2240 ]
Carré 45 × 45 | Chêne | 4 | barre | 6000 mm (supposé) | 17,95 | m | 1 × [ 1 × 4737 + 1 × 1137 ] ; 1 × [ 1 × 4533 + 1 × 823 ] ; 1 × [ 1 × 2410 + 1 × 2240 ] ; 1 × [ 1 × 2072 ]
Tôles — pièces finies à commander en découpe laser
Désignation | Référence | Qté à commander | Unité | Dimensions (mm) | Épaisseur (mm) | Matière | Repères (nomenclature)
Platine d'about de limon | ESC-250 | 6 | pièce | 261 × 85 | 15 | Acier | 2.2, 3.2, 4.2, 4.4, 5.2, 5.4
Platine tête pied | ESC-302 | 4 | pièce | 180 × 180 | 15 | Acier | 6.2, 7.2
Platine sol pied | ESC-303 | 4 | pièce | 180 × 180 | 15 | Acier | 6.3, 7.3
Platine sol pied V1 | ESC-260 | 2 | pièce | 200 × 85 | 15 | Acier | 2.3, 3.3
Platine verticale pied V1 | ESC-261 | 2 | pièce | 139,5 × 85 | 15 | Acier | 2.4, 3.4
Gousset pied | ESC-304 | 4 | pièce | 120 × 120 | 10 | Acier | 6.4, 7.4
Languette diagonale | ESC-802 | 4 | pièce | 230 × 40 | 10 | Acier | 19.2
Platine basse potelet | ESC-402 | 24 | pièce | 130 × 50 | 10 | Acier | 8.2, 9.1
Platine haute potelet | ESC-403 | 24 | pièce | 100 × 40 | 5 | Acier | 8.3, 9.2
Total pièces laser |  | 74
Plateaux chêne — à définir
Profil / épaisseur | Matière | Qté à commander | Unité | Format commercial | Besoin | Unité besoin | Calepinage (longueurs en mm)
Plateau ép. 60 | Chêne | à définir |  | à définir | 5,754 | m² | 21 pièce(s) finie(s) de 274 × 1000 mm
Plateau ép. 60 | Chêne | à définir |  | à définir | 2,54 | m² | 1 pièce(s) finie(s) de 1000 × 2540 mm
Supposé, à confirmer auprès du fournisseur : barres de 6000 mm, trait de scie 5 mm. Le chêne en 6 m est peu courant ; les mains courantes imposent au moins 5 m.
Calepinage calculé à partir des longueurs de l'onglet récapitulatif, sans surcote ni pièce de rechange. Les mains courantes « ≈ » ont une longueur moyenne : à contrôler avant débit.
Tôles : dimensions hors tout des pièces finies, sans le détail des perçages. Plateaux : mode d'approvisionnement à décider.
Hors commande : boulons, vis, chevilles (non modélisés).
