mj42584/staircase_solidcraft_claude/plans/dxf/ESC-402.dxf

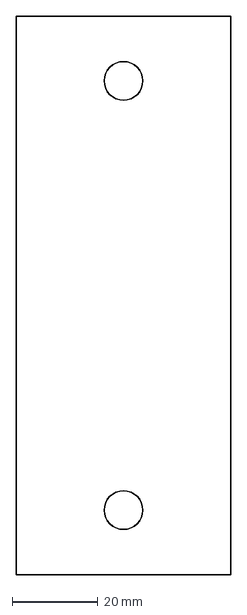
[picture p5: CAD file, 2026-11-08]
plans/dxf/ESC-402.dxf
50.0 x 130.0 mm
