mj42584/staircase_solidcraft_claude/plans/Natif/ESC-303.FCStd

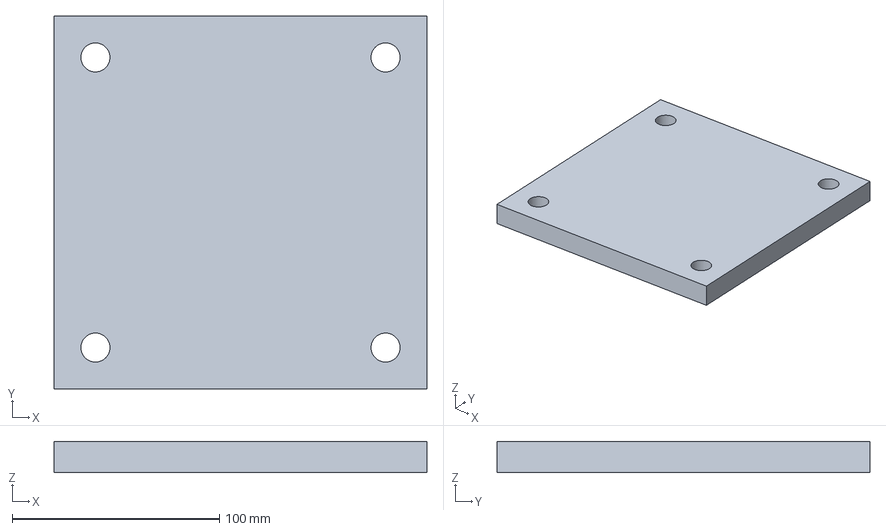
[picture p6: CAD file, 2026-11-08]
plans/Natif/ESC-303.FCStd
180.0 x 180.0 x 15.0 mm
