mj42584/staircase_solidcraft_claude/plans/dxf/ESC-260.dxf

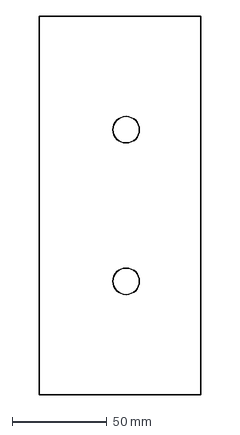
[picture p7: CAD file, 2026-11-08]
plans/dxf/ESC-260.dxf
85.0 x 200.0 mm
