mj42584/staircase_solidcraft_claude/plans/Natif/ESC-403.FCStd

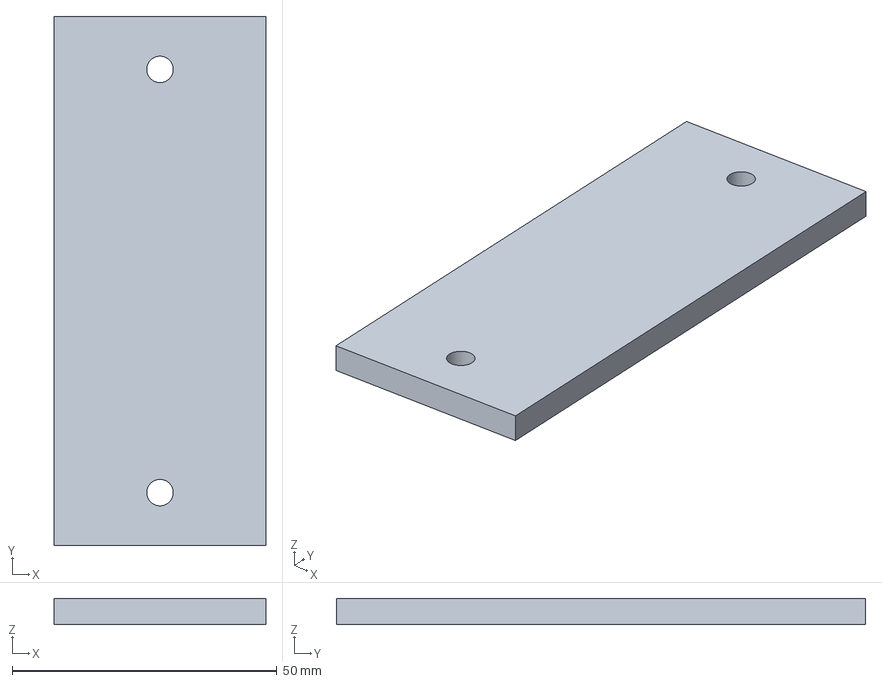
[picture p8: CAD file, 2026-11-08]
plans/Natif/ESC-403.FCStd
40.0 x 100.0 x 5.00 mm
