mj42584/staircase_solidcraft_claude/plans/dxf/ESC-303.dxf

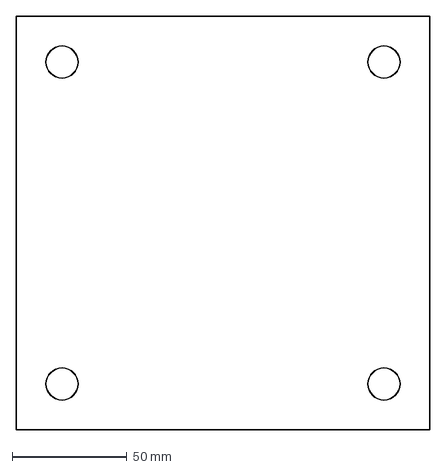
[picture p9: CAD file, 2026-11-08]
plans/dxf/ESC-303.dxf
180.0 x 180.0 mm
