mj42584/staircase_solidcraft_claude/plans/Natif/ESC-250.FCStd

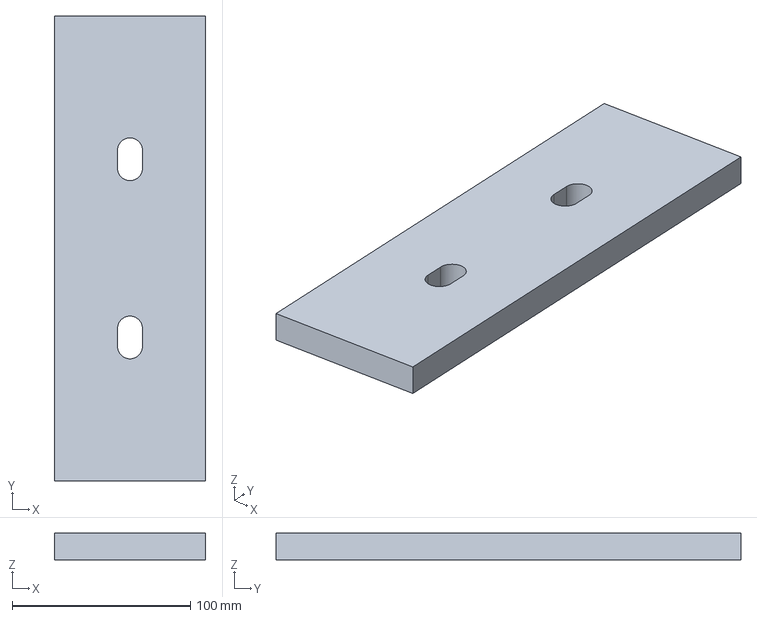
[picture p10: CAD file, 2026-11-08]
plans/Natif/ESC-250.FCStd
85.0 x 261.0 x 15.0 mm
