mj42584/staircase_solidcraft_claude/plans/Natif/ESC-260.FCStd

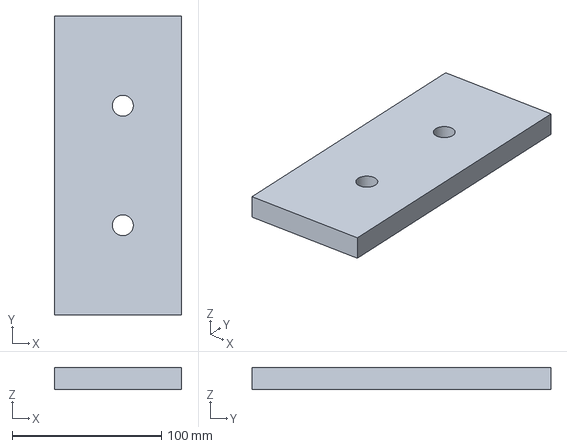
[picture p12: CAD file, 2026-11-08]
plans/Natif/ESC-260.FCStd
85.0 x 200.0 x 15.0 mm
