mj42584/staircase_solidcraft_claude/plans/dxf/ESC-403.dxf

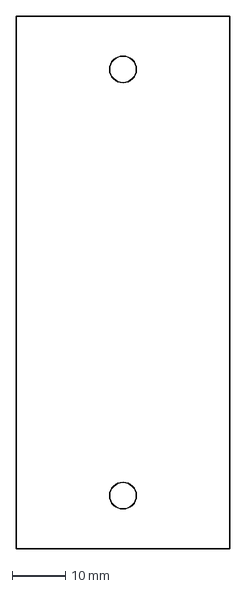
[picture p13: CAD file, 2026-11-08]
plans/dxf/ESC-403.dxf
40.0 x 100.0 mm
