mj42584/staircase_solidcraft_claude/plans/Natif/ESC-304.FCStd

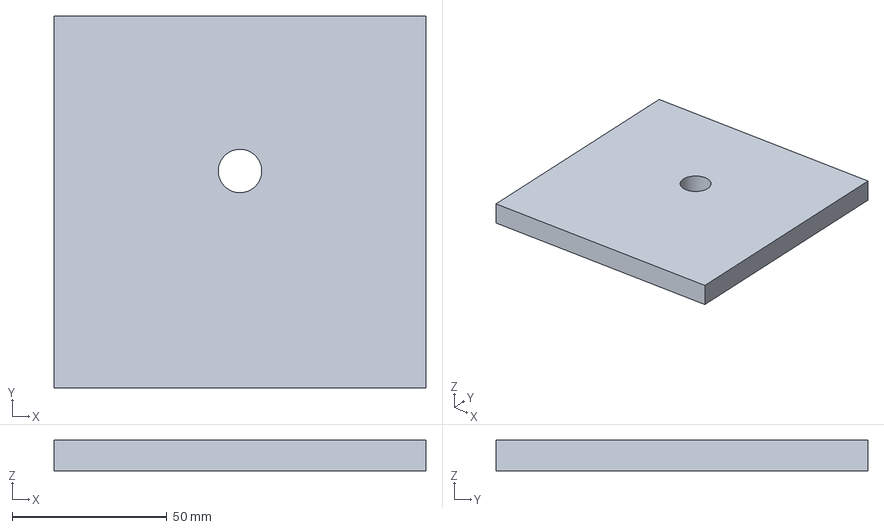
[picture p14: CAD file, 2026-11-08]
plans/Natif/ESC-304.FCStd
120.0 x 120.0 x 10.0 mm
