mj42584/staircase_solidcraft_claude/plans/dxf/ESC-304.dxf

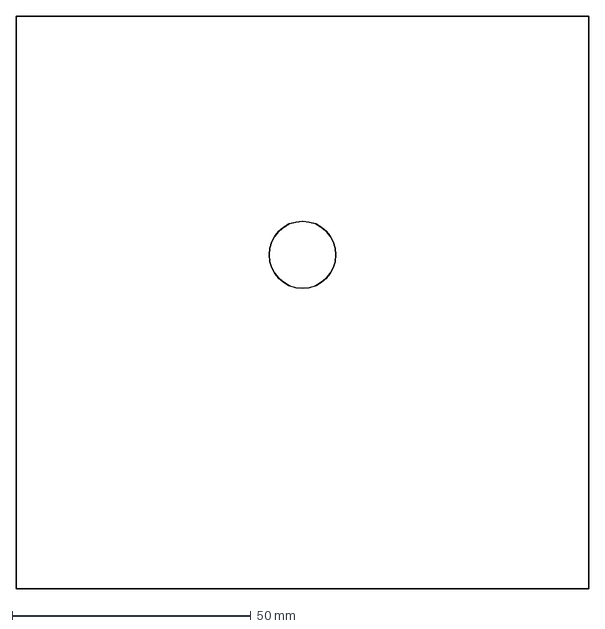
[picture p15: CAD file, 2026-11-08]
plans/dxf/ESC-304.dxf
120.0 x 120.0 mm
