mj42584/staircase_solidcraft_claude/plans/dxf/ESC-250.dxf

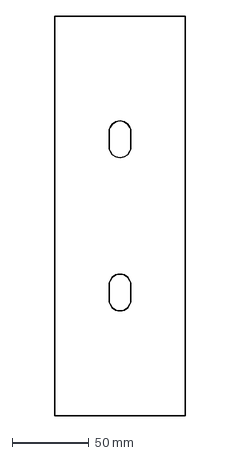
[picture p17: CAD file, 2026-11-08]
plans/dxf/ESC-250.dxf
85.0 x 261.0 mm
