mj42584/staircase_solidcraft_claude/plans/Natif/ESC-802.FCStd

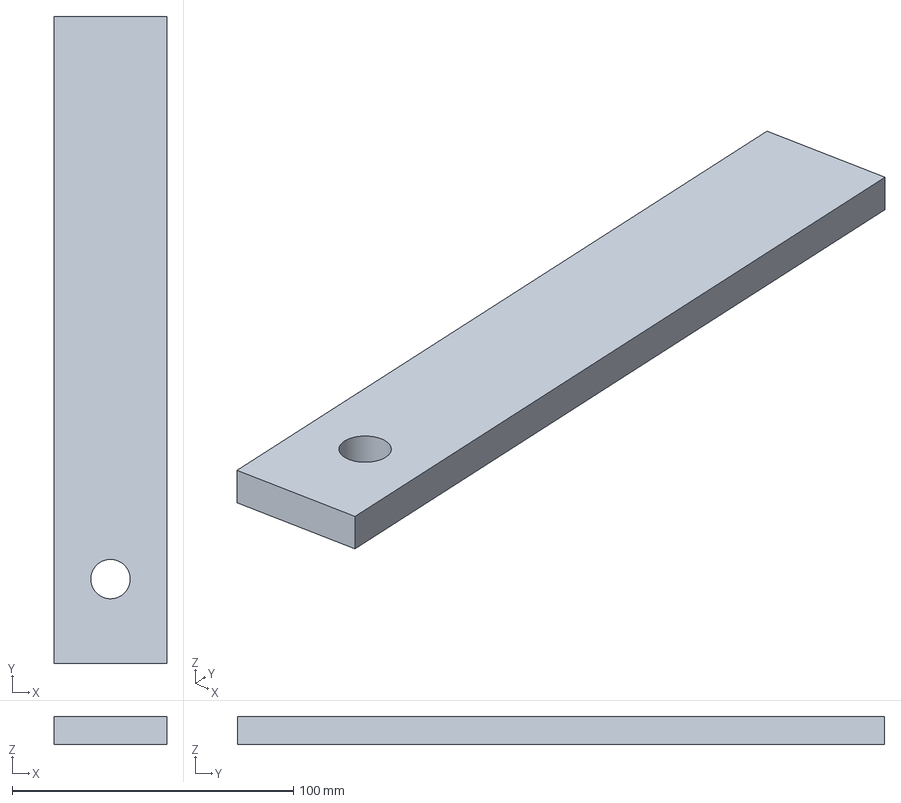
[picture p18: CAD file, 2026-11-08]
plans/Natif/ESC-802.FCStd
40.0 x 230.0 x 10.0 mm
