mj42584/staircase_solidcraft_claude/plans/dxf/ESC-261.dxf

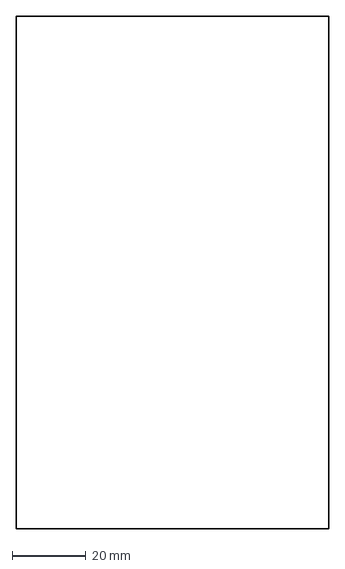
[picture p19: CAD file, 2026-11-08]
plans/dxf/ESC-261.dxf
85.0 x 139.5 mm
