mj42584/staircase_solidcraft_claude/plans/Natif/ESC-402.FCStd

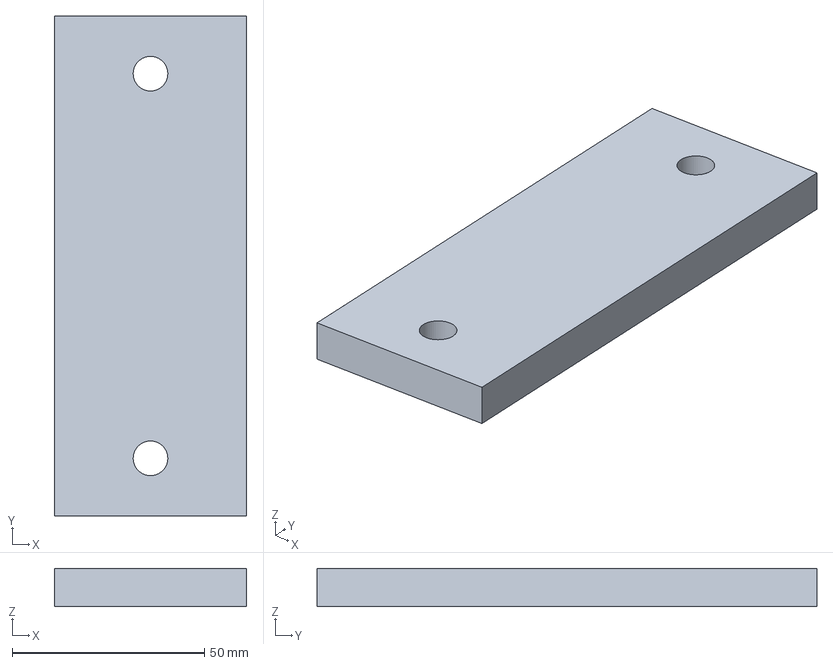
[picture p20: CAD file, 2026-11-08]
plans/Natif/ESC-402.FCStd
50.0 x 130.0 x 10.0 mm
