mj42584/staircase_solidcraft_claude/plans/dxf/ESC-802.dxf

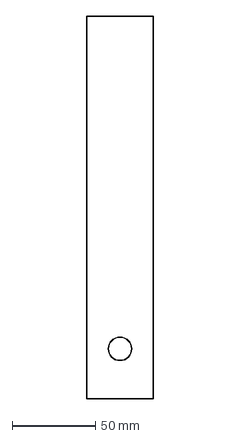
[picture p21: CAD file, 2026-11-08]
plans/dxf/ESC-802.dxf
40.0 x 230.0 mm
