mj42584/staircase_solidcraft_claude/plans/Natif/ESC-261.FCStd

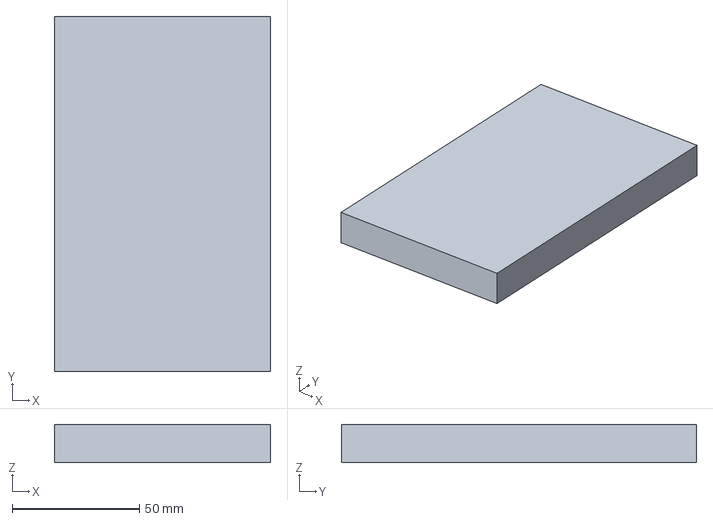
[picture p22: CAD file, 2026-11-08]
plans/Natif/ESC-261.FCStd
85.0 x 139.5 x 15.0 mm
