mj42584/staircase_solidcraft_claude/(list of files, cad)

Other CAD files:
archive/freecad/escalier-gab.FCStd
