mj42584/staircase_solidcraft_claude/plans/ESC-250.pdf

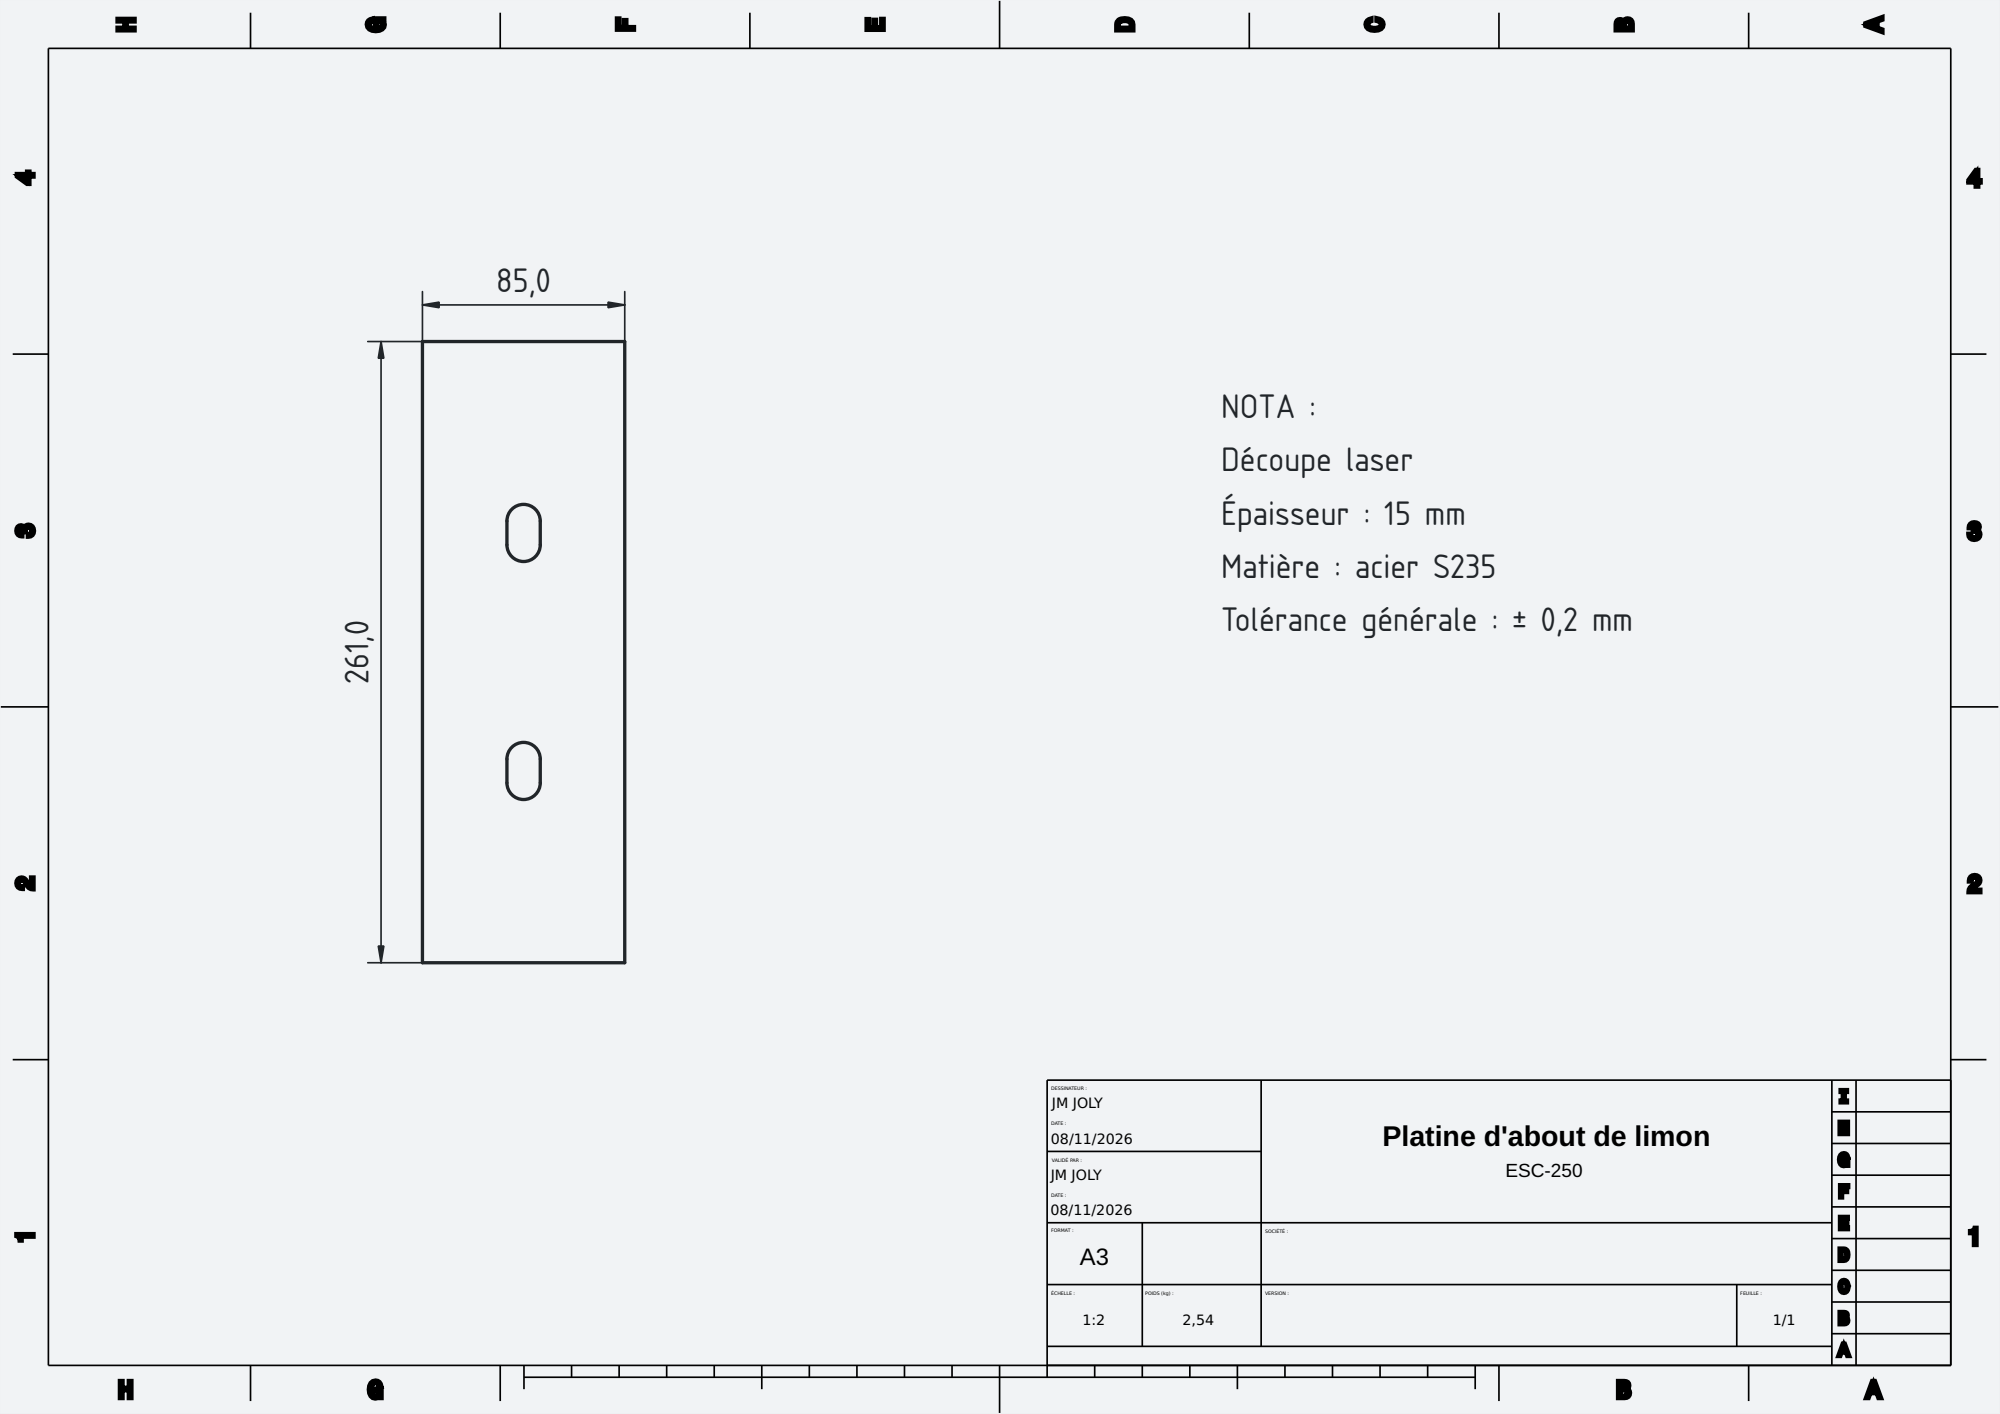
[picture p23: page 1]
JM JOLY; DESSINATEUR :; VALIDÉ PAR :; DATE :

NOTA :
Découpe laser
Épaisseur : 15 mm
Matière : acier S235
Tolérance générale : ± 0,2 mm

Platine d'about de limon

FORMAT : A3 | | SOCIÉTÉ :

ÉCHELLE : 1:2 | POIDS (kg) : 2,54 | VERSION : | FEUILLE : 1/1
