mj42584/staircase_solidcraft_claude/plans/ESC-260.pdf

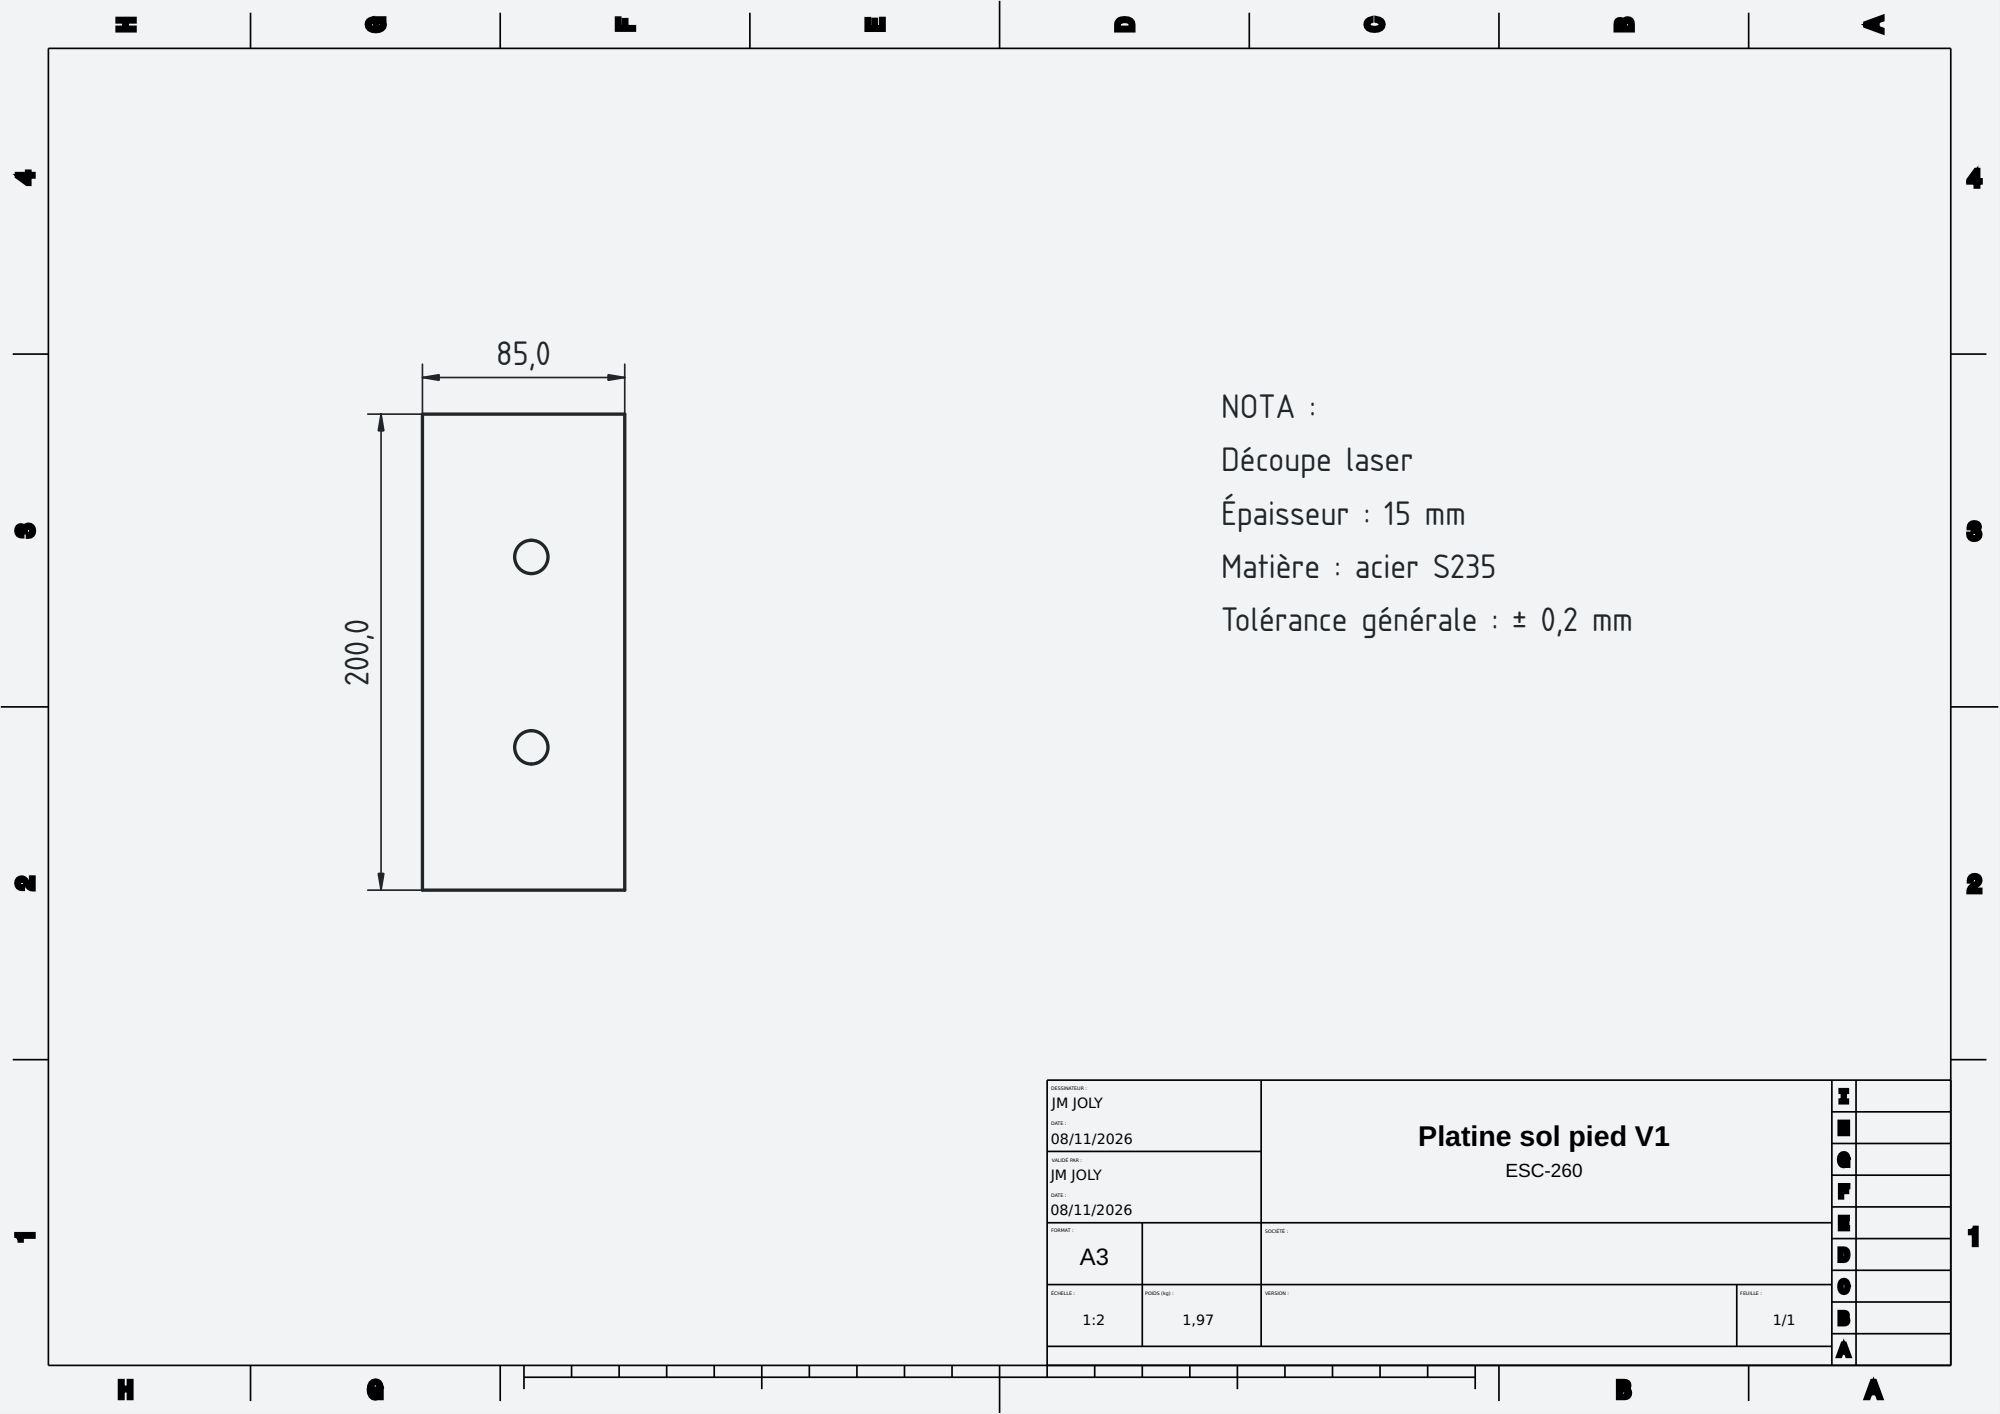
[picture p24: page 1]
JM JOLY; DESSINATEUR :; VALIDÉ PAR :; DATE :

NOTA :
Découpe laser
Épaisseur : 15 mm
Matière : acier S235
Tolérance générale : ± 0,2 mm

Platine sol pied V1

FORMAT : A3 | | SOCIÉTÉ :

ÉCHELLE : 1:2 | POIDS (kg) : 1,97 | VERSION : | FEUILLE : 1/1
