mj42584/staircase_solidcraft_claude/plans/ESC-304.pdf

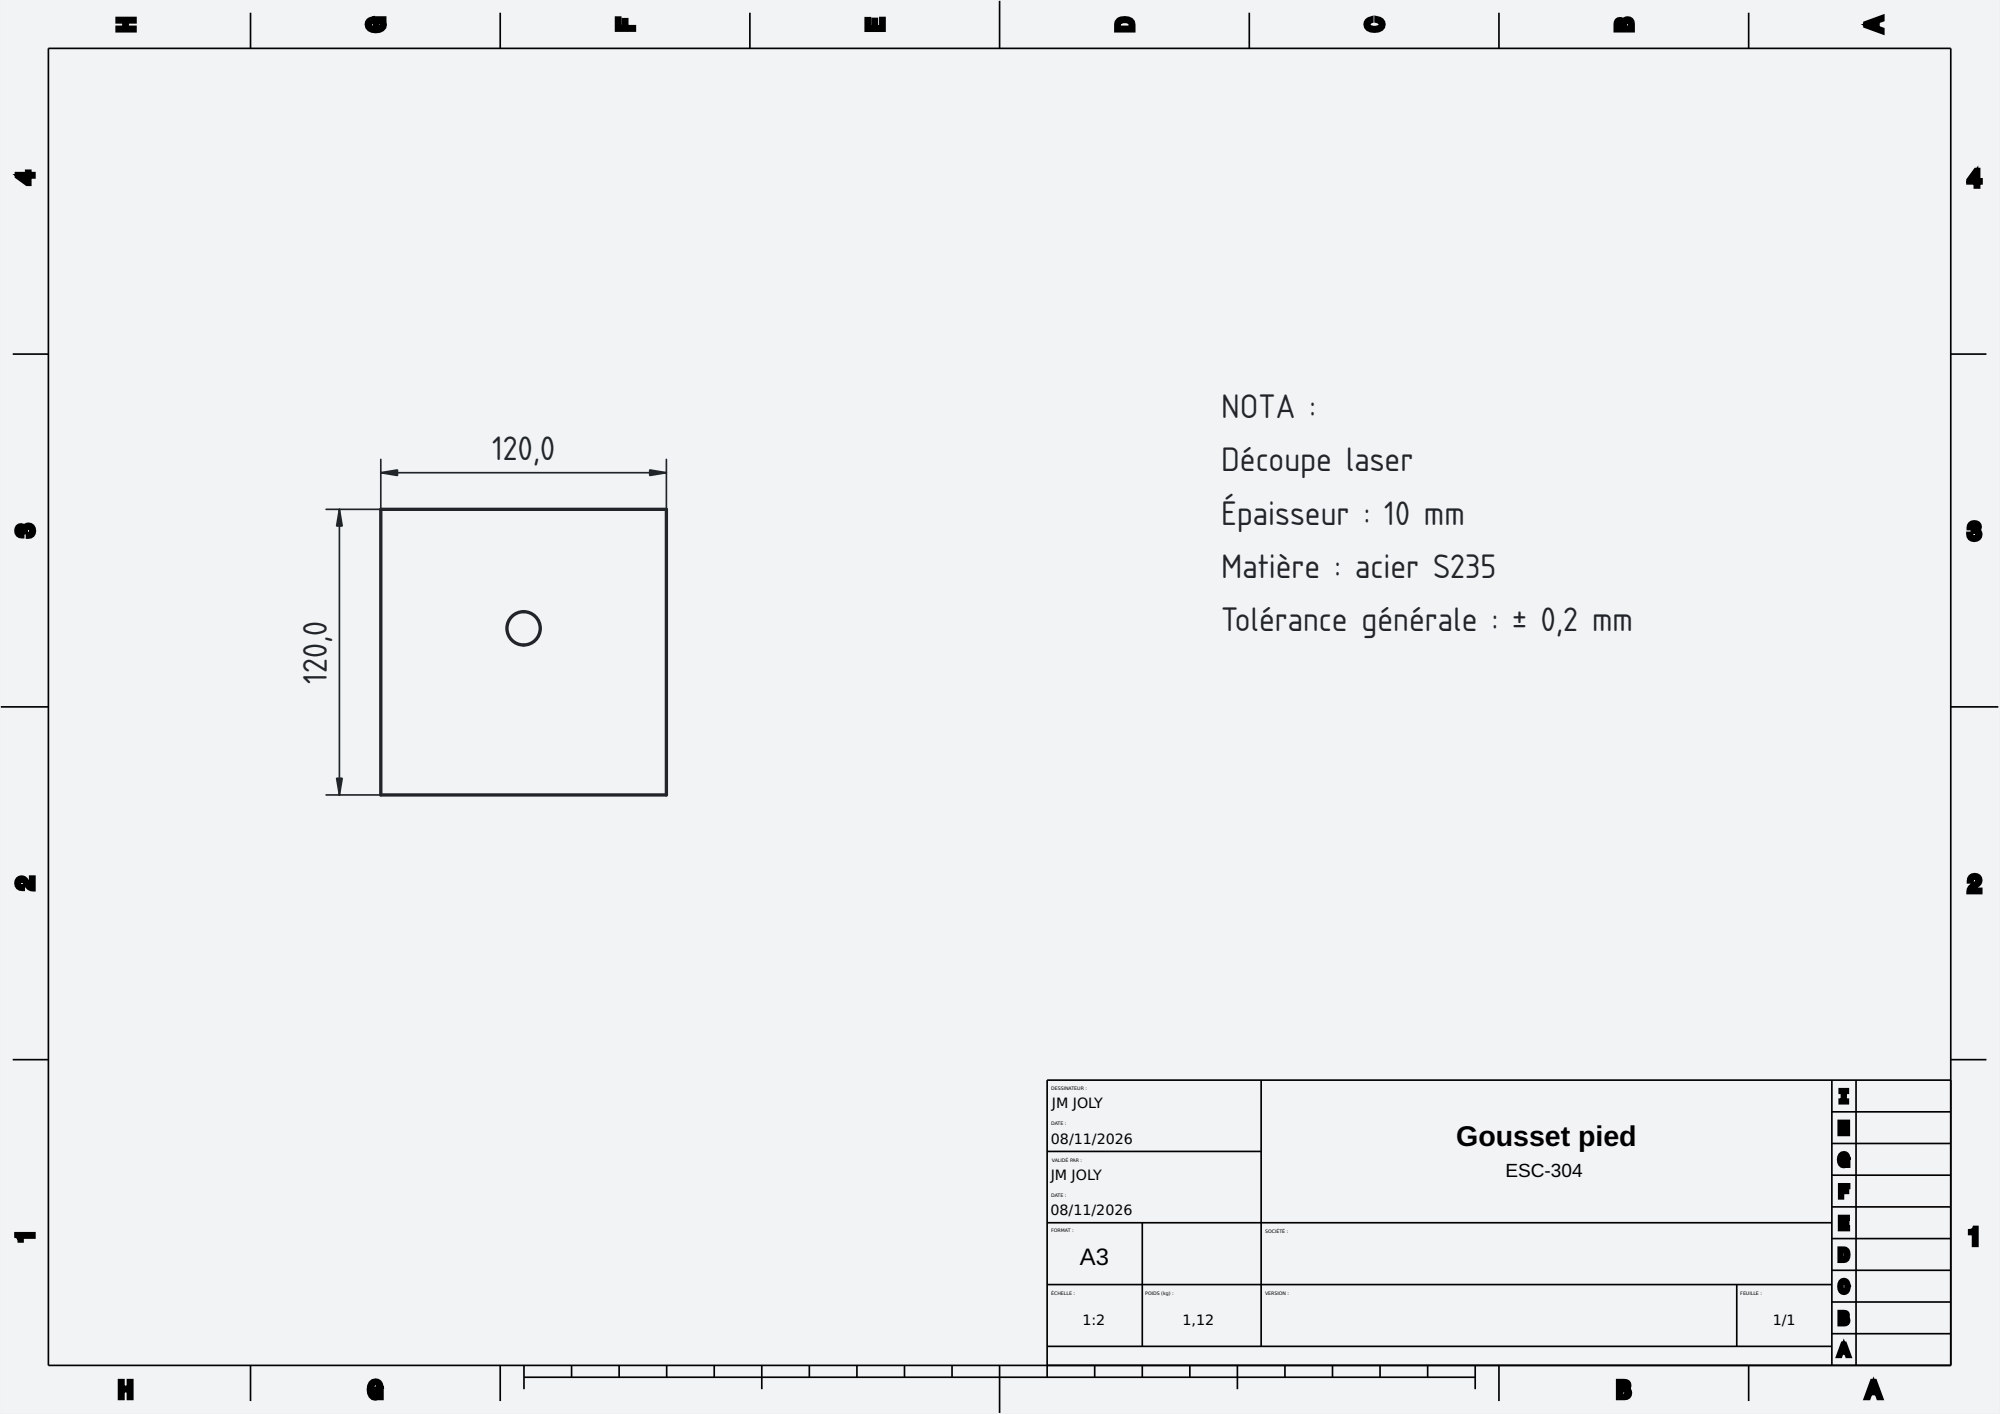
[picture p28: page 1]
JM JOLY; Gousset pied; DESSINATEUR :; VALIDÉ PAR :; DATE :

NOTA :
Découpe laser
Épaisseur : 10 mm
Matière : acier S235
Tolérance générale : ± 0,2 mm

FORMAT : A3 | | SOCIÉTÉ :

ÉCHELLE : 1:2 | POIDS (kg) : 1,12 | VERSION : | FEUILLE : 1/1
