mj42584/staircase_solidcraft_claude/plans/ESC-402.pdf

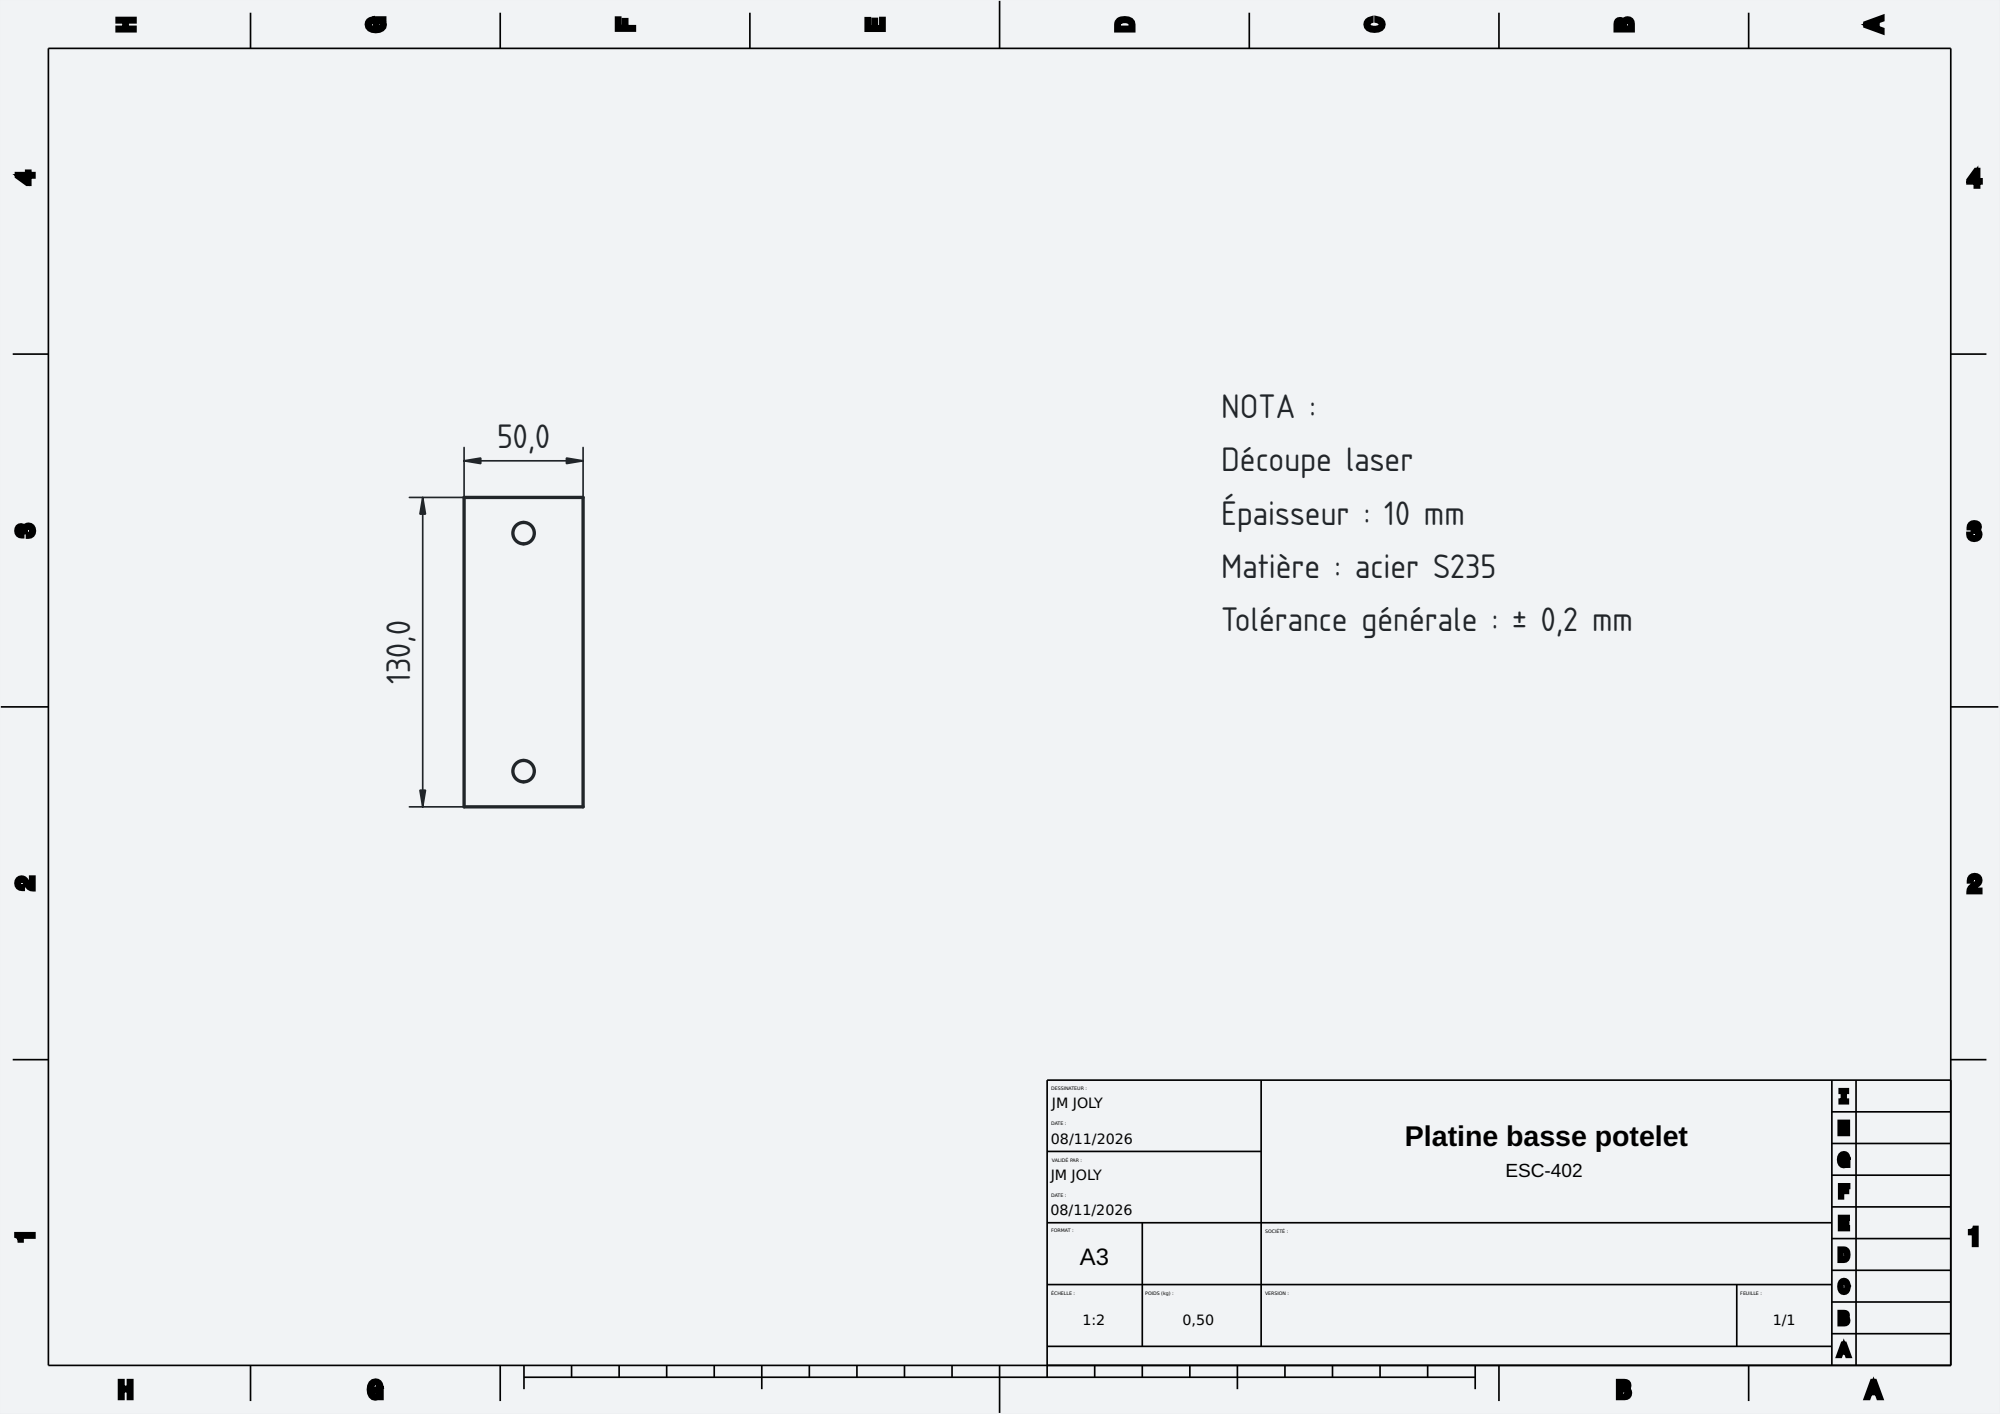
[picture p29: page 1]
JM JOLY; DESSINATEUR :; VALIDÉ PAR :; DATE :

NOTA :
Découpe laser
Épaisseur : 10 mm
Matière : acier S235
Tolérance générale : ± 0,2 mm

Platine basse potelet

FORMAT : A3 | | SOCIÉTÉ :

ÉCHELLE : 1:2 | POIDS (kg) : 0,50 | VERSION : | FEUILLE : 1/1
