mj42584/staircase_solidcraft_claude/plans/ESC-403.pdf

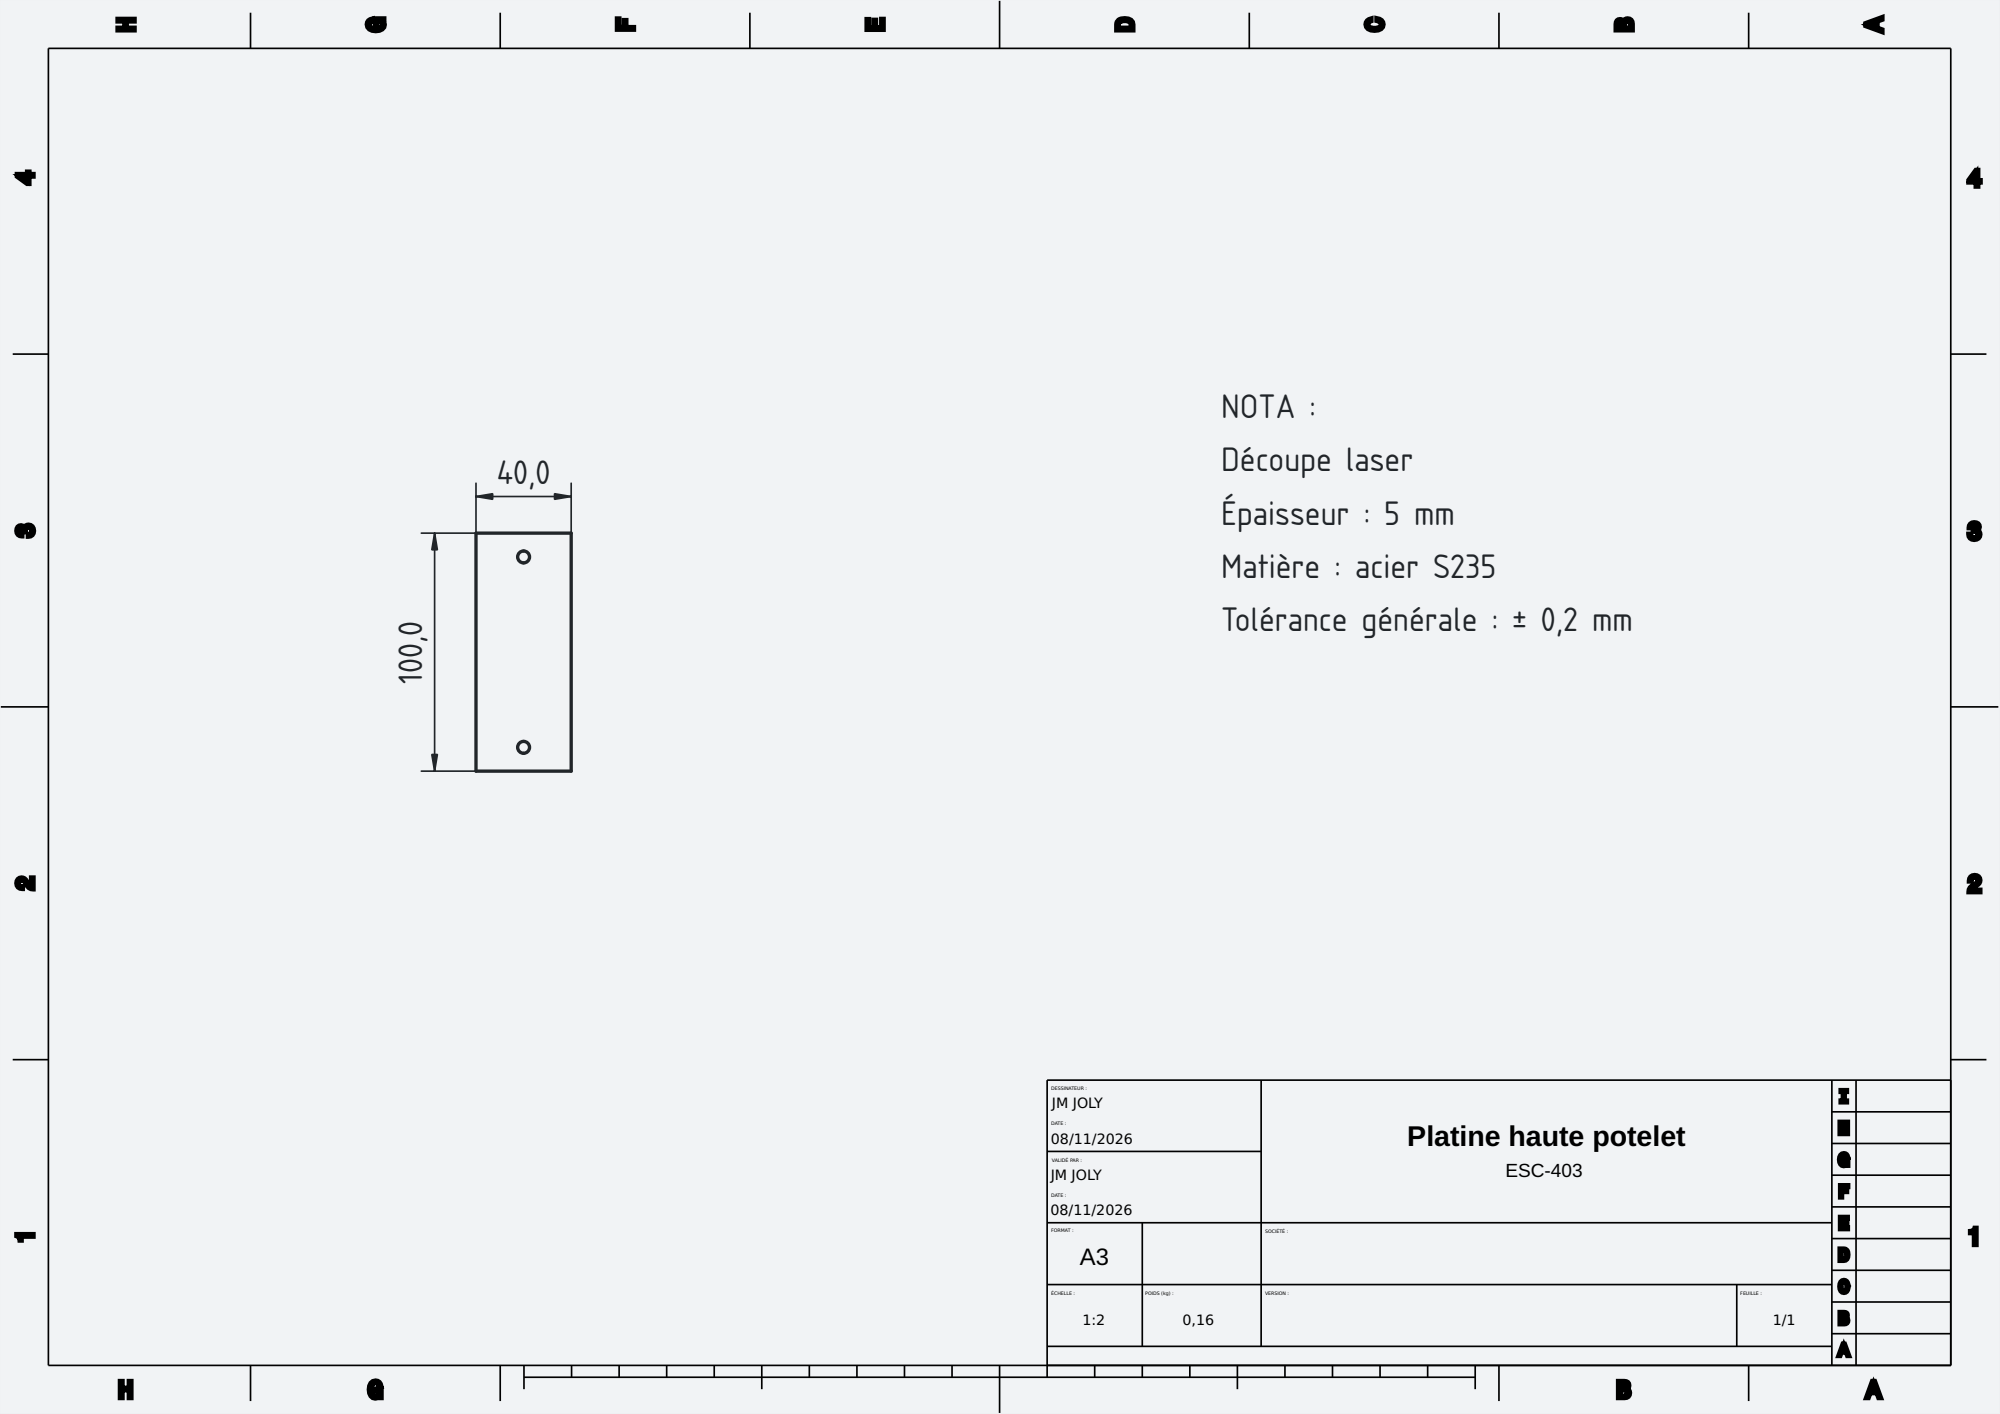
[picture p30: page 1]
JM JOLY; DESSINATEUR :; VALIDÉ PAR :; DATE :

NOTA :
Découpe laser
Épaisseur : 5 mm
Matière : acier S235
Tolérance générale : ± 0,2 mm

Platine haute potelet

FORMAT : A3 | | SOCIÉTÉ :

ÉCHELLE : 1:2 | POIDS (kg) : 0,16 | VERSION : | FEUILLE : 1/1
