mj42584/staircase_solidcraft_claude/(commit log)

2026-10-27 Import de l'escalier gab (dernière version, sans historique)
    Claude-Session: https://claude.ai/code/session_01Uhn9WHJHGRZkV7WAgLqiy9
    [escalier-gab.FCStd]
2026-10-27 README remanié : aperçu, vue 3D STL, résumé du calcul
    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
    [escalier.stl]
2026-10-27 CONCEPTION : SolidCraft 0.24.1 et état des lieux à chaque mise à jour
2026-10-27 Projet escalier : assemblage environnement + escalier, hauteur 3848, répartition 16/6
    - escalier : hauteur_totale 3848 (mesure site), marches de 60 mm, 16/6
    - projet_escalier.solidcraft : composants liés, escalier plaqué contre la
    poutre d'arrivée et sur la dalle, fixé
    - CONCEPTION : décalage, collisions restantes, hauteur libre au-dessus de V1
2026-10-27 Export STL du projet, nouvel aperçu et README à jour
    - cad/projet_escalier.stl : escalier dans son environnement
    - cad/escalier.stl : réexporté, escalier seul en 16/6 à 3848
    - cad/apercu.png : vue côté V1 avec la mezzanine
    - README : liens 3D vers le projet, valeurs actuelles, calcul non relancé
    [escalier.stl, projet_escalier.stl]
2026-10-28 CONCEPTION : retrait des mentions de FreeCAD (§4, D2, D6, §6, §7, §8)
    FreeCAD n'est plus utilisé sur le projet ; l'historique (§9) et archive/freecad/ sont conservés.
    Claude-Session: https://claude.ai/code/session_01Uhn9WFx1bJiKtUWepfHK1r
2026-10-28 CONCEPTION §6 : règle sur des réponses synthétiques
    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
2026-10-28 CONCEPTION : §6 réécrit et corrections de l'audit
    §6 en 5 sous-parties (autorisations, déroulé d'une tâche, tenue du fichier,
    outils et versions, pièges). Valeurs passées à 16/6 et 60 mm, contradictions
    levées, §7 : calculs à relancer, effets de palier_ep 60 à vérifier.
    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
2026-10-28 Règles de l'agent sorties dans REGLES_AGENT_3D.md (génériques)
    CONCEPTION §6 réduit aux outils, fichiers et pièges du projet ; pièges
    dédoublonnés ; AGENTS.md et README pointent vers les deux fichiers.
    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
2026-10-28 CONCEPTION : chasse aux doublons
    §2 réduit à l'origine des données, environnement et projet en fin de §4,
    état des lieux des outils en §6.4, §7 limité aux points ouverts, attentes
    regroupées au §8.
    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
2026-10-28 README allégé : vitrine et fonctionnement du projet
    Chapitres en doublon de CONCEPTION.md retirés ; ajout de « Comment le
    projet est fait » (SolidCraft, Claude Code, connecteur MCP, travail à deux).
    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
2026-10-28 REGLES_AGENT_3D §6 : renommer tous les éléments créés
    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
2026-10-28 REGLES_AGENT_3D §6 : sept règles de modélisation
    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
2026-10-28 Exports à jour : règle, « fusion (merge) » et contrôle GitHub Actions
    REGLES_AGENT_3D §2 étape 6 : régénérer les exports avant de proposer la
    fusion. Le workflow exports.yml met en échec une PR qui modifie un
    .solidcraft sans ses exports. D7 renvoie au workflow.
    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
2026-10-28 Exports : régénérer seulement si la géométrie 3D change
    Étiquette geometrie-inchangee sur la PR pour passer le contrôle.
    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
2026-10-28 Contrôle GitHub des exports retiré ; D7 liste les exports
    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
2026-10-28 REGLES_AGENT_3D §3 : plan du fichier de conception
    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
2026-10-28 REGLES_AGENT_3D : corrections de l'audit
    Ordre des étapes (exports et doc avant le commit), rien d'écrit avant la
    branche, demande de fusion définie ; principes : aucune donnée inventée,
    statut des calculs.
    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
2026-10-28 REGLES_AGENT_3D : règles indépendantes de Git (Git, PLM, gestionnaire de fichiers)
    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
2026-10-28 Renommage « versions des logiciels » (distinct de la version de référence du projet)
    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
2026-10-29 Palier à 60 mm : platines côté palier jusqu'au bas de la poutre, trous recentrés
    - boulons_entraxe 100 -> 80
    - trous côté palier (platines V1, V2, poutre avant) centrés sur le milieu de la poutre avant
    - Profil platine V1 / palier V2 : bas au bas de la poutre avant
    - avertissement booléen de Trous poutre avant disparu, 0 erreur
    - STL régénérés, CONCEPTION à jour
    [escalier.stl, projet_escalier.stl]
2026-10-29 Limons descendus de 30 mm : bout du limon V1 centré sur la poutre avant
    - limon_dessus = -30 mm * giron / pas_volee (D17)
    - platines côté palier revenues à la section du limon, entraxe 100
    - V2 à +19 mm, platine V2 sous le plancher, équerres hors du congé
    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
    [escalier.stl, projet_escalier.stl]
2026-10-29 Refonte des esquisses : lignes cotées, limons depuis le squelette, cotes nommées
    - 16 esquisses (plancher, pieds, cadre, platines, limons) redessinées en
    lignes cotées, plus aucun point défini par une expression
    - limons : ligne des nez du squelette projetée, bords parallèles cotés
    - paramètres rive_x, cadre_y, limon_hv ; 194 cotes renommées <pièce>_<rôle>
    - géométrie identique (82 corps), balayages sans échec, exports inchangés
2026-10-29 Prototype : limon V1 en Frame Member (UPE avec congés), paramètres de fonctions renommés
2026-10-29 Limons V2 et pieds en Frame Member, projet et exports à jour
    - limons V2 : profilé UPE avec congés, coupes d'extrémité cotées
    - pieds : tubes 100x100x5 (rayon poteau_r supposé), plans et axes cotés
    - paramètres poteau_r, pied_h ; nouveaux dN renommés
    - encombrements identiques, 0 erreur, 0 interférence, balayages OK
    - STL régénérés
    [escalier.stl, projet_escalier.stl]
2026-10-29 Double enregistrement des modèles : .solidcraft et .json
    - cad/escalier.json, cad/environnement.json, cad/projet_escalier.json
    - règle au §6.2 de CONCEPTION et à l'étape 6 de REGLES_AGENT_3D
    - pièges : relink refuse un .json, matériaux perdus par le lien
2026-10-30 Mise à jour SolidCraft 0.24.1 → 0.27.1
    Modèles contrôlés et réenregistrés en format 44 (.solidcraft + .json).
    Corps des réseaux de marches renommés selon leur position et matériaux
    réaffectés (valable en 16/6, piège noté dans CONCEPTION.md).
2026-10-30 Mains courantes en chêne sur potelets, des deux côtés des volées
    4 mains courantes Ø45 à 900 mm au-dessus des nez, 12 potelets en fer
    plat (profil et nombre supposés) logés dans le U des limons. Frame
    Member, symétries de corps puis un réseau par corps. Projet, exports
    et CONCEPTION.md (D18) à jour.
    [escalier.stl, projet_escalier.stl]
2026-10-30 Main courante autour du palier, continue avec celles des volées
    À 1000 mm au-dessus du plancher, sur les trois côtés ouverts, raccordée
    aux mains courantes ext de V1 et V2 (coudes en Pipe). 5 potelets posés
    sur le plancher. CONCEPTION.md (D18), projet et exports à jour.
    [escalier.stl, projet_escalier.stl]
2026-10-30 Mains courantes et potelets au milieu des limons
    Plans des mains courantes au milieu des limons et de la poutre arrière
    du palier ; potelets posés sur l'aile haute. Projet, exports et
    CONCEPTION.md à jour.
    [escalier.stl, projet_escalier.stl]
2026-10-30 Platines soudées des potelets, perçages des limons et du palier
    Platine basse 100 × 50 × 8 boulonnée M8 sur l'aile du limon (ou à
    travers plancher et cadre au palier), platine haute 80 × 30 × 5 vissée
    sous la main courante. Potelets coupés en biais sur les volées. Piège de
    lenteur du perçage des limons V1 noté dans CONCEPTION.md.
    [escalier.stl, projet_escalier.stl]
2026-10-30 Platines des potelets allongées pour l'accès aux vis
    Platine basse 130 mm (entraxe 100), platine haute 100 mm (entraxe 80) :
    place pour la tête de vis et l'outil à côté du potelet.
    [escalier.stl, projet_escalier.stl]
2026-10-30 Potelets en tube 30 × 30 × 2 (en cours)
    Les 4 potelets passent en tube carré, enfoncés de 1 mm dans leurs
    platines pour que l'union tienne. Non terminé : trous des limons
    suspendus, interférences et balayages à refaire (noté dans CONCEPTION.md).
    [escalier.stl, projet_escalier.stl]
2026-10-30 Vitesse de recalcul : limons sans congés, potelets plus enfoncés dans les platines basses
    Recalcul complet de l'escalier 50 s → ≈ 30 s : limon_r 13 → 0 (D19),
    pénétration des potelets dans les platines basses 1 → 3 mm, dossier de
    timeline pour suspendre les trous des limons et du palier. Diagnostic
    et issue SolidCraft notés dans CONCEPTION §6.3.
    [escalier.stl, projet_escalier.stl]
2026-10-31 Enregistrement direct dans cad/ par le connecteur (--allow-path)
2026-10-31 Mains courantes carrées 45 × 45, main courante ext d'une seule pièce
    - mc_d → mc_cote ; barres en profilé carré plein
    - Pipe ronds du palier remplacés par des balayages carrés joints aux
    mains courantes ext V1/V2 (une pièce de la volée au fond, coudes en onglet)
    - 0 erreur, 0 interférence ; exports et CONCEPTION.md à jour
    [escalier.stl, projet_escalier.stl]
2026-10-31 Tests de paramètres hors de l'app avec solidcraft-cli
2026-10-31 Enregistrement allégé : .solidcraft seul, sans exports ; tests en ligne de commande dans les règles
    [escalier.stl, projet_escalier.stl]
2026-10-31 Règles sorties de CONCEPTION.md : pièges de SolidCraft, nommage, enregistrement
2026-10-31 Platines de tête des pieds du palier, boulonnées sous le cadre (2 M12)
2026-10-31 Platines de tête des pieds en corps séparés, comme celles des limons
2026-10-31 Platines au sol des pieds du palier (15 mm, 4 chevilles M12), corps séparés
2026-10-31 Règles : plus de mise à jour du projet d'assemblage à chaque tâche
2026-10-31 Répartition 15/7 : corps des réseaux renommés selon leur position, matériaux réaffectés
2026-10-31 Projet recalé en 15/7 : escalier décalé à X = −1918, seule la collision connue
2026-11-01 Ensembles soudés avec leurs fonctions : perçages scindés, un Frame Member par pied
2026-11-01 Potelets : 2 ensembles posés 12 et 5 fois, liés aux trous
    Ensemble potelet volée (12) et Ensemble potelet palier (5), esquisses dans
    leur repère ; liaisons rigides aux trous des limons et du cadre ; ancien arbre
    des potelets supprimé, perçages gardés à la racine.
2026-11-01 Potelets en 3 corps (tube, platine basse, platine haute)
    Ensembles potelet volée et palier en « inseparable » à 3 corps ; tube prolongé
    puis coupé au ras des platines (plus de pénétration).
2026-11-01 Mesures de vitesse après les ensembles
2026-11-01 Mise à jour SolidCraft 0.27.1 → 0.29.0 : modèles contrôlés et réenregistrés au format 46
2026-11-01 Format 46 réel, tests de check_parameters, expect et oblongs cotés
2026-11-01 Tests 0.29 : masse par exemplaire, nomenclature, noms Frame Member, interférences du projet
2026-11-01 Essai de sous-composants imbriqués : nomenclature des pièces des ensembles
2026-11-01 Esquisses et éléments de construction masqués
2026-11-01 Références ESC-xxx sur toutes les pièces et ensembles
2026-11-01 Règles : méthode de réorganisation, références, masquage, copie d'exemplaire
2026-11-01 Mesure de vitesse après un composant par pièce
2026-11-01 Main courante int V2 rallongée jusqu'au X du haut de int V1
2026-11-01 Potelets latéraux du palier à 215 mm du bord avant
2026-11-02 Lien de la PR #28 dans l'historique
2026-11-02 Potelets d'angle du fond : vis rentrées sous la main courante du fond
    Paramètre potelet_fond_marge (25 mm, supposé) ; pas de la répétition
    du fond piloté par potelet_fond_y ; liaison Potelet fond n°1 / cadre
    reprise sur la poutre arrière. D24.
2026-11-02 Lien de la PR #29 dans l'historique
2026-11-02 Premier potelet de int V2 en face du dernier de int V1
    Esquisse Perçage limon int V2 (trous int V2 à part, paire basse
    alignée sur le potelet :8) ; Trous limon int V2 y pointe. Porte-à-faux
    408 → 149 mm. Retrait fixe des potelets du palier accepté (D23). D25.
2026-11-02 Lien de la PR #30 dans l'historique
2026-11-02 Potelets arrière sur les mains courantes latérales du palier
    Ensemble potelet palier :6 et :7 à potelet_palier_retrait du bord
    arrière, 4 trous dans Perçage palier, liaisons au cadre. D26.
2026-11-02 Lien de la PR #31 dans l'historique
2026-11-02 Point ouvert : accès à toutes les vis pour le montage
    Nombre de potelets validé, distance au poteau recalculée en carré,
    accès aux écrous des limons regroupé dans le nouveau point.
2026-11-02 Lien de la PR #32 dans l'historique
2026-11-02 Potelets de volée verticaux quel que soit le giron ; revue du §7
    Platine basse à plat dans le composant, tube incliné de angle_volee,
    liaisons au centre du trou de la platine (D27). Points fermés ou mis en
    suspens dans CONCEPTION.md.
2026-11-02 Lien de la PR #33 dans l'historique
2026-11-02 Points fermés : masse totale, nombre fixe d'exemplaires, noms des limons
2026-11-02 Lien de la PR #34 dans l'historique
2026-11-02 Pied des limons V1 : platine verticale et platine au sol
    Limons V1 raccourcis de pied_limon_ep ; platines soudées en composants
    dans les ensembles limon ext / int V1, 2 trous M12 dans le U. D28.
2026-11-02 Lien de la PR #35 dans l'historique
2026-11-02 Stabilité du palier recalculée : pieds de limons V1 articulés, poussée des mains courantes
    predim.py et portique.py en 3848 / 15/7 / 60 mm ; tête des pieds rigide puis
    articulée ; palier souple en travers sans contreventement (D29).
2026-11-02 Lien de la PR #36 dans l'historique
2026-11-02 Rapport de calcul en PDF ; limons en flexion forte + faible, signe de N des pieds corrigé
    calc/rapport_calcul.pdf (source calc/rapport/rapport_calcul.html, figures
    calc/rapport/figures.py) remplace le rapport du 27 octobre. portique.py :
    poussée dans le sens des défauts, limons V1/V2 vérifiés avec la flexion
    d'axe faible, effort normal des pieds compté en compression (PyNite),
    auto-contrôle du signe.
2026-11-03 Contreventement du palier : une diagonale en tube par face d'about (D30)
2026-11-03 Lien de la PR #37 dans l'historique
2026-11-03 Suite de la revue externe du calcul : chevilles, équilibre, potelets (D31)
    predim.py : poids des mains courantes et potelets, flexion des potelets et
    traction des vis M8 de leur platine basse. portique.py : efforts par
    cheville, assertion d'équilibre pour chaque combinaison, torsion des
    limons seuls (hors modèle). Rapport mis à jour avec les diagonales (D30)
    et le suivi de la revue ; garde-corps non conforme (potelets 255 %).
2026-11-03 Diagonales du palier dans le 3D : goussets sur les pieds, ensemble diagonale posé 2 fois (D30)
2026-11-03 Calcul du palier recalé sur les trous des goussets : diagonales 3,00 m à 25 % (D30)
2026-11-03 Potelets de volée : 5 par main courante sur V1, 3 sur V2 (D32) ; essai des marches comme traverses dans portique.py
2026-11-03 Cornières des marches en 50 x 50 x 5 (D33)
2026-11-03 Potelets en tube 40x40x3 et un potelet de plus au fond (D34)
2026-11-03 predim : poids des potelets 40x40x3 et controle des potelets de V2 (D34)
2026-11-03 k des liaisons marche-cornière calculé pour 3 vis à bois par cornière (predim, portique)
2026-11-03 Rapport et historique : k des liaisons marche-cornière pour 3 vis à bois
2026-11-03 Lien de la PR #39 dans l'historique
2026-11-03 Trous des vis à bois des cornières dans les marches et les cornières (D35)
2026-11-03 portique : limon_dessus dans l'axe des limons ; visu.py relancé (PyVista)
2026-11-03 Diagonales en tube 40x40x3 (D36) : calcul, modèle, rapport
2026-11-03 Lien de la PR #42 dans l'historique
2026-11-03 Chevilles des pieds : vérification avec hypothèses C25/30 (D37)
2026-11-03 Lien de la PR #43 dans l'historique
2026-11-03 Lien de la PR #44 dans l'historique
2026-11-03 Vérifications locales (assemblages.py) et une seule volée chargée (D38)
2026-11-03 Lien de la PR #45 dans l'historique
2026-11-03 Platine basse des potelets en 10 mm (D39)
2026-11-03 Lien de la PR #46 dans l'historique
2026-11-03 Suite de la seconde revue externe du calcul (D40)
2026-11-03 Lien de la PR #47 dans l'historique
2026-11-07 Jeu entre limons 200 mm et limite d'accès dans l'environnement
    Modifications faites à la main dans SolidCraft 0.30.1 (format 48) :
    - escalier : jeu_limons 100 → 200 (demi-jour 185, palier 2370).
    - environnement : plan « Limite pour acces » (mur −3000), esquisse et
    découpe (Sketch1, Extrude1).
2026-11-07 Lien de la PR #49 dans l'historique
2026-11-07 Mise au propre 0.30.1 : modèles sans cache, ouverture d'accès renommée
    - escalier, environnement et projet réenregistrés sans cache de géométrie
    (format 48) ; esquisses et construction masquées.
    - environnement : Sketch1 → Esquisse ouverture acces, Extrude1 →
    Ouverture acces, d54…d58 → acces_limite, acces_h, acces_l,
    acces_retrait, acces_coupe.
    - CONCEPTION.md : commande de lancement avec --share=network.
2026-11-08 Références des platines de pied V1 : ESC-260 et ESC-261
    Pose les références sur les 4 composants (sol et verticale, ext et int)
    pour qu'aucune pièce de la nomenclature ne reste sans référence.
2026-11-08 Lien de la PR #51 dans l'historique
2026-11-08 Référence ESC-251 pour les 2 platines palier V2
    Même contour qu'ESC-250, mais oblongs décalés de 19,15 mm : ESC-250
    passe à 4 pièces.
2026-11-08 Lien de la PR #52 dans l'historique
2026-11-08 Règles de génération des plans de pièces (§9) et dossier plans
    Contrôle des pièces d'une même référence, contenu d'un plan laser,
    cartouche A3, génération FreeCAD et vérifications avant livraison.
    Ajoute plans/ avec les plans ESC-250 et ESC-251 (PDF et FCStd).
    [ESC-250.FCStd, ESC-251.FCStd]
2026-11-08 Nomenclature de l'escalier versionnée (tableur ODS)
    [nomenclature_escalier.ods]
2026-11-08 Lien de la PR #53 dans l'historique
2026-11-08 Fusion de ESC-104 dans ESC-103 (poutres latérales identiques)
    [nomenclature_escalier.ods]
2026-11-08 Lien de la PR #54 dans l'historique
2026-11-08 Oblongs identiques sur les 6 platines d'about, ESC-251 fusionnée dans ESC-250
2026-11-08 ESC-250 : nomenclature, plan régénéré, plan ESC-251 supprimé
    [ESC-250.FCStd, ESC-251.FCStd, nomenclature_escalier.ods]
2026-11-08 Lien de la PR #55 dans l'historique
2026-11-08 Plans de découpe laser des 9 tôles, acier S235 confirmé
    [ESC-250.FCStd, ESC-260.FCStd, ESC-261.FCStd, ESC-302.FCStd, ESC-303.FCStd, ESC-304.FCStd, ESC-402.FCStd, ESC-403.FCStd]
2026-11-08 Lien de la PR #56 dans l'historique
2026-11-08 DXF de découpe laser des 9 tôles
    [ESC-250.dxf, ESC-260.dxf, ESC-261.dxf, ESC-302.dxf, ESC-303.dxf, ESC-304.dxf, ESC-402.dxf, ESC-403.dxf]
2026-11-08 Fichiers FreeCAD des plans rangés dans plans/Natif
    [ESC-250.FCStd, ESC-260.FCStd, ESC-261.FCStd, ESC-302.FCStd, ESC-303.FCStd, ESC-304.FCStd, ESC-402.FCStd, ESC-403.FCStd]
